Morfey1974/Industrial-Door-PLC-8-Doors/DcmakingCatalog/src/assets/hero-bg.jpg

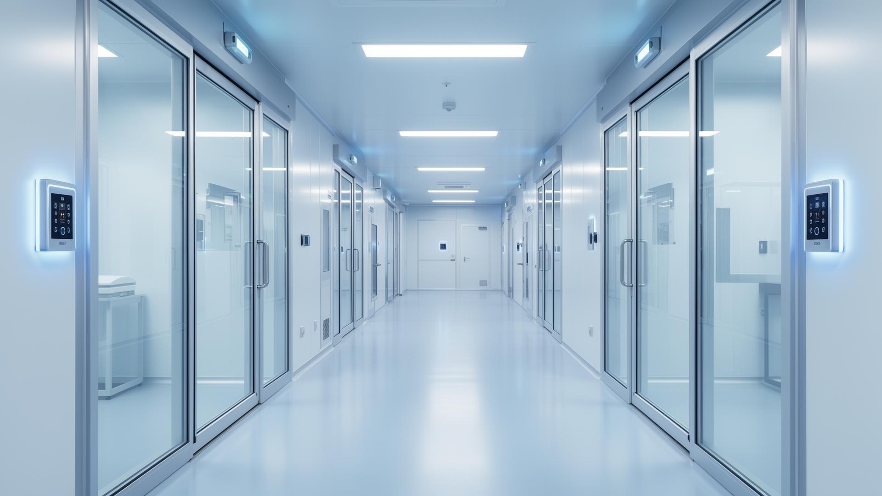
DcmakingCatalog/src/assets/hero-bg.jpg
