Morfey1974/Industrial-Door-PLC-8-Doors/README.md

# Industrial Door PLC

**Название проекта:** Industrial Door PLC — прошивка и Web‑интерфейс промышленного контроллера дверей.

**Цели проекта:** Управление электронными замками дверей в чистых помещениях (NO/NC-логика), зависимостями между дверями, конфигурирование и мониторинг через Web без программирования. Реализация по тезисному плану (этапы 0–14).

**Структура проекта:**
- **`Core/`** — STM32 HAL, FreeRTOS, bring-up (LwIP, CAN, RS-485, QSPI). Тик RTOS: **TIM6** → `xPortSysTickHandler` (см. `Core/Src/main.c`).
- **`BSP/`** — GPIO (двери, замки, LED, кнопки), до **8 дверей на одну плату** (`BSP_DOOR_MAX`).
- **`App/doors/`** — модель двери, DoorTask, DoorHAL; таймауты открытия/после закрытия, сигнализация, спецификация NC (окно разблокировки, задержка блокировки после закрытия).
- **`App/logic/`** — Logic Core, глобальные ID дверей 1…80, зависимости (edges), блокировки по зависимостям; снимок состояния удалённых дверей и **сигнализации с CAN** для API.
- **`App/system/`** — задачи RTOS (net, CAN, RS-485, HTTP, logger, watchdog, supervisor, comms, journal), EventBus, HTTP API/сервер, пользователи.
- **`App/config/`** — формат конфигурации, QSPI (конфиг слоты A/B, маппинг, пользователи), SHA-256, RNG.
- **`App/log/`** — журнал событий в QSPI.
- **`App/drivers/`** — внешняя RTC **DS3231** (I2C), сервис времени (`rtc_service`), опционально задача проверки (`rtc_test_task`).
- **`WebUI/`** — React (Vite): вход, роли, мониторинг дверей и журнала событий, конфигурация, редактор маппинга, настройки, справка.

Документация: **`Documentation/`** (план — `Последовательный тезисный план разработки ПО.pdf`).

---

## Подытож: что сделано по проекту (сводка)

Ниже — фактический функционал репозитория, а не только номера этапов.

### Прошивка (STM32H723)
- **Плата:** до **8 физических дверей** на узел; в системе до **10 узлов × 8 = 80 глобальных дверей** (`CFG_MAX_DOORS`, `APP_MAX_DOORS`).
- **CAN Master–Slave:** протокол STATUS / COMMAND / SERVICE; MASTER (Node **1**) собирает состояние со SLAVE, рассылает команды блокировки; передача **openTimeoutMs** на SLAVE через SERVICE; heartbeat/online.
- **Node ID:** задаётся при сборке макросом **`APP_NODE_ID`** (1 — MASTER, 2…10 — SLAVE). **У каждой SLAVE-платы свой уникальный номер**, иначе коллизии на шине и неверные ID в мониторинге. См. `App/system/system_node.c` и настройки препроцессора в CubeIDE.
- **Logic Core на MASTER:** зависимости между дверями, `lockRequired`, учёт удалённых дверей по CAN; для Web UI — поля **`alarming` / `alarmReasons`** и для удалённых дверей (восстановление из масок **alarmActive / signalingActive** в STATUS).
- **Конфигурация:** формат `config_format.h`, хранение и атомарная активация в **QSPI**; `PUT /api/config`, `PUT /api/config/full` (лимиты v1: до 32 дверей в одном JSON и т.д. — см. `CFG_FULL_MAX_*`).
- **Пользователи:** хранение в QSPI, хеш пароля **SHA-256**, сессионные токены, роли; ограничение попыток входа.
- **Журнал событий** в QSPI, API `stat` / `dump`: обычные записи **EVT0** (32 байта); расширенные **EVT1** (48 байт) для действий из Web с именем пользователя. Служебные дверные типы **`DOOR_OPEN_TIMEOUT`**, **`DOOR_POST_CLOSE_READY`**, **`DOOR_SIGNAL_ON`**, **`DOOR_SIGNAL_OFF`** в кольцевой журнал **не пишутся** (остаются на шине `AppEvents` для логики). В дампе JSON для записей с пользователем поле `username` только если непустое.
- **HTTP:** для **`PUT /api/config/full`** увеличен статический буфер тела запроса на стороне МК (см. `http_server.c`); верхний предел размера JSON на стороне WebUI — `WebUI/src/utils/constants.js` (`PUT_CONFIG_FULL_MAX_JSON_BYTES`).
- **HTTP только на MASTER:** REST API, CORS (в т.ч. **POST**, заголовок **X-Client-Time** для dev с `localhost`); увеличенный стек задачи HTTP при необходимости больших тел ответов.
- **Ethernet:** LwIP, NetTask; IP/порт из конфига (см. `lwip.c` / проектные настройки).
- **RS-485:** инициализация/задача есть; **Modbus RTU как полноценный слейв** — по плану этапа 8, не заявлен как завершённый в текущем цикле задач.
- **RTC DS3231:** драйвер I2C, сервис времени для API; отладочная/сервисная задача и заметки — **`Documentation/RTC_Summary_Handoff.md`**, **`Documentation/DS3231_RTC_Setup.md`**.

### WebUI (React + Vite)
- Авторизация, роли (**super_admin**, **admin**, **operator**), защита маршрутов; состояние сети в шапке.
- **Навигация после входа:** **Мониторинг** → «Двери», «События»; **Конфигурация** (двери, маппинг); **Настройки** (система, профиль, права, пользователи, о программе, справка). В текущей сборке **нет** отдельных страниц «Главная»/Dashboard, «Алармы» и «Статистика» (alarms отображаются в таблице дверей: колонки статуса / причин).
- **Мониторинг дверей:** таблица по узлам (в т.ч. удалённые), фильтры, краткий обзор по платам; кнопка **«Обновить»** с баннером успеха/ошибки (как у применения конфигурации); запрос **`GET /api/doors`** с таймаутом **30 с**; кнопка остаётся видимой при ошибке автообновления, если уже есть кэш данных.
- **Журнал событий:** таблица (№, время, тип, пользователь, ID двери, Drawing ID); фильтры по типу события и ID двери; колонка «Источник» убрана; только дата/время без «N мин назад»; сохранение в CSV, печать, очистка журнала (права super_admin); расшифровка колонок — в разделе **Справка** → «Мониторинг → События». Колонка **Drawing ID** подтягивается из полной конфигурации (`GET /api/config/full`); утилита отображения пользователя в журнале — `WebUI/src/utils/journalUserDisplay.js`.
- **Конфигурация:** общие параметры, двери, зависимости, загрузка полного конфига (`PUT /api/config/full` с лимитом размера).
- **Маппинг** помещений (редактор и режим просмотра с привязкой к состоянию дверей).
- **Очистка Flash по платам (MASTER + SLAVE):**
  - сканирование узлов с детализацией разделов (`Config`, `Mapping`, `Journal`, `Users`);
  - стандартная очистка удаляет только рабочие данные (`Config/Mapping/Journal`);
  - отдельный опасный режим **«Очистить служебные данные»** удаляет также `Users` (служебный раздел) на выбранных узлах.

### Недавние изменения (актуализация UI и журнала, 2026)
- Упрощён журнал в прошивке и в WebUI: меньше «шума» в Flash, понятнее таблица и экспорт.
- Общие строки для баннеров **«Данные успешно обновлены»** / ошибки обновления — `common.refreshDataSuccess` / `common.refreshDataFailed` (ru/en); хук **`useApi.refetch`** возвращает `true`/`false` по результату запроса.

### Эксплуатация и отладка
- Для разработки UI с отдельного origin нужны корректные CORS и достаточный стек `httpTask` (см. историю коммитов и `http_server.c` / `freertos.c`).
- Проверка памяти/журнала — отдельные документы в `Documentation/` (`АНАЛИЗ_*`, `JOURNAL_DIAGNOSTIC.md` и др.).

---

## Статус по этапам (тезисный план)

### Этап 0 — Подготовительный (база проекта)
- **0.1** Репозитории FW/Web — разделение прошивки и WebUI.
- **0.2** Окружение: STM32CubeIDE, Visual Studio (опционально для WebUI).
- **0.3** Фиксация версий библиотек (HAL, LwIP, FreeRTOS и т.п.).
- **0.4** Базовая сборка проекта без логики — плата запускается.

### Этап 1 — Аппаратный слой и низкоуровневые драйверы (FW)
- **1.1** Инициализация STM32H723.
- **1.2** Драйверы GPIO (двери, замки, LED, кнопки).
- **1.3** Драйверы таймеров.
- **1.4** Драйвер CAN.
- **1.5** Драйвер RS-485 (UART + направление).
- **1.6** Драйвер Ethernet (RMII + LwIP).
- **1.7** Драйвер QSPI Flash.

Результат: плата запускается, интерфейсы работают независимо.

### Этап 2 — Базовая RTOS-архитектура прошивки
- **2.1** Выбор и настройка FreeRTOS.
- **2.2** Задачи: Door, Logic Core, CAN, RS-485, Ethernet/HTTP, Logger, Watchdog/Supervisor.
- **2.3** Межзадачное взаимодействие (очереди, события, мьютексы).
- **2.4** Базовый watchdog и контроль зависаний.

Результат: прошивка работает как система задач.

### Этап 3 — Аппаратная модель двери (FW)
- **3.1** Объект «дверь».
- **3.2** Работа с датчиком двери.
- **3.3** Управление замком-соленоидом.
- **3.4** Инварианты: запрет блокировки при открытой двери, safe-state при ошибках.
- **3.5** Индикация и зуммер (базовая).
- **3.6** Кнопка Alarm (локальный приоритет).

Результат: одна дверь работает автономно и безопасно.

### Этап 4 — Логика двери и события (FW)
- **4.1** Состояния двери.
- **4.2** События: OPEN/CLOSE, ALARM, тайм-аут.
- **4.3** Тайм-аут открытой двери.
- **4.4** Тайм-аут после закрытия двери.
- **4.5** Сигнализация.

Результат: дверь корректно реагирует на все события. Подробнее: **`Documentation/Спецификация.md`** (NC: окно разблокировки, задержка после закрытия).

### Этап 5 — Logic Core: логика зависимостей дверей (FW)
- **5.1** Модель зависимостей: дверь → список блокируемых дверей.
- **5.2** Обработка события «дверь открылась».
- **5.3** Вычисление списка блокируемых дверей.
- **5.4** Передача команд на двери (локальные и удалённые).
- **5.5** Разрешение конфликтов логики.

Результат: полная логика в Standalone.

### Этап 6 — CAN: Master–Slave архитектура (FW)
- **6.1** Адресация плат (Node ID).
- **6.2** Роль Master/Slave.
- **6.3** Формат CAN-сообщений.
- **6.4** Синхронизация состояний дверей.
- **6.5** Передача логических команд.
- **6.6** Heartbeat и диагностика.
- **6.7** Режим Degraded при потере CAN.

Результат: многоплатная система работает корректно.

### Этап 7 — Хранение данных и журналирование (FW)
- **7.1** Формат конфигурации (`config_format.h`).
- **7.2** Хранение конфигурации в QSPI Flash.
- **7.3** Атомарная активация конфигурации (слоты A/B, commit последним).
- **7.4** Журнал событий: открытия/закрытия, ALARM, ошибки (`event_journal`, QSPI).
- **7.5** Управление износом памяти (кольцевой буфер, статистика).

Результат: система воспроизводима и диагностируема.

### Этап 8 — RS-485 / Modbus RTU (FW)
- **8.1** Modbus RTU Slave (при необходимости).
- **8.2–8.4** Read-only регистры, состояния дверей, ограничения безопасности — **в основном по плану; низкий уровень RS-485 поднят, полный Modbus — не отмечен как завершённый в коде задачи.**

### Этап 9 — Ethernet и HTTP-сервер (FW)
- **9.1** Запуск Ethernet (LwIP, NetTask).
- **9.2** HTTP-сервер на MASTER (`http_server.c`, `http_task.c`).
- **9.3** REST API: состояние, конфигурация (GET/PUT), журнал (stat, dump), маппинг, время/RTC; аутентификация по Bearer-токену, роли (super_admin, admin, operator), ограничение попыток входа, CORS (в т.ч. методы и заголовки для Web dev).
- **9.4** Web-сеанс: подключение/отключение, редирект после применения конфигурации.
- **9.5** Аутентификация пользователей: логин/пароль, SHA-256, сессионные токены (RNG), сброс пароля по токену.

Результат: контроллер готов к Web-конфигурированию. План безопасности: **`Documentation/SECURITY_REMEDIATION_PLAN.md`**.

### Этап 10 — Web-приложение: база
- **10.1** Архитектура: React, Vite.
- **10.2** Авторизация и роли (super_admin, admin, operator).
- **10.3** Подключение к контроллеру (API, токен в заголовке).
- **10.4** Отображение состояния системы (/api/state, /api/doors; стартовый экран — мониторинг дверей).

Результат: Web видит контроллер и его состояние.

### Этап 11 — Web-конфигуратор
- **11.1** Экран структуры проекта (маппинг).
- **11.2** Экран конфигурирования дверей (общие параметры, двери, зависимости, таймауты).
- **11.3** Экран логики зависимостей (edges в конфиге и UI).
- **11.4** Валидация конфигурации перед отправкой.
- **11.5** Загрузка конфигурации (PUT /api/config, /api/config/full), автосброс платы, редирект на вход.

Результат: полная настройка системы без программирования.

### Этап 12 — Web-мониторинг и журнал
- **12.1** Экран мониторинга дверей.
- **12.2** Карта помещений (режим просмотра маппинга).
- **12.3** Просмотр журнала событий (/api/journal/dump).
- **12.4** Фильтрация и поиск (пагинация, лимит записей).
- **12.x** Отображение **alarms** и причин в таблице мониторинга дверей (в т.ч. для дверей на SLAVE — данные с CAN на MASTER); отдельная страница «Алармы» в текущей ветке UI не используется.

Результат: удобная эксплуатация объекта.

### Этап 13 — Тестирование и валидация
- **13.1–13.5** Модульные тесты логики, интеграционные тесты, стендовые испытания, тесты отказов, нагрузочные тесты — по плану.

### Этап 14 — Производство и сопровождение
- **14.1–14.4** Серийная прошивка, сервисный режим, документация, релизный цикл — по плану.

---

## Документация

| Документ | Описание |
|---|---|
| **`Documentation/Последовательный тезисный план разработки ПО.pdf`** | План этапов 0–14. |
| **`Documentation/API_CONTRACT.md`** | Контракт REST API, безопасность (HTTPS, CORS). |
| **`Documentation/SECURITY_REMEDIATION_PLAN.md`** | План устранения уязвимостей (этапы 1–8). |
| **`Documentation/Спецификация.md`** | Спецификация NC-двери (окно разблокировки, задержка после закрытия). |
| **`Documentation/CONFIG_APPLY_FULL_PLAN.md`** | Полная загрузка конфигурации (вариант A). |
| **`Documentation/План_UI.md`** | План Web UI. |
| **`Documentation/RTC_Summary_Handoff.md`** | RTC / FreeRTOS / отладка (handoff). |
| **`Documentation/DS3231_RTC_Setup.md`** | Подключение и настройка DS3231 в CubeIDE. |
| Остальные `.md` в `Documentation/` | Анализ памяти, журнал, диагностика и др. |

**WebUI:** `WebUI/README.md`, `WebUI/INSTALL_VS.md` — запуск и интеграция в Visual Studio.

---

Разработал **Ключерев Эдуард**, компания **Doors Control Making (DCM)**.
