Morfey1974/Industrial-Door-PLC-8-Doors/WebUI/DESIGN_2025_CONCEPT.md

# Современный дизайн UI 2025 - DCM DOORS CONTROL MAKING

## Концепция дизайна

### Философия
**Профессиональный, надежный, современный** - дизайн отражает промышленную природу системы управления дверями, сочетая функциональность с элегантностью.

### Цветовая палитра (сохраняем существующую)

**Основные цвета:**
- `#3A6577` - Темно-бирюзовый (Primary) - профессионализм, надежность
- `#E6332A` - Красный акцент (Accent) - важность, контроль, предупреждения
- `#EDEDED` - Светло-серый (Secondary) - нейтральность, пространство

**Расширенная палитра:**
- Градиенты на основе основных цветов
- Полупрозрачные варианты для glassmorphism
- Темные варианты для контраста

## Современные тренды 2025

### 1. Glassmorphism (Стеклянный эффект)
- Полупрозрачные панели с размытием фона
- Легкие границы
- Многослойность

### 2. Мягкие тени и глубина
- Неоморфные элементы
- Многоуровневые тени
- 3D эффекты через градиенты

### 3. Плавные анимации
- Микро-интерактивность
- Плавные переходы состояний
- Анимация при наведении

### 4. Пространство и воздух
- Увеличенные отступы
- Больше whitespace
- Четкая иерархия

### 5. Современная типографика
- Улучшенная читаемость
- Правильные веса шрифтов
- Оптимальные размеры

### 6. Скругления и формы
- Мягкие скругления (12-16px)
- Органичные формы
- Плавные переходы

## Структурные изменения

### Header (Верхняя панель)
**Современный подход:**
- Полупрозрачный фон с blur эффектом (glassmorphism)
- Градиентный акцент на логотипе
- Плавающий эффект с мягкой тенью
- Увеличенная высота для лучшей читаемости
- Микро-анимации при наведении

**Визуальные элементы:**
- Логотип с легким свечением
- Плавные переходы при наведении
- Современная типографика для названия

### Sidebar (Боковая панель)
**Обновления:**
- Вертикальный градиент от primary к более темному оттенку
- Иконки для каждого пункта меню (опционально)
- Активный пункт с градиентным фоном
- Плавная анимация при переключении
- Hover эффекты с легким подъемом (lift effect)

### Content Area (Область контента)
**Улучшения:**
- Карточки с glassmorphism эффектом
- Мягкие тени для глубины
- Увеличенные отступы между элементами
- Скругленные углы (16px)
- Плавные переходы при взаимодействии

### Cards (Карточки)
**Современный стиль:**
- Полупрозрачный фон с blur
- Градиентные границы (опционально)
- Hover эффект с легким подъемом
- Плавная анимация появления
- Мягкие тени для глубины

### Buttons (Кнопки)
**Обновления:**
- Градиентные кнопки для primary действий
- Мягкие тени
- Плавные анимации при наведении
- Ripple эффект при клике (опционально)
- Улучшенные состояния (hover, active, disabled)

### Tabs (Вкладки)
**Современный вид:**
- Полупрозрачный фон
- Активная вкладка с градиентом
- Плавная анимация переключения
- Индикатор активной вкладки

### Forms (Формы)
**Улучшения:**
- Плавный фокус на полях ввода
- Градиентные границы при фокусе
- Улучшенная визуальная обратная связь
- Современные placeholder стили

## Специфичные элементы для системы дверей

### Door Status Indicators (Индикаторы состояния дверей)
**Визуализация:**
- Круглые индикаторы с градиентом
- Пульсирующая анимация для алармов
- Плавные переходы цветов
- Иконки дверей (открыта/закрыта)

### Dashboard Cards (Карточки дашборда)
**Стиль:**
- Glassmorphism эффект
- Градиентные акценты
- Иконки с легким свечением
- Анимация при загрузке данных

### Tables (Таблицы)
**Современный вид:**
- Чередующиеся строки с легкой прозрачностью
- Hover эффекты
- Плавные переходы
- Скругленные углы для первой/последней строки

## Анимации и переходы

### Микро-анимации
- Плавное появление элементов (fade in)
- Легкий подъем при hover (lift)
- Пульсация для важных элементов
- Плавные переходы цветов

### Переходы страниц
- Fade переходы
- Slide анимации (опционально)
- Плавная загрузка контента

## Адаптивность

### Responsive Design
- Мобильная версия с адаптивным меню
- Планшеты с оптимизированным layout
- Desktop с максимальным использованием пространства

## Темная тема (опционально, на будущее)
- Адаптация цветов для темной темы
- Сохранение контрастности
- Плавные переходы между темами

## Иконки и визуальные элементы

### Иконки дверей
- SVG иконки открытой/закрытой двери
- Анимированные переходы
- Соответствие цветовой схеме

### Графические элементы
- Декоративные градиенты
- Абстрактные формы (опционально)
- Визуальные разделители

## Типографика

### Шрифты
- Современный sans-serif
- Улучшенная читаемость
- Правильная иерархия размеров
- Оптимальные веса (400, 500, 600, 700)

### Заголовки
- Крупные, выразительные
- Градиентный текст для акцентов (опционально)
- Правильные отступы

## Производительность

### Оптимизация
- CSS анимации вместо JavaScript
- Использование transform и opacity для плавности
- Lazy loading для тяжелых элементов
- Оптимизация изображений

## Доступность

### A11y
- Достаточный контраст цветов
- Фокус-индикаторы
- Поддержка клавиатурной навигации
- Screen reader friendly

## Реализация

### Этапы внедрения
1. Обновление CSS переменных
2. Модернизация компонентов
3. Добавление анимаций
4. Тестирование и полировка
5. Оптимизация производительности

### Файлы для обновления
- `variables.css` - новые переменные
- `layout.css` - обновление layout компонентов
- `components.css` - модернизация компонентов
- Новые CSS файлы для анимаций

## Примеры визуальных эффектов

### Glassmorphism
```css
background: rgba(255, 255, 255, 0.1);
backdrop-filter: blur(10px);
border: 1px solid rgba(255, 255, 255, 0.2);
```

### Градиенты
```css
background: linear-gradient(135deg, #3A6577 0%, #2a4d5a 100%);
```

### Мягкие тени
```css
box-shadow: 0 8px 32px rgba(58, 101, 119, 0.15);
```

### Плавные переходы
```css
transition: all 0.3s cubic-bezier(0.4, 0, 0.2, 1);
```
