Morfey1974/Industrial-Door-PLC-8-Doors/WebUI/DESIGN_2025_IMPLEMENTATION.md

# Реализация современного дизайна UI 2025

## Обзор

Создан современный дизайн для UI системы управления дверями DCM, соответствующий трендам 2025 года. Дизайн сохраняет существующую цветовую схему (#3A6577, #E6332A, #EDEDED) и добавляет современные визуальные эффекты.

## Ключевые особенности нового дизайна

### 1. Glassmorphism (Стеклянный эффект)
- Полупрозрачные панели с размытием фона
- Эффект глубины и многослойности
- Современный, премиальный вид

### 2. Градиенты
- Градиентные кнопки и акценты
- Плавные переходы цветов
- Градиентный текст для логотипа

### 3. Мягкие тени и глубина
- Многоуровневые тени для создания глубины
- Hover эффекты с подъемом элементов
- 3D визуализация через тени

### 4. Плавные анимации
- Микро-интерактивность при наведении
- Плавные переходы состояний (300ms)
- Анимация ripple при клике на кнопки

### 5. Увеличенное пространство
- Больше whitespace между элементами
- Увеличенные отступы (padding)
- Четкая визуальная иерархия

### 6. Современные скругления
- Увеличенные радиусы скругления (16-24px)
- Мягкие, органичные формы
- Полностью скругленные элементы (badges)

## Файлы нового дизайна

### 1. `variables-2025.css`
Расширенные CSS переменные с:
- Градиентами
- Полупрозрачными цветами для glassmorphism
- Улучшенными тенями
- Современными анимациями
- Расширенной типографикой

### 2. `layout-2025.css`
Обновленные стили для:
- Header с glassmorphism эффектом
- Sidebar с градиентом
- Tabs с современным дизайном
- Layout с улучшенным spacing
- Login page с анимированным фоном

### 3. `components-2025.css`
Модернизированные компоненты:
- Кнопки с градиентами и ripple эффектом
- Поля ввода с улучшенным фокусом
- Таблицы с hover эффектами
- Карточки с glassmorphism
- Бейджи статусов с градиентами

## Применение нового дизайна

### Вариант 1: Постепенное внедрение (рекомендуется)

1. **Создать резервную копию текущих стилей:**
   ```bash
   cp variables.css variables-backup.css
   cp layout.css layout-backup.css
   cp components.css components-backup.css
   ```

2. **Заменить импорты в `main.css`:**
   ```css
   @import './variables-2025.css';
   @import './components-2025.css';
   @import './layout-2025.css';
   ```

3. **Тестирование и корректировка**

### Вариант 2: Создать новую тему (для A/B тестирования)

1. Создать переключатель тем
2. Применять стили условно
3. Сравнить результаты

## Визуальные улучшения по компонентам

### Header (Верхняя панель)
- ✅ Glassmorphism фон с blur
- ✅ Градиентный логотип (DCM)
- ✅ Плавающий эффект при hover
- ✅ Улучшенные тени
- ✅ Sticky позиционирование

### Sidebar (Боковая панель)
- ✅ Градиентный фон
- ✅ Glassmorphism для пунктов меню
- ✅ Анимация при hover (сдвиг вправо)
- ✅ Активный пункт с градиентом accent
- ✅ Индикатор активного пункта (полоска справа)

### Buttons (Кнопки)
- ✅ Градиентные primary кнопки
- ✅ Ripple эффект при клике
- ✅ Подъем при hover
- ✅ Улучшенные тени
- ✅ Плавные переходы

### Cards (Карточки)
- ✅ Glassmorphism эффект
- ✅ Подъем при hover
- ✅ Градиентные границы (опционально)
- ✅ Улучшенные тени

### Tables (Таблицы)
- ✅ Скругленные углы
- ✅ Hover эффекты для строк
- ✅ Градиентный header
- ✅ Плавные переходы

### Forms (Формы)
- ✅ Улучшенный фокус с glow эффектом
- ✅ Плавные переходы
- ✅ Современные placeholder стили

## Анимации

### Микро-анимации
- **Hover lift:** элементы поднимаются на 2-4px
- **Scale:** легкое увеличение при hover
- **Fade:** плавное появление элементов
- **Ripple:** волна при клике на кнопки

### Переходы
- **Базовый:** 300ms cubic-bezier(0.4, 0, 0.2, 1)
- **Быстрый:** 150ms
- **Медленный:** 500ms
- **Bounce:** 600ms с bounce эффектом

## Специфичные элементы для дверей

### Door Status Indicators
- Градиентные индикаторы
- Пульсирующая анимация для алармов
- Плавные переходы цветов
- Иконки с тенями

### Dashboard Cards
- Glassmorphism эффект
- Градиентные акценты
- Иконки с легким свечением
- Анимация при загрузке

## Производительность

### Оптимизации
- CSS анимации (transform, opacity) вместо JavaScript
- Hardware acceleration через transform
- Минимальное использование backdrop-filter (где необходимо)
- Оптимизированные градиенты

### Поддержка браузеров
- Современные браузеры (Chrome, Firefox, Safari, Edge)
- Fallback для старых браузеров (без glassmorphism)
- Graceful degradation

## Доступность

### A11y улучшения
- Достаточный контраст цветов (WCAG AA)
- Видимые фокус-индикаторы
- Поддержка клавиатурной навигации
- Screen reader friendly

## Тестирование

### Чек-лист перед применением
- [ ] Проверить все страницы
- [ ] Проверить все компоненты
- [ ] Проверить адаптивность
- [ ] Проверить производительность
- [ ] Проверить доступность
- [ ] Проверить в разных браузерах

## Обратная совместимость

### Сохранение функциональности
- Все существующие классы работают
- Добавлены новые классы для улучшений
- Можно применять постепенно

## Следующие шаги

1. **Применить новые стили** (заменить импорты)
2. **Тестирование** на всех страницах
3. **Корректировка** при необходимости
4. **Оптимизация** производительности
5. **Документирование** изменений

## Примеры использования

### Glassmorphism карточка
```css
.card {
  background: rgba(255, 255, 255, 0.8);
  backdrop-filter: blur(10px);
  border: 1px solid rgba(255, 255, 255, 0.5);
}
```

### Градиентная кнопка
```css
.btn-primary {
  background: linear-gradient(135deg, #E6332A 0%, #c42a22 100%);
}
```

### Hover эффект с подъемом
```css
.element:hover {
  transform: translateY(-4px);
  box-shadow: 0 12px 48px rgba(58, 101, 119, 0.18);
}
```

## Заключение

Новый дизайн 2025 года:
- ✅ Сохраняет цветовую схему
- ✅ Добавляет современные эффекты
- ✅ Улучшает UX
- ✅ Соответствует трендам 2025
- ✅ Отражает профессиональную природу системы

Готов к применению и тестированию!
