Morfey1974/Industrial-Door-PLC-8-Doors/WebUI/DESIGN_2025_QUICK_START.md

# Быстрый старт: Применение дизайна 2025

## Что создано

### Новые CSS файлы:
1. **`variables-2025.css`** - Расширенные CSS переменные
2. **`layout-2025.css`** - Современные стили layout
3. **`components-2025.css`** - Обновленные компоненты

### Документация:
1. **`DESIGN_2025_CONCEPT.md`** - Концепция дизайна
2. **`DESIGN_2025_IMPLEMENTATION.md`** - Инструкция по реализации
3. **`DESIGN_2025_VISUAL_GUIDE.md`** - Визуальное руководство

## Как применить новый дизайн

### Шаг 1: Резервное копирование (рекомендуется)
```bash
# Создать копии текущих файлов
cp WebUI/src/styles/variables.css WebUI/src/styles/variables-backup.css
cp WebUI/src/styles/layout.css WebUI/src/styles/layout-backup.css
cp WebUI/src/styles/components.css WebUI/src/styles/components-backup.css
```

### Шаг 2: Заменить файлы
```bash
# Скопировать новые файлы
cp WebUI/src/styles/variables-2025.css WebUI/src/styles/variables.css
cp WebUI/src/styles/layout-2025.css WebUI/src/styles/layout.css
cp WebUI/src/styles/components-2025.css WebUI/src/styles/components.css
```

### Или вручную:
1. Открыть `WebUI/src/styles/main.css`
2. Убедиться, что импорты правильные:
   ```css
   @import './variables.css';
   @import './components.css';
   @import './layout.css';
   ```
3. Заменить содержимое файлов на новые версии

### Шаг 3: Тестирование
1. Запустить приложение
2. Проверить все страницы:
   - Login
   - Dashboard
   - Мониторинг
   - Конфигурация
   - Настройки
3. Проверить все компоненты:
   - Кнопки
   - Формы
   - Таблицы
   - Карточки
   - Модальные окна

### Шаг 4: Корректировка (при необходимости)
- Если что-то выглядит неправильно, можно вернуться к backup файлам
- Или скорректировать конкретные стили

## Основные изменения

### Визуальные эффекты:
- ✅ Glassmorphism (полупрозрачные панели)
- ✅ Градиенты на кнопках и акцентах
- ✅ Улучшенные тени для глубины
- ✅ Плавные анимации при hover
- ✅ Ripple эффект на кнопках

### Компоненты:
- ✅ Header с blur эффектом
- ✅ Sidebar с градиентом
- ✅ Кнопки с градиентами
- ✅ Карточки с glassmorphism
- ✅ Таблицы с hover эффектами

### Spacing:
- ✅ Увеличенные отступы
- ✅ Больше whitespace
- ✅ Улучшенная иерархия

## Откат изменений (если нужно)

```bash
# Вернуть старые файлы
cp WebUI/src/styles/variables-backup.css WebUI/src/styles/variables.css
cp WebUI/src/styles/layout-backup.css WebUI/src/styles/layout.css
cp WebUI/src/styles/components-backup.css WebUI/src/styles/components.css
```

## Что проверить после применения

- [ ] Header выглядит современно с glassmorphism
- [ ] Sidebar имеет градиент и анимации
- [ ] Кнопки имеют градиенты и ripple эффект
- [ ] Карточки имеют glassmorphism
- [ ] Таблицы имеют hover эффекты
- [ ] Все анимации плавные
- [ ] Цветовая схема сохранена (#3A6577, #E6332A, #EDEDED)
- [ ] Нет визуальных багов
- [ ] Все работает корректно

## Поддержка

Если возникнут проблемы:
1. Проверить консоль браузера на ошибки
2. Убедиться, что все файлы загружены
3. Очистить кэш браузера
4. Проверить импорты в main.css

## Готово!

После применения нового дизайна UI будет выглядеть современно и профессионально, соответствуя трендам 2025 года, при этом сохраняя вашу цветовую схему и концепцию DCM DOORS CONTROL MAKING.
