Morfey1974/Industrial-Door-PLC-8-Doors/REMINDERS.md

# Напоминалка

Краткие заметки, чтобы не забыть. Отмечайте выполнение: замените `[ ]` на `[x]`.

---

1. - [ ] Нужно продумать возможность создания конфигурации для прописки доступа по картридеру.
2. - [ ] Нужно подумать о Мегадим
3. - [ ] Организовать выгрузку с сайта на мой домен.
4. - [ ] Продумать подключение модуля RTC к нашему контроллеру.

---

*Добавляйте новые строки в формате: `N. - [ ] Ваше сообщение` (N — следующий номер).*
