Morfey1974/Industrial-Door-PLC-8-Doors/Documentation/Спецификация.md

Финальная спецификация NC-двери
Поведение
ALARM — импульс
Каждое нажатие ALARM запускает или продлевает окно разблокировки.
Приоритет MASTER
Разблокировка возможна только если LogicCore не требует блокировку (locked из LogicCore = 0).
Проверка: LogicCore_IsLockRequired(gid) == 0.
Окно разблокировки
Глобальный параметр ncUnlockWindowMs (по умолчанию 5000 мс).
При разрешённом импульсе дверь разблокируется на ncUnlockWindowMs.
Повторный импульс в течение окна — таймер сбрасывается.
Если дверь не открылась до истечения окна — замок снова блокируется.
Блокировка после закрытия NC
Глобальный параметр ncLockDelayAfterCloseMs (по умолчанию 1000 мс).
После физического закрытия — ждать ncLockDelayAfterCloseMs и заблокировать.
Это не postCloseTimeoutMs — отдельная переменная для NC.
Зависимости
Открытие NC: зависимости активны.
Закрытие NC: сразу EVT_DOOR_POST_CLOSE_READY (как для NC без post-close).
Зависимые двери возвращаются в свои состояния по логике.
Без сигнализации
Нет LED-мигания и buzzer при нажатии ALARM.
Параметры конфигурации (вкладка «Общие параметры»)
Поле	Ключ в JSON	Единица	По умолчанию
Окно разблокировки NC (с)	ncUnlockWindowSec / ncUnlockWindowMs	с / мс	5
Задержка блокировки NC после закрытия (с)	ncLockDelayAfterCloseSec / ncLockDelayAfterCloseMs	с / мс	1
План изменений в коде
1. Прошивка
1.1 App/config/config_format.h
В project_config_t добавить:
  uint32_t ncUnlockWindowMs;        /* окно разблокировки NC, мс (по умолч. 5000) */  uint32_t ncLockDelayAfterCloseMs; /* задержка блокировки NC после закрытия, мс (по умолч. 1000) */
Расположить рядом с openTimeoutMs в секции таймаутов.
1.2 App/config/config_format.c
В Config_Default() задать:
cfg->ncUnlockWindowMs = 5000U;
cfg->ncLockDelayAfterCloseMs = 1000U;
В Config_Validate() проверять диапазоны (например, 100–60000 мс).
В Config_Finalize() — не менять (если валидации достаточно).
1.3 App/doors/doors_task.h
Добавить:
  uint8_t  DoorsCfg_SetNcUnlockWindowMs(uint32_t ms);  uint32_t DoorsCfg_GetNcUnlockWindowMs(void);  uint8_t  DoorsCfg_SetNcLockDelayAfterCloseMs(uint32_t ms);  uint32_t DoorsCfg_GetNcLockDelayAfterCloseMs(void);
В AppDoorState_t (или рядом) добавить состояние NC-окна:
ncUnlockWindowEndMs — момент окончания окна разблокировки (0 = окно не активно)
ncLockAfterCloseStartMs — начало отсчёта задержки после закрытия (0 = не ждём)
ncLockAfterClosePending — флаг ожидания блокировки после закрытия.
1.4 App/doors/doors_task.c
Добавить:
s_cfgNcUnlockWindowMs и s_cfgNcLockDelayAfterCloseMs с реализацией get/set.
Логику NC по импульсу:
На импульс ALARM: проверять door_is_nc_type().
Если NC: вызывать LogicCore_IsLockRequired(gid) (через новый API). Если 1 — не разблокировать.
Если 0: запустить окно — ncUnlockWindowEndMs = now + ncUnlockWindowMs, при уже активном окне — сбросить таймер.
Каждый цикл для NC:
Если now > ncUnlockWindowEndMs и дверь закрыта — блокировать и сбросить окно.
При переходе OPEN→CLOSE: запустить ncLockAfterClosePending, ncLockAfterCloseStartMs = now.
Когда now - ncLockAfterCloseStartMs >= ncLockDelayAfterCloseMs — заблокировать и сбросить состояние.
Удалить:
s_ncPassageActive, s_lockSavedBeforeNcPassage
Текущий toggle по ALARM для NC.
Окно NC учитывать при выборе выхода: если окно активно — разблокировка (как applyNcPassage).
1.5 App/logic/logic_core.h
Добавить:
  uint8_t LogicCore_IsLockRequired(uint8_t globalDoorId);
1.6 App/logic/logic_core.c
Реализовать LogicCore_IsLockRequired() — чтение lc->lockRequired для заданного globalDoorId.
Требуется доступ к глобальному/единственному экземпляру logic_core_t (например, через LogicTask).
1.7 App/system/config_service.c
В apply_cfg_runtime():
Вызывать DoorsCfg_SetNcUnlockWindowMs(cfg->ncUnlockWindowMs).
Вызывать DoorsCfg_SetNcLockDelayAfterCloseMs(cfg->ncLockDelayAfterCloseMs).
Убрать переопределение timeout = 0 для NC в секции postCloseTimeoutMs (NC использует ncLockDelayAfterCloseMs).
1.8 App/system/http_api.c
В put_config_full и get_config_full:
Парсить и отдавать ncUnlockWindowMs и ncLockDelayAfterCloseMs.
В put_config (merge) — добавить эти поля, если merge их поддерживает.
1.9 App/system/can_task.c (при необходимости)
Если NC-параметры должны передаваться на SLAVE — добавить их в CanTask_SendConfigParams и приём на SLAVE (аналогично openTimeoutMs).
2. WebUI
2.1 WebUI/src/pages/Configuration/DoorsConfigTabs/GeneralTab.jsx
Добавить два поля после «Таймаут для сигнализации»:
«Окно разблокировки NC (с)» — число, 1–60, по умолчанию 5.
«Задержка блокировки NC после закрытия (с)» — число, 0–30, по умолчанию 1.
Связать с config.ncUnlockWindowMs и config.ncLockDelayAfterCloseMs (через updateConfig).
2.2 WebUI/src/pages/Configuration/DoorsConfig.jsx
В начальное состояние и при загрузке с сервера добавить:
ncUnlockWindowMs: 5000
ncLockDelayAfterCloseMs: 1000
В handleApplyToController и loadConfigFromServer — читать/отправлять эти поля.
В handleSaveConfig и handleImport — сохранять/загружать из JSON.
2.3 WebUI/src/utils/configValidator.js
Добавить валидацию:
ncUnlockWindowMs (100–60000)
ncLockDelayAfterCloseMs (0–30000)
2.4 WebUI/src/pages/Settings/HelpContent.jsx
Добавить описание новых полей NC.
2.5 WebUI/src/pages/Configuration/DoorsConfigTabs/DoorEditModal.jsx
Обновить подсказку для NC: «Импульс ALARM — окно разблокировки. MASTER имеет приоритет.»
3. Структура состояния NC в doors_task
Состояние per-door для NC:- ncUnlockWindowEndMs     — 0 или время окончания окна- ncLockAfterCloseStartMs — 0 или время начала задержки- ncLockAfterClosePending — 0/1Импульс ALARM (NC):  if LogicCore_IsLockRequired(gid) return;  ncUnlockWindowEndMs = now + ncUnlockWindowMs;Каждый цикл (NC):  if ncUnlockWindowEndMs && now > ncUnlockWindowEndMs && physClosed:    lock door, ncUnlockWindowEndMs = 0  if physClosed && !ncLockAfterClosePending:    ncLockAfterCloseStartMs = now, ncLockAfterClosePending = 1  if ncLockAfterClosePending && (now - ncLockAfterCloseStartMs >= ncLockDelayAfterCloseMs):    lock door, ncLockAfterClosePending = 0, ncLockAfterCloseStartMs = 0
4. Важные моменты
Зависимости
Для NC при закрытии нужно продолжать публиковать EVT_DOOR_POST_CLOSE_READY сразу (без post-close), чтобы LogicCore обрабатывал зависимости.
Циклические зависимости
logic_core.h не должен включать doors_task.h.
doors_task.c включает logic_core.h и вызывает LogicCore_IsLockRequired().
Это допустимо, если logic_core.h объявляет только эту функцию.
Совместимость конфига
При отсутствии полей в JSON использовать значения по умолчанию (5000 мс и 1000 мс).
Версия формата
При добавлении полей в project_config_t стоит обновить CFG_FORMAT_VERSION и предусмотреть миграцию старых конфигов.
