Morfey1974/Industrial-Door-PLC-8-Doors/Documentation/План_UI.md

# План разработки Web-интерфейса для Industrial Door PLC

## Дата создания: 2026-01-23

---

## 1. ЦВЕТОВАЯ СХЕМА (принята из набросков)

### Основные цвета:
- **`#3A6577`** — Темно-бирюзовый (основной фон хедера, боковой панели)
- **`#EDEDED`** — Светло-серый (фон контента, неактивные элементы)
- **`#E6332A`** — Красный акцент (логотип, границы кнопок, активные элементы)

### Дополнительные цвета:
- **Белый** — фон кнопок, основной контент
- **Темно-серый/Черный** — текст на светлом фоне
- **Белый** — текст на темном фоне (#3A6577)

---

## 2. СТРУКТУРА ИНТЕРФЕЙСА

### 2.1 Общий Layout

```
┌─────────────────────────────────────────────────────────┐
│ [DCM Logo]                    [👤 Профиль пользователя] │ ← Хедер (#3A6577)
├──────────────┬──────────────────────────────────────────┤
│              │                                           │
│ Боковая      │  Основная область контента               │
│ панель       │  (белый фон)                             │
│ (#3A6577)    │                                           │
│              │                                           │
│ [Кнопки      │                                           │
│  навигации]  │                                           │
│              │                                           │
├──────────────┴──────────────────────────────────────────┤
│ [Мониторинг] [Конфигурация] [Настройки]                │ ← Вкладки (низ)
└─────────────────────────────────────────────────────────┘
```

### 2.2 Компоненты интерфейса

#### Верхний хедер:
- **Логотип DCM** (слева) — красный акцент
- **Профиль пользователя** (справа) — выпадающее меню:
  - Имя пользователя
  - Роль (Администратор/Клиент)
  - Настройки
  - Выход

#### Левая боковая панель:
- Динамическая навигация в зависимости от активной вкладки
- Кнопки с единым стилем:
  - Белый фон
  - Красная граница (#E6332A)
  - Скругленные углы
  - Темный текст

#### Основная область контента:
- Белый фон
- Адаптивная ширина
- Скругленные углы для карточек/панелей

#### Нижние вкладки:
- Горизонтальная панель
- Активная вкладка: белый фон
- Неактивная: светло-серый фон (#EDEDED)

---

## 3. СТРУКТУРА МЕНЮ И РАЗДЕЛОВ

### 3.1 Стартовая страница (Login)
**Статус:** UI готов, бэкенд (9.5) — позже

**Элементы:**
- Логотип DCM
- Форма входа:
  - Поле "Логин" (dropdown): Администратор / Клиент
  - Поле "Пароль" (password)
  - Кнопка "Вход"
- По умолчанию: `Admin` / `Admin`

**Цвета:**
- Фон формы: #3A6577
- Кнопки: белый фон, красная граница
- Логотип: красный акцент

---

### 3.2 Dashboard / Главная страница
**Статус:** Реализуем в первой версии

**Содержимое:**
- Общее состояние системы (из `/api/state`):
  - NodeID, Role
  - LinkUp, NetReady
  - IP адрес
  - Uptime
- Быстрый обзор всех дверей (краткая таблица/карточки)
- Статусные индикаторы

**API:** `GET /api/state`, `GET /api/doors`

---

### 3.3 Вкладка "Мониторинг"

#### 3.3.1 Подраздел "Двери"
**Статус:** Реализуем в первой версии

**Содержимое:**
- Таблица состояния всех дверей
- Колонки:
  - ID двери
  - Физическое состояние (закрыта/открыта)
  - Замок (заблокирована/разблокирована)
  - Alarm (да/нет)
  - Время открытия (секунды)
  - Оставшееся время до закрытия (секунды)
- Фильтры:
  - По статусу (все/открытые/закрытые/с Alarmми)
  - По ID двери

**API:** `GET /api/doors`

**Примечание:** "Просмотр карты" (визуализация плана этажа) — отложено на будущее

---

#### 3.3.2 Подраздел "События"
**Статус:** Реализуем в первой версии

**Содержимое:**
- Таблица журнала событий с пагинацией
- Колонки:
  - Последовательный номер (recSeq)
  - Время (timestamp)
  - Тип события (DOOR_OPEN, DOOR_CLOSE, и т.д.)
  - Источник (DOOR_LOCAL, HTTP, CAN, и т.д.)
  - ID двери
  - Дополнительные параметры
- Фильтры:
  - По типу события
  - По двери
  - По источнику
- Пагинация: offset, limit (по умолчанию 20 записей)

**API:** `GET /api/journal/dump?offset=0&limit=20`

---

#### 3.3.3 Подраздел "Алармы"
**Статус:** Реализуем в первой версии

**Содержимое:**
- Таблица дверей с активными Alarmми
- Фильтр по `alarming == 1` из `/api/doors`
- Отображение причин аварии (`alarmReasons`)

**API:** `GET /api/doors` (фильтрация на клиенте)

---

#### 3.3.4 Подраздел "Статистика"
**Статус:** Минимальная версия в первой итерации

**Содержимое (минимальное):**
- Время открытия/закрытия дверей (из журнала событий)
- Количество аварий
- Общая статистика по событиям

**Будущее расширение:**
- Привязка событий к пользователю (кто выполнил действие)
- Время записи конфигурации
- История изменений конфигурации с указанием пользователя

**API:** `GET /api/journal/dump`, `GET /api/journal/stat`

**Примечание:** Полная статистика с привязкой к пользователям будет реализована после этапа 9.5 (аутентификация)

---

### 3.4 Вкладка "Конфигурация"

#### 3.4.1 Подраздел "Настройка дверей"
**Статус:** Реализуем в первой версии (базовая версия)

**Содержимое:**
- Просмотр текущей конфигурации
- Редактирование параметров:
  - `projectName`
  - `openTimeoutMs`
  - `doorCount` (только просмотр)
- Кнопка "Сохранить"

**API:** `GET /api/config`, `PUT /api/config`

**Примечание:** Полная настройка дверей (создание карты, логика, доступ) — отложено на будущее

---

#### 3.4.2 Подраздел "Сетевые настройки"
**Статус:** Реализуем в первой версии

**Содержимое:**
- DHCP включен/выключен
- Web порт
- IP адрес (только просмотр, если DHCP выключен)

**API:** `GET /api/config`, `PUT /api/config` (через объект `net`)

---

#### 3.4.3 Подраздел "Параметры системы"
**Статус:** Реализуем в первой версии

**Содержимое:**
- Версия формата конфигурации
- Последовательный номер конфигурации (seq)
- Статистика журнала (из `/api/journal/stat`)

**API:** `GET /api/config`, `GET /api/journal/stat`

**Примечание:** 
- "Создание карты" — отложено
- "Логика" — отложено
- "Доступ" (управление пользователями) — будет в этапе 9.5

---

### 3.5 Вкладка "Отчеты"
**Статус:** Отложено на будущее

**Содержимое:**
- Экспорт журнала событий
- Генерация отчетов
- История изменений

---

### 3.6 Вкладка "Настройки"
**Статус:** Базовая версия в первой итерации

**Содержимое:**
- Профиль пользователя (имя, роль)
- Управление пользователями (только для администратора) — будет после этапа 9.5
- Настройки интерфейса (если понадобится)

---

## 4. СТИЛИСТИКА КОМПОНЕНТОВ

### 4.1 Кнопки (единый стиль)
- **Фон:** Белый
- **Граница:** 2px solid #E6332A
- **Текст:** Темно-серый/черный
- **Скругление:** 6-8px
- **Тень:** Легкая тень для эффекта "поднятости"
- **Hover:** Легкое затемнение фона или изменение цвета границы
- **Active:** Более выраженное нажатие
- **Disabled:** Полупрозрачность (opacity: 0.5)

### 4.2 Таблицы
- **Фон:** Белый
- **Границы:** Светло-серые (#EDEDED)
- **Заголовки:** Темно-бирюзовый фон (#3A6577), белый текст
- **Чередование строк:** Легкий серый фон для четных строк
- **Hover на строке:** Легкое выделение

### 4.3 Поля ввода
- **Фон:** Белый
- **Граница:** Светло-серая (#EDEDED)
- **Фокус:** Красная граница (#E6332A)
- **Скругление:** 4px

### 4.4 Карточки/Панели
- **Фон:** Белый
- **Граница:** Светло-серая (#EDEDED)
- **Скругление:** 8px
- **Тень:** Легкая тень

---

## 5. ТЕХНИЧЕСКАЯ АРХИТЕКТУРА

### 5.1 Выбранный стек: React

**Решение:** Использовать React, так как:
- Проект будет сложным (логика дверей, взаимосвязи, карта)
- Нужны мощные инструменты для разработки
- Web-интерфейс НЕ встраивается в прошивку (отдельное приложение)
- В прошивку пойдет только конфигурация (данные), а не сам интерфейс

**Преимущества React для этого проекта:**
1. **Компонентный подход** — легко создавать переиспользуемые компоненты (кнопки, таблицы, карточки дверей)
2. **Реактивность** — автоматическое обновление UI при изменении данных из API
3. **Управление состоянием** — Context API и хуки для глобального состояния (аутентификация, настройки)
4. **Роутинг** — React Router для навигации между страницами (SPA)
5. **Хуки** — кастомные хуки для API запросов, автообновления, аутентификации
6. **Экосистема** — множество библиотек для форм, графиков, таблиц
7. **Инструменты разработки** — React DevTools, горячая перезагрузка (HMR)
8. **Масштабируемость** — легко добавлять новые функции (карта, логика дверей, взаимосвязи)
9. **Производительность** — виртуальный DOM, оптимизация рендеринга
10. **Поддержка** — большое сообщество, много ресурсов и примеров

### 5.2 Структура проекта React

```
WebUI/
├── public/
│   ├── index.html
│   └── favicon.ico
├── src/
│   ├── index.jsx              (точка входа)
│   ├── App.jsx                (главный компонент, роутинг)
│   ├── assets/
│   │   └── logo/              (логотип DCM)
│   ├── components/
│   │   ├── layout/
│   │   │   ├── Header.jsx     (верхний хедер)
│   │   │   ├── Sidebar.jsx    (боковая панель)
│   │   │   ├── Tabs.jsx       (нижние вкладки)
│   │   │   └── Layout.jsx     (общий layout)
│   │   ├── common/
│   │   │   ├── Button.jsx     (кнопка с единым стилем)
│   │   │   ├── Table.jsx      (таблица)
│   │   │   ├── Card.jsx       (карточка)
│   │   │   ├── Input.jsx      (поле ввода)
│   │   │   └── Dropdown.jsx   (выпадающий список)
│   │   └── ui/
│   │       ├── DoorCard.jsx   (карточка двери)
│   │       ├── EventRow.jsx   (строка события)
│   │       └── StatusBadge.jsx (индикатор статуса)
│   ├── pages/
│   │   ├── Login.jsx          (страница входа)
│   │   ├── Dashboard.jsx     (главная страница)
│   │   ├── Monitoring/
│   │   │   ├── Doors.jsx      (мониторинг дверей)
│   │   │   ├── Events.jsx    (журнал событий)
│   │   │   ├── Alarms.jsx    (аварии)
│   │   │   └── Statistics.jsx (статистика)
│   │   ├── Configuration/
│   │   │   ├── DoorsConfig.jsx (настройка дверей)
│   │   │   ├── NetworkConfig.jsx (сетевые настройки)
│   │   │   └── SystemParams.jsx (параметры системы)
│   │   └── Settings/
│   │       └── Profile.jsx    (профиль пользователя)
│   ├── services/
│   │   ├── api.js             (обертка над HTTP API контроллера)
│   │   ├── auth.js            (аутентификация, будет после 9.5)
│   │   └── config.js          (управление конфигурацией)
│   ├── hooks/
│   │   ├── useApi.js          (хук для API запросов)
│   │   ├── useAutoRefresh.js  (автообновление данных)
│   │   └── useAuth.js         (хук для аутентификации)
│   ├── utils/
│   │   ├── formatters.js      (форматирование данных)
│   │   ├── validators.js      (валидация форм)
│   │   └── constants.js       (константы, цвета)
│   ├── styles/
│   │   ├── main.css           (глобальные стили)
│   │   ├── variables.css      (CSS переменные для цветов)
│   │   ├── components.css     (стили компонентов)
│   │   └── layout.css         (стили layout)
│   └── context/
│       ├── AuthContext.jsx    (контекст аутентификации)
│       └── AppContext.jsx     (глобальный контекст приложения)
├── package.json
├── vite.config.js             (или webpack.config.js)
├── .gitignore
└── README.md
```

### 5.3 Технологии

**Основной стек:**
- **React 18+** — UI библиотека
- **React Router** — маршрутизация (SPA)
- **Vite** — сборщик и dev-сервер (быстрый, современный)
- **CSS Modules** или **Styled Components** (опционально) — стилизация

**Дополнительные библиотеки (по необходимости):**
- **Axios** или **Fetch API** — HTTP запросы
- **React Query** или **SWR** — управление состоянием сервера, кэширование
- **React Hook Form** — управление формами
- **Date-fns** — работа с датами/временем
- **Recharts** или **Chart.js** — графики для статистики (если понадобится)

**Инструменты разработки:**
- **ESLint** — линтинг кода
- **Prettier** — форматирование кода
- **TypeScript** (опционально) — типизация (можно добавить позже)

### 5.4 Размещение в проекте

- **Папка:** `WebUI/` в корне workspace STM32CubeIDE
- **Разработка:** 
  - Visual Studio Code (рекомендуется для React)
  - Или Visual Studio (с поддержкой Node.js проектов)
- **Запуск:** Отдельное приложение, работает независимо от прошивки
- **Деплой:** 
  - Статический хостинг (nginx, Apache)
  - Или отдельный веб-сервер
  - Или встроенный веб-сервер на контроллере (если понадобится позже)

### 5.5 Взаимодействие с контроллером

- **API Endpoint:** `http://<IP_контроллера>:<port>/api/*`
- **CORS:** Контроллер уже поддерживает CORS (`Access-Control-Allow-Origin: *`)
- **Протокол:** HTTP/1.1, JSON
- **Аутентификация:** Будет добавлена в этапе 9.5 (сессии, токены)

### 5.6 Конфигурация дверей

**Важно:** В прошивку пойдет только **конфигурация** (данные):
- Логика работы дверей
- Взаимосвязи между дверьми
- Параметры (таймауты, правила)
- НЕ сам Web-интерфейс

**Формат передачи:**
- Web UI → `PUT /api/config` → Контроллер → Сохранение в QSPI Flash

---

## 6. ПЛАН РЕАЛИЗАЦИИ (поэтапно)

### Этап 1: Настройка проекта React и базовая структура
**Цель:** Создать React проект с правильной структурой и дизайн-системой

**Задачи:**
1. Инициализировать React проект (Vite или Create React App)
2. Настроить структуру папок согласно плану
3. Установить зависимости: React Router, Axios (или использовать Fetch)
4. Создать CSS переменные для цветовой схемы (#3A6577, #EDEDED, #E6332A)
5. Создать базовые компоненты layout:
   - `Header.jsx` — верхний хедер
   - `Sidebar.jsx` — боковая панель
   - `Tabs.jsx` — нижние вкладки
   - `Layout.jsx` — общий layout
6. Создать базовый компонент `Button.jsx` с единым стилем
7. Настроить React Router для навигации
8. Создать базовую структуру страниц (пустые компоненты)

**Результат:** Рабочий React проект с правильной структурой и визуальным каркасом

---

### Этап 2: Страница входа (Login) и аутентификация
**Цель:** UI для аутентификации (бэкенд будет позже в 9.5)

**Задачи:**
1. Создать компонент `Login.jsx` с формой входа
2. Добавить логотип DCM
3. Реализовать компонент `Dropdown.jsx` для выбора роли (Администратор/Клиент)
4. Поле пароля (тип password)
5. Кнопка "Вход" с использованием компонента `Button.jsx`
6. Валидация формы (React Hook Form или нативный state)
7. Создать `AuthContext.jsx` для управления состоянием аутентификации
8. Переход на главную страницу после "входа" (пока без реальной аутентификации)
9. Защита маршрутов (PrivateRoute компонент)

**Результат:** Рабочая страница входа с контекстом аутентификации (UI готов, бэкенд — позже)

---

### Этап 3: API интеграция и хуки
**Цель:** Подключение к существующим API endpoints через React

**Задачи:**
1. Создать `services/api.js` с функциями для всех endpoints:
   - `getState()` → `GET /api/state`
   - `getDoors()` → `GET /api/doors`
   - `getConfig()` → `GET /api/config`
   - `putConfig(data)` → `PUT /api/config`
   - `getJournalStat()` → `GET /api/journal/stat`
   - `getJournalDump(offset, limit)` → `GET /api/journal/dump`
2. Создать кастомный хук `useApi.js` для работы с API:
   - Состояние загрузки (loading)
   - Обработка ошибок
   - Кэширование (опционально)
3. Создать хук `useAutoRefresh.js` для автообновления данных
4. Настроить базовый URL контроллера (конфигурация)
5. Обработка ошибок сети и таймауты

**Результат:** Готовый модуль API и хуки для работы с контроллером

---

### Этап 4: Dashboard / Главная страница
**Цель:** Отображение общего состояния системы

**Задачи:**
1. Создать компонент `Dashboard.jsx`
2. Использовать хук `useApi` для получения данных из `/api/state`
3. Создать компонент `StatusCard.jsx` для отображения метрик:
   - NodeID, Role, LinkUp, NetReady, IP, Uptime
4. Создать компонент `DoorsOverview.jsx` — краткая таблица дверей (первые 4-8)
5. Использовать хук `useAutoRefresh` для автообновления каждые 5-10 секунд
6. Обработка состояний загрузки и ошибок

**Результат:** Рабочая главная страница с данными из контроллера

---

### Этап 5: Мониторинг → Двери
**Цель:** Полная таблица состояния всех дверей

**Задачи:**
1. Создать компонент `Monitoring/Doors.jsx`
2. Создать компонент `DoorTable.jsx` для таблицы дверей
3. Использовать хук `useApi` для получения данных из `/api/doors`
4. Отобразить все колонки из API:
   - ID, physClosed, locked, alarming, alarmReasons, openSeconds, closeDelayRemainingSeconds
5. Создать компонент `FilterBar.jsx` с фильтрами:
   - По статусу (все/открытые/закрытые/с Alarmми)
   - По ID двери
6. Создать компонент `StatusBadge.jsx` для цветового кодирования:
   - Зеленый — норма (закрыта, без аварий)
   - Оранжевый — открыта
   - Красный — Alarm
7. Использовать хук `useAutoRefresh` для автообновления каждые 3-5 секунд
8. Обработка состояний загрузки и ошибок

**Результат:** Полнофункциональная таблица мониторинга дверей

---

### Этап 6: Мониторинг → События
**Цель:** Журнал событий с пагинацией

**Задачи:**
1. Создать компонент `Monitoring/Events.jsx`
2. Создать компонент `EventsTable.jsx` для таблицы событий
3. Использовать хук `useApi` для получения данных из `/api/journal/dump`
4. Реализовать пагинацию (useState для offset, limit)
5. Создать компонент `Pagination.jsx` с кнопками "Предыдущая", "Следующая"
6. Создать компонент `FilterBar.jsx` с фильтрами:
   - По типу события (dropdown)
   - По двери (input или dropdown)
   - По источнику (dropdown)
7. Создать утилиту `formatters.js` для форматирования времени (timestamp → читаемая дата/время)
8. Обработка состояний загрузки и ошибок

**Результат:** Рабочий журнал событий с пагинацией и фильтрами

---

### Этап 7: Мониторинг → Алармы
**Цель:** Список активных аварий

**Задачи:**
1. Создать компонент таблицы аварий
2. Фильтрация по `alarming == 1` из `/api/doors`
3. Отображение причин аварии (`alarmReasons`)
4. Цветовое выделение (красный)
5. Автообновление каждые 2-3 секунды

**Результат:** Таблица активных аварий

---

### Этап 8: Мониторинг → Статистика (минимальная)
**Цель:** Базовая статистика для тестирования

**Задачи:**
1. Создать компонент статистики
2. Отобразить:
   - Время открытия/закрытия (из журнала)
   - Количество аварий (из `/api/doors`)
   - Общая статистика журнала (из `/api/journal/stat`)
3. Простые графики или числовые показатели

**Результат:** Минимальная статистика (полная версия с привязкой к пользователям — после 9.5)

---

### Этап 9: Конфигурация → Настройка дверей
**Цель:** Редактирование базовых параметров

**Задачи:**
1. Создать компонент `Configuration/DoorsConfig.jsx`
2. Использовать React Hook Form для управления формой
3. Поля:
   - `projectName` (компонент `Input.jsx`)
   - `openTimeoutMs` (компонент `Input.jsx` типа number)
   - `doorCount` (только просмотр, disabled)
4. Использовать хук `useApi` для получения текущей конфигурации (`GET /api/config`)
5. Кнопка "Сохранить" → `PUT /api/config` через `api.putConfig()`
6. Валидация на клиенте (утилита `validators.js`)
7. Отображение результата (успех/ошибка) через toast или alert
8. Обработка состояний загрузки

**Результат:** Рабочая форма редактирования конфигурации

---

### Этап 10: Конфигурация → Сетевые настройки
**Цель:** Редактирование сетевых параметров

**Задачи:**
1. Создать форму сетевых настроек
2. Поля:
   - DHCP (чекбокс)
   - Web порт (числовое поле)
   - IP адрес (только просмотр, если DHCP включен)
3. Кнопка "Сохранить" → `PUT /api/config`
4. Валидация порта (1-65535)

**Результат:** Рабочая форма сетевых настроек

---

### Этап 11: Конфигурация → Параметры системы
**Цель:** Просмотр системной информации

**Задачи:**
1. Создать компонент отображения системных параметров
2. Отобразить:
   - Версия формата конфигурации
   - Последовательный номер (seq)
   - Статистика журнала (из `/api/journal/stat`)

**Результат:** Информационная панель системных параметров

---

### Этап 12: Настройки → Профиль пользователя
**Цель:** Базовая информация о пользователе

**Задачи:**
1. Создать компонент профиля
2. Отобразить:
   - Имя пользователя (пока статическое)
   - Роль (Администратор/Клиент)
3. Кнопка "Выход" (пока просто переход на страницу входа)

**Результат:** Базовая страница профиля (полная версия с управлением пользователями — после 9.5)

---

### Этап 13: Интеграция и тестирование
**Цель:** Финальная проверка и оптимизация

**Задачи:**
1. Тестирование всех разделов
2. Проверка работы с реальным контроллером
3. Обработка ошибок сети
4. Оптимизация производительности
5. Подготовка к встраиванию в прошивку (если нужно)

**Результат:** Готовый к использованию Web-интерфейс

---

## 7. ОТЛОЖЕННЫЕ ФУНКЦИИ (на будущее)

### 7.1 После этапа 9.5 (Аутентификация):
- Реальная аутентификация пользователей
- Управление пользователями (добавление, редактирование, удаление)
- Привязка событий к пользователям (кто выполнил действие)
- История изменений конфигурации с указанием пользователя
- Роли и права доступа

### 7.2 Дополнительные функции:
- "Просмотр карты" — визуализация плана этажа со схемой дверей
- "Создание карты" — редактор карты
- "Логика" — настройка логики работы дверей
- "Доступ" — управление доступом
- "Отчеты" — экспорт журнала, генерация отчетов
- Адаптивность для мобильных устройств
- Глобальный поиск в хедере

---

## 8. ПРИМЕЧАНИЯ

### 8.1 Текущий статус API
- ✅ Все read-only endpoints работают
- ✅ PUT /api/config работает
- ❌ Аутентификация (9.4, 9.5) — не реализована
- ❌ Управление пользователями — не реализовано

### 8.2 Подход к разработке
- **React-based:** Использование React для сложной логики и компонентного подхода
- **Минималистичный:** Только необходимый функционал для тестирования
- **Расширяемый:** Компонентная архитектура позволяет легко добавлять новые функции
- **Отдельное приложение:** Web-интерфейс не встраивается в прошивку
- **Итеративный:** Сначала базовая версия, потом расширение
- **Современный стек:** Vite, React Router, современные хуки

### 8.3 Тестирование
- Тестирование на реальном контроллере (MASTER, NodeID=1)
- Проверка работы всех API endpoints
- Проверка обработки ошибок (сеть недоступна, таймауты)
- Проверка автообновления данных

---

## 9. СЛЕДУЮЩИЕ ШАГИ

1. **Инициализировать React проект** в папке `WebUI/`
   - Использовать Vite: `npm create vite@latest WebUI -- --template react`
   - Или Create React App: `npx create-react-app WebUI`
2. **Настроить структуру проекта** согласно плану (папки, компоненты)
3. **Начать с Этапа 1:** Настройка проекта и базовая структура
4. **Постепенно реализовывать** этапы 2-13
5. **После завершения базовой версии** — перейти к этапу 9.4 и 9.5 (сессии и аутентификация)
6. **Интегрировать аутентификацию** в Web-интерфейс (обновить AuthContext, добавить реальные API вызовы)
7. **Расширить функционал** (карта, полная статистика, логика дверей, взаимосвязи)

### 9.1 Команды для начала работы

```bash
# Перейти в workspace
cd "c:\Users\morfe\STM32CubeIDE\workspace_1.17.0\Industrial Door PLC"

# Создать React проект с Vite
npm create vite@latest WebUI -- --template react

# Перейти в папку проекта
cd WebUI

# Установить зависимости
npm install

# Установить дополнительные библиотеки
npm install react-router-dom axios
# Опционально:
npm install react-hook-form date-fns

# Запустить dev-сервер
npm run dev
```

---

**Документ создан:** 2026-01-23  
**Версия:** 1.0  
**Статус:** План утвержден, готов к реализации
