Morfey1974/Industrial-Door-PLC-8-Doors/WebUI/MAPPING_EDITOR_PLAN.md

# Графический редактор карт помещений и дверей

## Обзор проекта

Создание страницы "Маппинг" в UI для визуального отображения и редактирования схем помещений с дверями. Редактор должен поддерживать два режима: редактирование карты и просмотр/мониторинг состояния дверей в реальном времени.

## Техническое решение: SVG + React

### Обоснование выбора SVG над Canvas

**Рекомендация: SVG (React)**

#### Преимущества SVG для данного проекта:

1. **Интерактивность и события**
   - Нативные DOM-события на каждом элементе (onClick, onMouseOver, onDrag)
   - Легко выделять, перемещать, редактировать отдельные объекты
   - Простая реализация drag-and-drop

2. **Масштабирование и производительность**
   - Векторная графика - масштабирование без потери качества
   - React управляет DOM, обновляются только измененные элементы
   - Эффективное обновление при изменении состояния дверей

3. **Интеграция с React**
   - Нативная поддержка JSX
   - Компонентный подход
   - Легкая связь с данными дверей через props/state

4. **Обновление состояния в реальном времени**
   - Обновление через React state/props
   - Меняется цвет индикатора двери - обновляется только этот элемент
   - Эффективно для режима мониторинга

5. **Сериализация и сохранение**
   - Структурированный DOM
   - Легко сохранять как XML/JSON
   - Простая валидация структуры

6. **Производительность**
   - Для 10-50 дверей и 20-100 стен производительность достаточна
   - React оптимизирует обновления через Virtual DOM

#### Когда Canvas был бы предпочтительнее:
- Тысячи объектов на экране
- Сложная анимация/градиенты
- Обработка изображений/пикселей
- Игры/тяжелая графика

**Вывод:** Для проекта с 10-50 дверьми SVG + React - оптимальное решение.

## Структура страницы "Маппинг"

### Верхняя панель
- **Название проекта** (из конфигурации)
- **Переключатель режимов:**
  - "Редактирование" - полный доступ к инструментам
  - "Просмотр" - только мониторинг состояния
- **Кнопки управления:**
  - Сохранить карту
  - Загрузить карту
  - Очистить карту
  - Экспорт (опционально)

### Центральная область рисования
- **SVG canvas** с белым фоном
- **Масштабирование:**
  - Колесико мыши (zoom in/out)
  - Ограничение зума (min: 0.1x, max: 5x)
  - Сохранение позиции при зуме
- **Панорамирование:**
  - Drag для перемещения карты
  - Стрелки клавиатуры (опционально)
- **Сетка** (обязательно, toggle on/off)
  - Размер ячейки: настраиваемый (по умолчанию 20px)
  - Визуальное выравнивание объектов
  - Привязка к сетке при включенной привязке
- **Координаты курсора** (опционально, для точного позиционирования)
- **Привязка (snap):**
  - Привязка по концам линий (для стен) - обязательно
  - Привязка к сетке (если включена) - обязательно
  - Привязка к центрам объектов (двери, метки) - обязательно
  - Привязка к пересечениям линий - обязательно
  - Радиус привязки: настраиваемый (по умолчанию 10-15px)
  - Визуальная индикация точки привязки

### Правая панель инструментов

#### Инструменты рисования:
1. **Выбор/Перемещение** (курсор)
   - Выделение объектов
   - Перетаскивание объектов
   - Изменение размера (handles)

2. **Рисование стены** (линия)
   - Клик для начала стены
   - Клик для конца стены
   - Толщина стены (настраиваемая)
   - **Привязка по концам линий (snap to endpoints):**
     - Автоматическая привязка к ближайшей конечной точке существующих линий/стен
     - Радиус привязки: 10-15 пикселей (настраиваемый)
     - Визуальная индикация привязки (подсветка точки привязки)
     - Привязка работает как при начале, так и при завершении рисования стены

3. **Вставка двери** (прямоугольник/иконка)
   - Выбор из списка доступных дверей системы
   - Привязка к `globalDoorId`
   - Стандартный размер двери

4. **Индикатор состояния двери** (светофор)
   - Автоматически привязан к двери
   - Зеленый: открыта/разблокирована
   - Красный: заблокирована/аларм
   - Обновление в реальном времени

5. **Вставка номера** (текст)
   - Номер двери/помещения
   - Настраиваемый размер шрифта

6. **Вставка комментария** (текст/метка)
   - Текстовая метка
   - Многострочный текст
   - Настраиваемый размер

7. **Удаление объектов**
   - Выделить объект → Delete
   - Или кнопка "Удалить" в панели инструментов

## Функциональность

### Режим редактирования

**Возможности:**
- Рисование всех типов объектов (стены, двери, метки)
- **Привязка объектов (snap):**
  - Привязка по концам линий при рисовании стен
  - Привязка к сетке (если включена)
  - Привязка к центрам объектов (двери, метки)
  - Привязка к пересечениям линий
  - Визуальная индикация активной привязки
- Редактирование объектов:
  - Перемещение (drag)
  - Изменение размера (resize handles)
  - Поворот (опционально)
- Удаление объектов
- Привязка дверей к реальным дверям из системы:
  - Выбор из dropdown списка
  - Отображение `globalDoorId`
  - Валидация привязки
- Сохранение карты в конфигурацию
- **Undo/Redo** (обязательно, для удобства редактирования)
  - История изменений (стек операций)
  - Горячие клавиши: Ctrl+Z / Ctrl+Shift+Z
  - Кнопки в панели инструментов

**Ограничения:**
- Только для ролей: Super Admin, Admin
- Валидация структуры перед сохранением

### Режим просмотра/мониторинга

**Возможности:**
- Только просмотр карты (без редактирования)
- Обновление состояния дверей в реальном времени:
  - Подписка на WebSocket или polling
  - Автоматическое обновление цветов индикаторов
- Интерактивность:
  - Клик по двери → информация о состоянии
  - Tooltip с деталями двери
- Масштабирование и панорамирование
- Доступно для всех ролей (Operator, Admin, Super Admin)

**Отображение состояния:**
- 🟢 Зеленый: дверь открыта/разблокирована
- 🔴 Красный: дверь заблокирована/аларм
- 🟡 Желтый: дверь открыта слишком долго (опционально)
- ⚪ Серый: дверь отключена/нет данных

**Анимация состояния дверей:**
- Плавная анимация при изменении состояния (открыта ↔ закрыта)
- Визуальная индикация открытия/закрытия двери на карте
- Переход цвета индикатора с анимацией (fade transition)
- Длительность анимации: 300-500ms

## Backend реализация

### Структура данных

**Расширение `project_config_t`:**
```c
typedef struct {
    // ... существующие поля ...
    
    // Карта помещений (JSON строка)
    char mappingData[MAPPING_DATA_MAX_SIZE]; // ~4096 байт
    uint32_t mappingDataSize;
} project_config_t;
```

**Формат JSON карты:**
```json
{
  "version": 1,
  "projectName": "Название проекта",
  "viewport": {
    "x": 0,
    "y": 0,
    "zoom": 1.0
  },
  "objects": [
    {
      "id": "wall_1",
      "type": "wall",
      "x1": 100,
      "y1": 100,
      "x2": 500,
      "y2": 100,
      "thickness": 5,
      "color": "#333333"
    },
    {
      "id": "door_1",
      "type": "door",
      "x": 200,
      "y": 95,
      "width": 50,
      "height": 10,
      "globalDoorId": 5,
      "rotation": 0
    },
    {
      "id": "indicator_1",
      "type": "indicator",
      "doorId": "door_1",
      "x": 225,
      "y": 85,
      "radius": 8
    },
    {
      "id": "label_1",
      "type": "label",
      "x": 210,
      "y": 110,
      "text": "Дверь 5",
      "fontSize": 12
    },
    {
      "id": "comment_1",
      "type": "comment",
      "x": 300,
      "y": 150,
      "text": "Главный вход",
      "fontSize": 14
    }
  ]
}
```

### API Endpoints

**GET /api/config/mapping**
- Загрузка карты из конфигурации
- Возвращает JSON карты
- Если карты нет - возвращает пустую структуру

**PUT /api/config/mapping**
- Сохранение карты в конфигурацию
- Валидация JSON структуры
- Проверка привязок дверей (существуют ли `globalDoorId`)
- Сохранение в QSPI через ConfigService
- Только для Super Admin и Admin

**Валидация:**
- Проверка формата JSON
- Проверка типов объектов
- Проверка координат (в разумных пределах)
- Проверка привязок дверей к существующим дверям

## Связь с реальными дверями

### При создании/редактировании двери на карте:

1. **Выбор двери:**
   - Dropdown список всех доступных дверей
   - Отображение: "Дверь {localDoor} (Плата {nodeId})"
   - Фильтрация по платам (опционально)

2. **Привязка:**
   - Сохранение `globalDoorId` в объекте двери
   - Валидация: дверь должна существовать в конфигурации
   - Отображение статуса привязки

3. **Визуализация:**
   - Иконка двери (стандартный вид)
   - Индикатор состояния (круг рядом с дверью)
   - Номер двери (текст)

### В режиме мониторинга:

1. **Подписка на обновления:**
   - Использовать существующий API `/api/doors`
   - Polling каждые 2-5 секунд
   - Или WebSocket (если будет реализован)

2. **Обновление индикаторов:**
   - Маппинг `globalDoorId` → объект индикатора на карте
   - Обновление цвета на основе состояния:
     - `locked === true` → красный
     - `locked === false && !alarming` → зеленый
     - `alarming === true` → красный (мигание опционально)

3. **Интерактивность:**
   - Клик по двери → модальное окно с деталями:
     - Номер двери
     - Плата
     - Состояние (заблокирована/разблокирована)
     - Время открытия
     - Алармы

## Технические детали реализации

### Frontend компоненты

**Основные компоненты:**
- `Mapping.jsx` - главный компонент страницы
- `MappingCanvas.jsx` - SVG область рисования
- `MappingToolbar.jsx` - панель инструментов справа
- `MappingHeader.jsx` - верхняя панель с управлением
- `DoorSelector.jsx` - выбор двери для привязки
- `ObjectProperties.jsx` - панель свойств объекта (опционально)

**Состояние (React State):**
```javascript
{
  mode: 'edit' | 'view',
  selectedTool: 'select' | 'wall' | 'door' | 'label' | 'comment',
  objects: [...], // массив объектов карты
  selectedObject: null,
  viewport: { x, y, zoom },
  doors: [...], // данные о реальных дверях
  isDirty: false, // были ли изменения
  snapEnabled: true, // включена ли привязка
  snapRadius: 15, // радиус привязки в пикселях
  snapPoint: null, // текущая точка привязки {x, y}
  gridEnabled: true, // включена ли сетка
  gridSize: 20, // размер ячейки сетки в пикселях
  history: [...], // стек операций для Undo/Redo
  historyIndex: -1 // текущая позиция в истории
}
```

**Библиотеки (опционально):**
- `react-svg-pan-zoom` - для панорамирования и зума
- `react-draggable` - для перетаскивания объектов
- Или собственная реализация на нативном SVG + React

### Производительность

**Оптимизации:**
- Виртуализация: рендеринг только видимых объектов
- Мемоизация компонентов объектов
- Debounce для обновлений состояния дверей
- Lazy loading для больших карт

**Ограничения:**
- Максимум дверей: 80 (реально ожидается 10-30 дверей)
- Максимум комнат: ~10 комнат
- Максимум объектов: ~200-300 (стены + двери + метки)
- Максимальный размер JSON: 4096 байт
- Оптимизация координат (округление до целых)

### Обработка ошибок

- Валидация JSON при загрузке
- Проверка целостности привязок дверей
- Обработка отсутствующих дверей (показ placeholder)
- Сообщения об ошибках сохранения

## Этапы реализации

### Этап 1: Базовая структура
- [ ] Создать страницу Mapping
- [ ] Добавить маршрут в App.jsx
- [ ] Базовая SVG область
- [ ] Панель инструментов (UI только)

### Этап 2: Инструменты рисования
- [ ] Реализовать рисование стен
- [ ] Реализовать привязку по концам линий (snap to endpoints)
  - Алгоритм поиска ближайшей конечной точки
  - Визуальная индикация точки привязки
  - Настройка радиуса привязки
- [ ] Реализовать вставку дверей
- [ ] Реализовать вставку текста/меток
- [ ] Реализовать выбор и перемещение объектов
- [ ] Реализовать удаление объектов

### Этап 3: Масштабирование и панорамирование
- [ ] Zoom колесиком мыши
- [ ] Pan (перетаскивание карты)
- [ ] Ограничения зума
- [ ] Сохранение позиции viewport

### Этап 4: Backend интеграция
- [ ] Расширить структуру конфигурации
- [ ] API endpoints (GET/PUT /api/config/mapping)
- [ ] Валидация данных
- [ ] Сохранение/загрузка карты

### Этап 5: Связь с дверями
- [ ] Выбор двери при создании объекта
- [ ] Привязка к globalDoorId
- [ ] Загрузка данных о дверях
- [ ] Валидация привязок

### Этап 6: Режим мониторинга
- [ ] Переключатель режимов
- [ ] Подписка на обновления дверей
- [ ] Обновление индикаторов состояния
- [ ] Интерактивность (клик по двери)

### Этап 7: Полировка
- [ ] Undo/Redo (обязательно)
  - Реализация стека операций
  - Горячие клавиши Ctrl+Z / Ctrl+Shift+Z
  - Кнопки в панели инструментов
- [ ] Сетка (обязательно)
  - Визуальная сетка на canvas
  - Настройка размера ячейки
  - Toggle включения/выключения
- [ ] Привязка к центрам объектов (обязательно)
- [ ] Привязка к пересечениям линий (обязательно)
- [ ] Настройки привязки (радиус, включение/выключение)
- [ ] Анимация состояния дверей (открыта/закрыта)
- [ ] Улучшение UX

## Права доступа

- **Super Admin, Admin:** Полный доступ (редактирование + просмотр)
- **Operator:** Только просмотр (мониторинг)

## Технические детали привязки (Snap)

### Алгоритм привязки по концам линий

**При рисовании стены:**
1. При движении мыши вычислять расстояние до всех конечных точек существующих линий/стен
2. Если расстояние меньше `snapRadius` - активировать привязку
3. Визуально отображать точку привязки (маленький круг или крестик)
4. При клике - использовать координаты точки привязки вместо координат курсора

**Оптимизация:**
- Поиск только среди видимых объектов (viewport culling)
- Квадродерево или пространственная индексация для быстрого поиска
- Кэширование конечных точек при изменении объектов

**Визуальная индикация:**
- Подсветка точки привязки (круг или крестик)
- Линия от курсора до точки привязки (опционально)
- Изменение курсора при активной привязке

**Настройки:**
- Включение/выключение привязки (toggle)
- Радиус привязки: 5-30 пикселей (по умолчанию 15px)
- Типы привязки (все обязательны):
  - К концам линий (обязательно)
  - К сетке (если включена) (обязательно)
  - К центрам объектов (двери, метки) (обязательно)
  - К пересечениям линий (обязательно)

**Алгоритм привязки к центрам объектов:**
- При движении мыши вычислять расстояние до центров всех объектов (двери, метки, комментарии)
- Если расстояние меньше `snapRadius` - активировать привязку к центру
- Приоритет: пересечения > концы линий > центры объектов > сетка

**Алгоритм привязки к пересечениям линий:**
- Вычислять все точки пересечения существующих линий/стен
- При движении мыши проверять расстояние до ближайшего пересечения
- Если расстояние меньше `snapRadius` - активировать привязку
- Визуальная индикация точки пересечения

## Уточнения и решения

### Ответы на вопросы:

1. ✅ **Сетка для выравнивания объектов:** Да, обязательно
   - Визуальная сетка на canvas
   - Настраиваемый размер ячейки (по умолчанию 20px)
   - Toggle включения/выключения
   - Привязка к сетке при включенной привязке

2. ✅ **Undo/Redo:** Да, обязательно
   - История изменений (стек операций)
   - Горячие клавиши: Ctrl+Z / Ctrl+Shift+Z
   - Кнопки в панели инструментов

3. ❌ **Экспорт карты (PNG/SVG):** Пока нет
   - Функция отложена на будущее

4. ❌ **Поддержка многоэтажных зданий (слои):** Нет
   - Только плоская карта (один этаж)
   - Слои не требуются

5. ✅ **Анимация при изменении состояния дверей:** Да
   - Анимация открытия/закрытия двери
   - Плавный переход цвета индикатора
   - Длительность: 300-500ms

6. 📏 **Максимальный размер карты:**
   - Максимум дверей: 80 (реально ожидается 10-30 дверей)
   - Максимум комнат: ~10 комнат
   - Максимум объектов: ~200-300 (стены + двери + метки)

7. ✅ **Привязка к центрам объектов:** Да, обязательно
   - Привязка к центрам дверей, меток, комментариев
   - Радиус привязки: настраиваемый

8. ✅ **Привязка к пересечениям линий:** Да, обязательно
   - Вычисление точек пересечения существующих линий/стен
   - Привязка к ближайшему пересечению
   - Визуальная индикация точки пересечения

## Заключение

Графический редактор карт помещений и дверей - реализуемая задача среднего уровня сложности. Использование SVG + React обеспечит:
- Простую интеграцию с существующим кодом
- Эффективное обновление состояния
- Хорошую производительность для типичных сценариев использования
- Легкую поддержку и расширение функциональности

Рекомендуется начать с базовой реализации (стены, двери, текст) и постепенно добавлять функциональность.
