Morfey1974/Industrial-Door-PLC-8-Doors/WebUI/CHECK_CONSOLE.md

# Проверка консоли браузера

## Важно: Проверьте вкладку Console!

В DevTools переключитесь на вкладку **"Консоль" (Console)**, а не "Сеть" (Network).

Там должны быть ошибки JavaScript, которые объясняют, почему страница пустая.

## Что искать:

1. **Красные ошибки** - это критично
2. **Предупреждения (желтые)** - могут указывать на проблемы
3. **Ошибки импорта** - например, "Cannot find module"
4. **Ошибки рендеринга** - например, "Cannot read property"

## Типичные ошибки:

### "Cannot find module './assets/logo/Logo.png'"
**Решение:** Проблема с импортом изображения. Используйте другой способ.

### "useNavigate must be used within a Router"
**Решение:** Компонент не обернут в Router.

### "Cannot read property 'nodeId' of null"
**Решение:** Данные еще не загружены, но уже используются.

## Что делать:

1. Откройте вкладку **Console** в DevTools (F12)
2. Скопируйте все красные ошибки
3. Отправьте их мне для исправления

Без ошибок из консоли сложно понять, в чем проблема!
