Morfey1974/Industrial-Door-PLC-8-Doors/DcmakingCatalog/img/door-controller.jpg

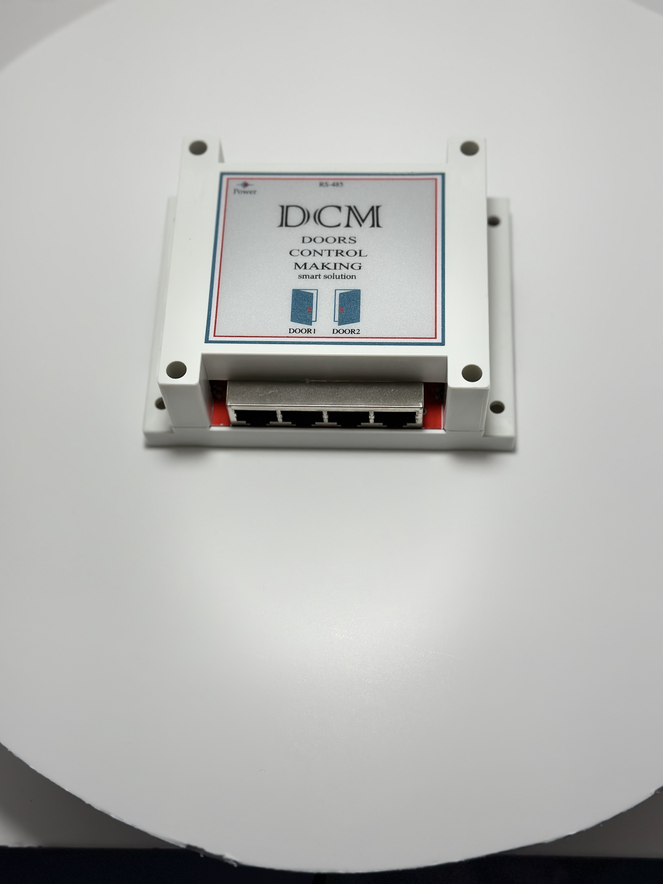
DcmakingCatalog/img/door-controller.jpg
