Morfey1974/Industrial-Door-PLC-8-Doors/DcmakingCatalog/img/electric-bolt.jpg

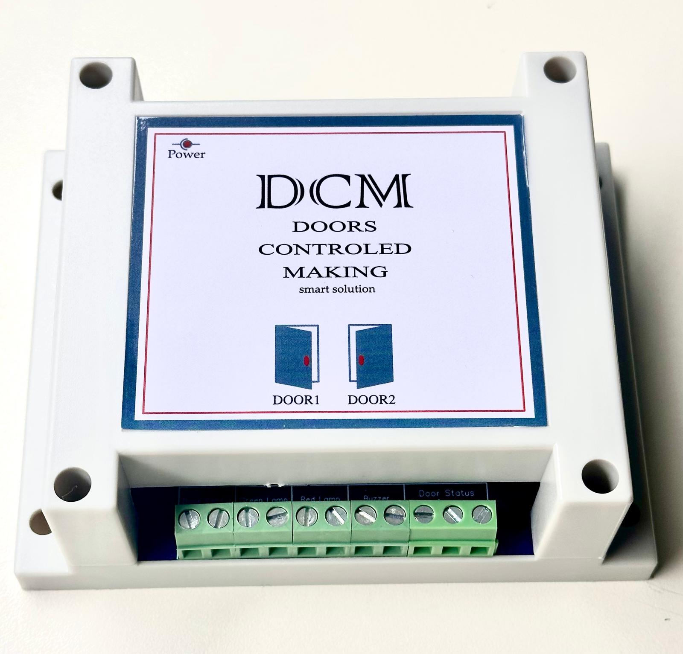
DcmakingCatalog/img/electric-bolt.jpg
