Morfey1974/Industrial-Door-PLC-8-Doors/DcmakingCatalog/img/expansion-board-for-electromagnet.jpg

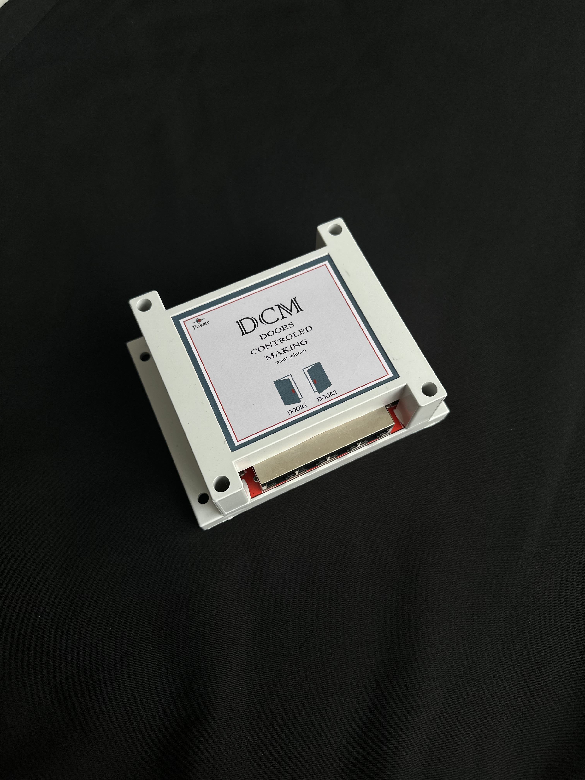
DcmakingCatalog/img/expansion-board-for-electromagnet.jpg
