Morfey1974/Industrial-Door-PLC-8-Doors/DcmakingCatalog/img/expansion-board-for-sliding-doors.jpg

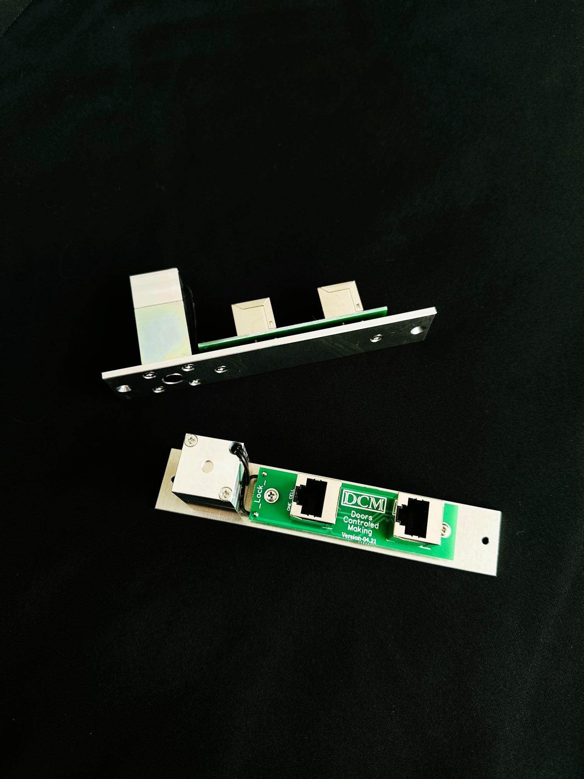
DcmakingCatalog/img/expansion-board-for-sliding-doors.jpg
