Morfey1974/Industrial-Door-PLC-8-Doors/DcmakingCatalog/img/the-membrane-traffic-light-narrow.jpg

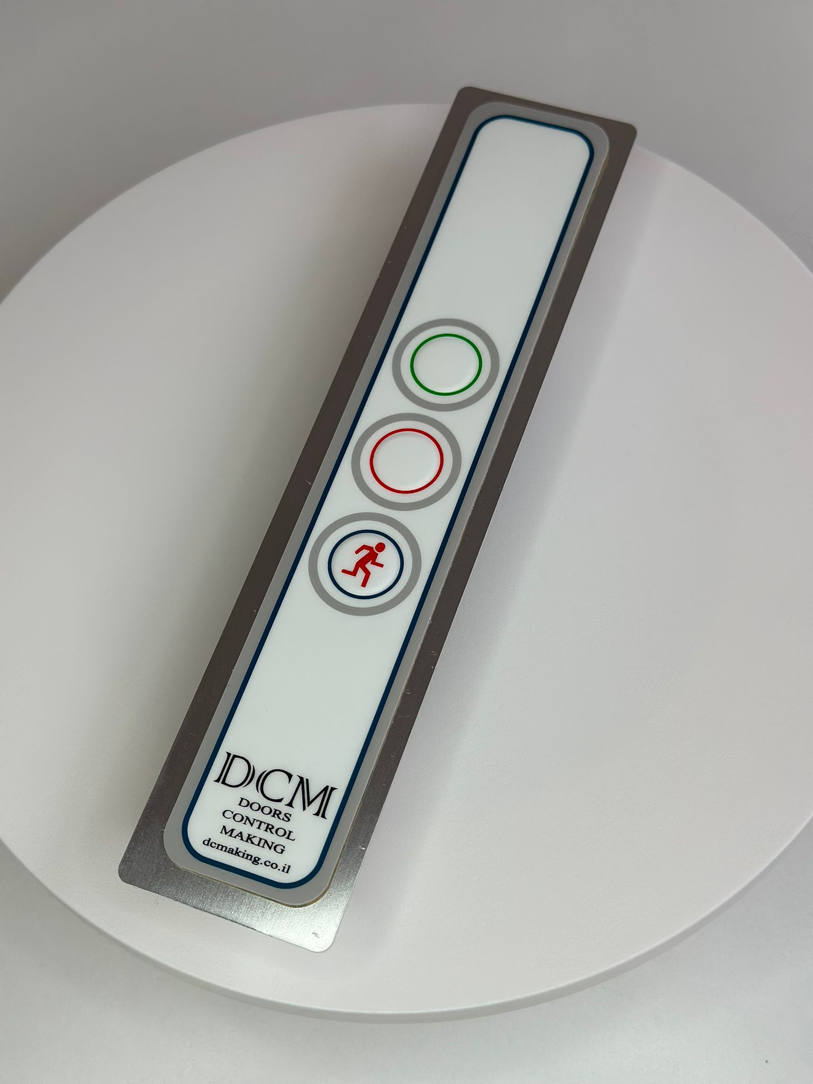
DcmakingCatalog/img/the-membrane-traffic-light-narrow.jpg
