Morfey1974/Industrial-Door-PLC-8-Doors/DcmakingCatalog/img/the-traffic-light-membrane-wide.jpg

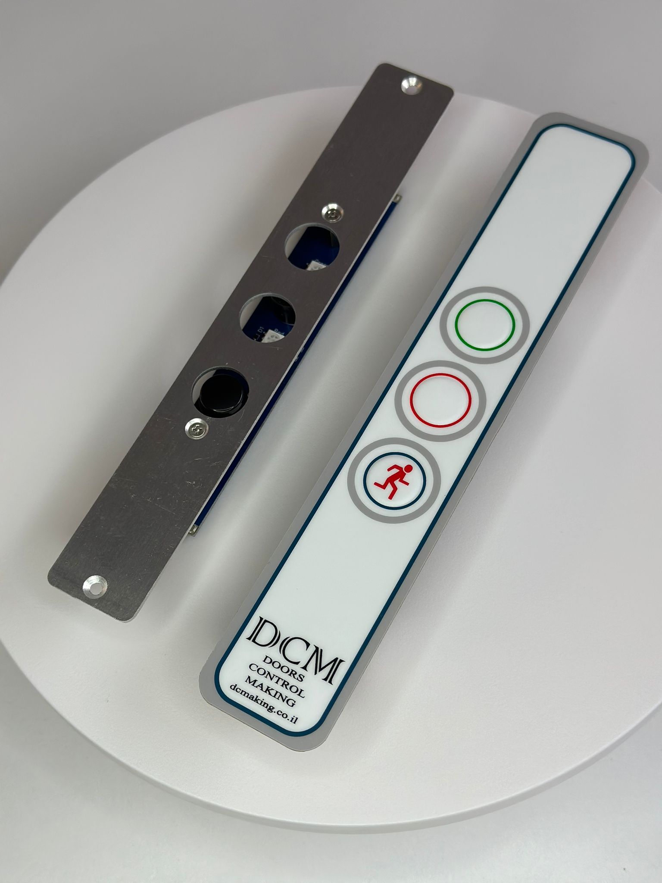
DcmakingCatalog/img/the-traffic-light-membrane-wide.jpg
