Morfey1974/Industrial-Door-PLC-8-Doors/DcmakingCatalog/img/the-traffic-light-narrow.jpg

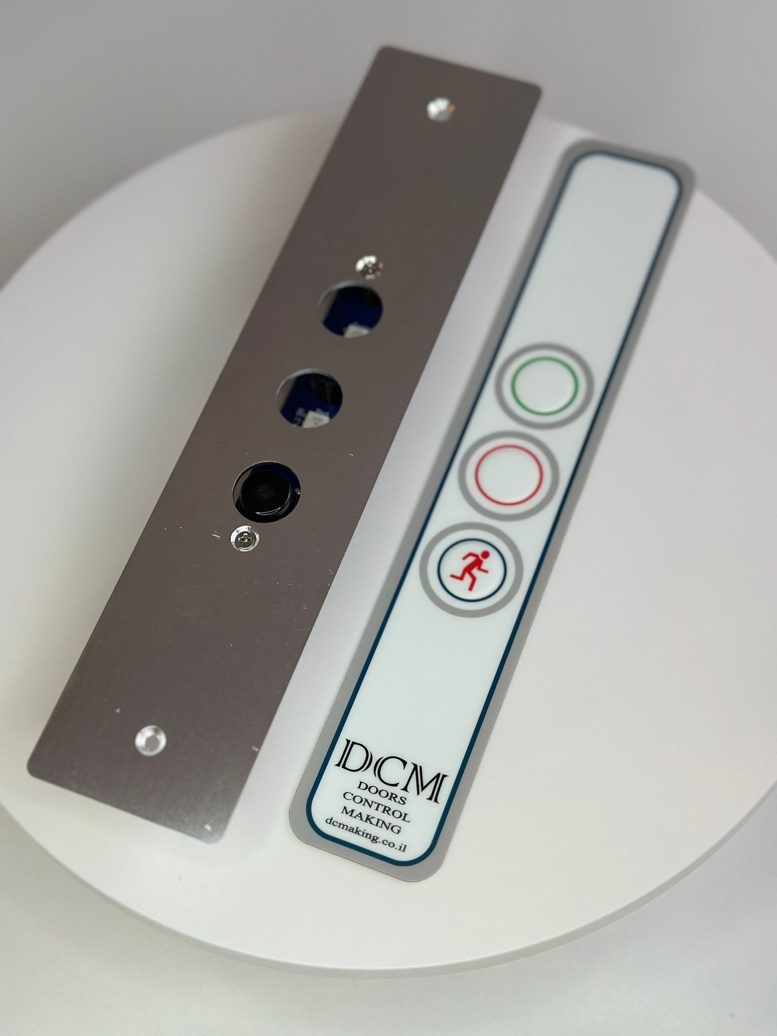
DcmakingCatalog/img/the-traffic-light-narrow.jpg
