Morfey1974/Industrial-Door-PLC-8-Doors/DcmakingCatalog/src/assets/product-bolt.jpg

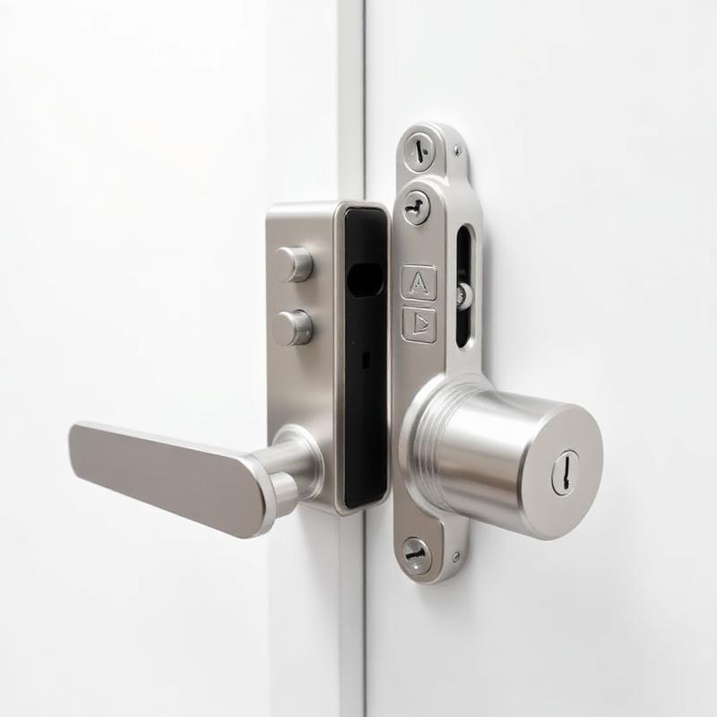
DcmakingCatalog/src/assets/product-bolt.jpg
