Morfey1974/Industrial-Door-PLC-8-Doors/DcmakingCatalog/src/assets/product-controller.jpg

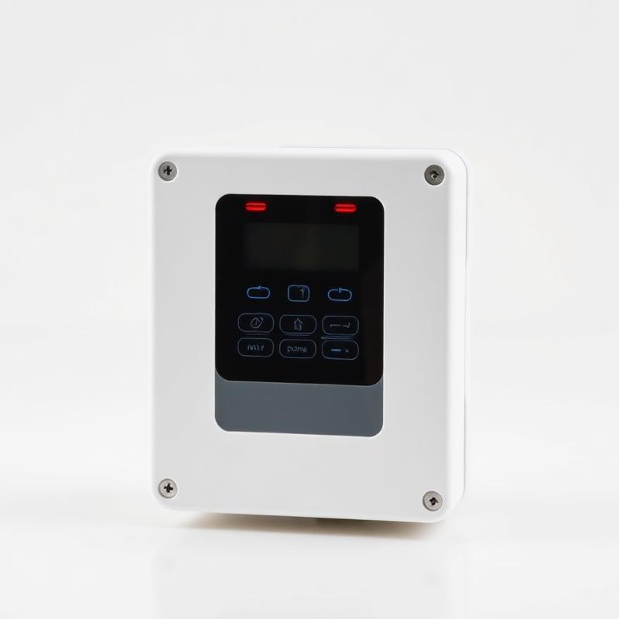
DcmakingCatalog/src/assets/product-controller.jpg
