Morfey1974/Industrial-Door-PLC-8-Doors/DcmakingCatalog/src/assets/products/door-controller.jpg

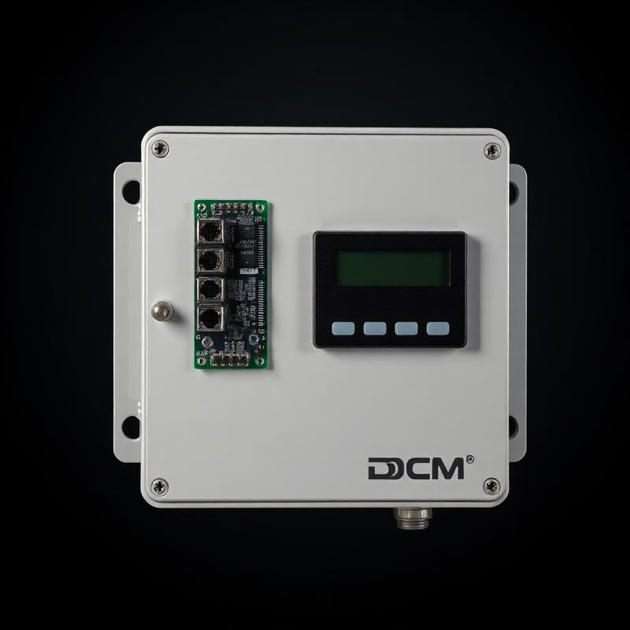
DcmakingCatalog/src/assets/products/door-controller.jpg
