Morfey1974/Industrial-Door-PLC-8-Doors/DcmakingCatalog/src/assets/products/electric-bolt.jpg

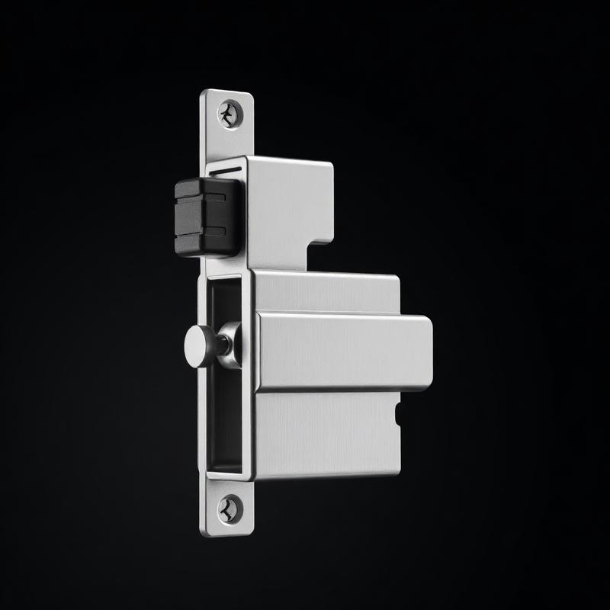
DcmakingCatalog/src/assets/products/electric-bolt.jpg
