Morfey1974/Industrial-Door-PLC-8-Doors/DcmakingCatalog/src/assets/products/expansion-board-electromagnet.jpg

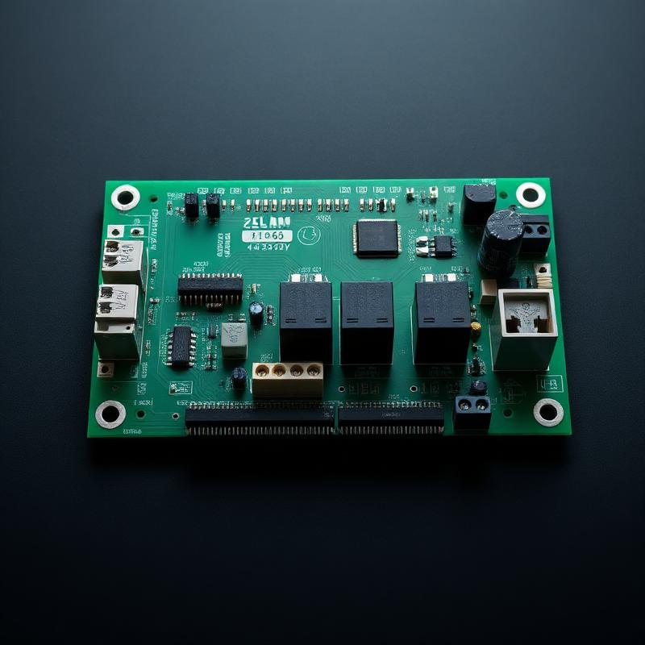
DcmakingCatalog/src/assets/products/expansion-board-electromagnet.jpg
