Morfey1974/Industrial-Door-PLC-8-Doors/DcmakingCatalog/src/assets/products/traffic-light-membrane-wide.jpg

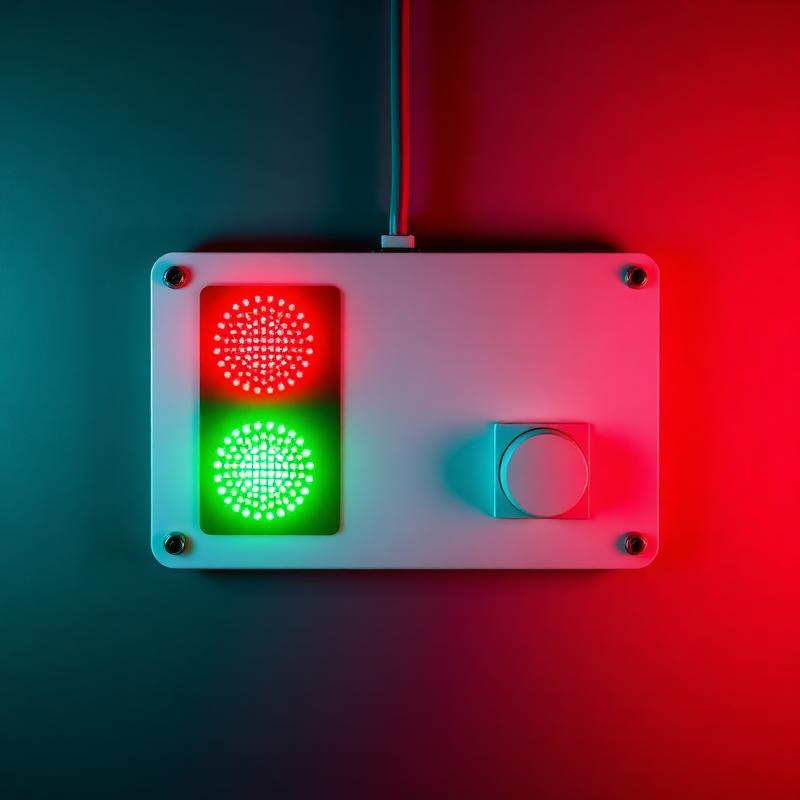
DcmakingCatalog/src/assets/products/traffic-light-membrane-wide.jpg
