Morfey1974/Industrial-Door-PLC-8-Doors/DcmakingCatalog/src/assets/products/traffic-light-narrow.jpg

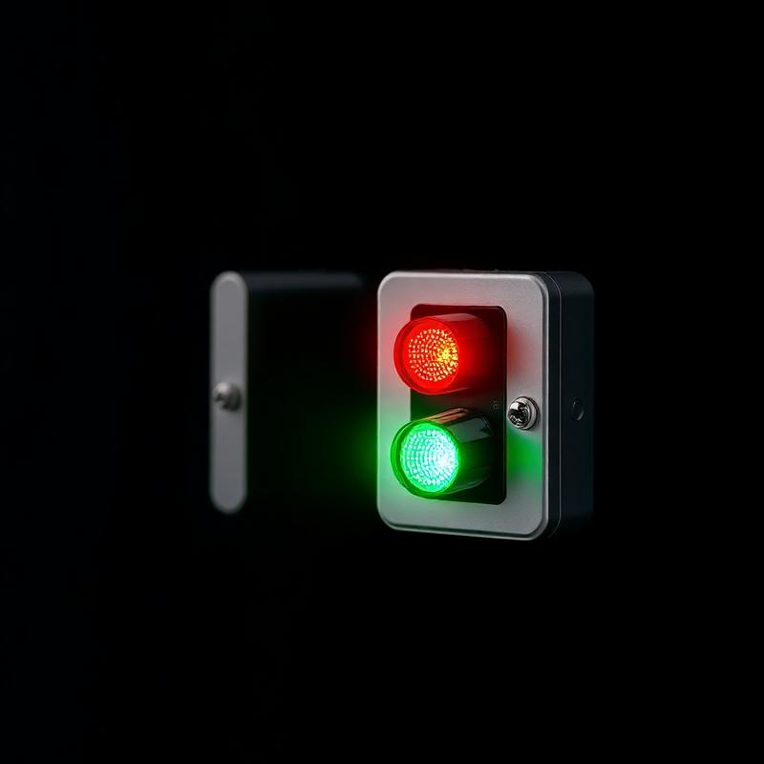
DcmakingCatalog/src/assets/products/traffic-light-narrow.jpg
