Morfey1974/Industrial-Door-PLC-8-Doors/WebUI/INSTALL_VS.md

# Инструкция по интеграции React проекта в Visual Studio

## Содержание
1. [Предварительные требования](#предварительные-требования)
2. [Установка Node.js и npm](#установка-nodejs-и-npm)
3. [Установка зависимостей проекта](#установка-зависимостей-проекта)
4. [Настройка Visual Studio](#настройка-visual-studio)
5. [Открытие проекта в Visual Studio](#открытие-проекта-в-visual-studio)
6. [Запуск проекта](#запуск-проекта)
7. [Настройка для разработки](#настройка-для-разработки)
8. [Решение проблем](#решение-проблем)

---

## Предварительные требования

### Что нужно установить:

1. **Node.js** (версия 18 или выше)
   - Скачать: https://nodejs.org/
   - Выбрать LTS версию (Long Term Support)
   - При установке убедиться, что опция "Add to PATH" включена

2. **Visual Studio 2022** (или Visual Studio Code)
   - Visual Studio 2022 Community (бесплатная): https://visualstudio.microsoft.com/
   - Или Visual Studio Code: https://code.visualstudio.com/

3. **Git** (опционально, если используете Git)
   - Обычно уже установлен, если используете Git

---

## Установка Node.js и npm

### Шаг 1: Проверка установки Node.js

1. Откройте **PowerShell** или **Command Prompt** (Win+R → `cmd`)
2. Выполните команду:
   ```bash
   node --version
   ```
3. Должна отобразиться версия, например: `v18.17.0` или выше
4. Проверьте npm:
   ```bash
   npm --version
   ```
5. Должна отобразиться версия, например: `9.6.7` или выше

### Шаг 2: Если Node.js не установлен

1. Перейдите на https://nodejs.org/
2. Скачайте **LTS версию** (рекомендуется)
3. Запустите установщик
4. Следуйте инструкциям установщика
5. **Важно:** Убедитесь, что опция "Add to PATH" включена
6. После установки перезапустите терминал
7. Проверьте установку снова (команды из Шага 1)

---

## Установка зависимостей проекта

### Шаг 1: Открыть терминал в папке проекта

**Вариант A: Через проводник Windows**
1. Откройте проводник Windows
2. Перейдите в папку проекта:
   ```
   c:\Users\morfe\STM32CubeIDE\workspace_1.17.0\Industrial Door PLC\WebUI
   ```
3. В адресной строке проводника введите `powershell` и нажмите Enter
   - Или нажмите Shift + ПКМ (правая кнопка мыши) в пустом месте папки
   - Выберите "Открыть окно PowerShell здесь"

**Вариант B: Через командную строку**
1. Откройте Command Prompt или PowerShell
2. Выполните команду:
   ```bash
   cd "c:\Users\morfe\STM32CubeIDE\workspace_1.17.0\Industrial Door PLC\WebUI"
   ```

### Шаг 2: Установить зависимости

В открытом терминале выполните:

```bash
npm install
```

**Что происходит:**
- npm читает файл `package.json`
- Скачивает все необходимые пакеты (React, Vite, и т.д.)
- Устанавливает их в папку `node_modules/`
- Это может занять 2-5 минут в зависимости от скорости интернета

**Ожидаемый результат:**
```
added 234 packages, and audited 235 packages in 45s
```

### Шаг 3: Проверка установки

Выполните команду для проверки:

```bash
npm list --depth=0
```

Должны отобразиться установленные пакеты:
- react
- react-dom
- react-router-dom
- axios
- vite
- и другие

---

## Настройка Visual Studio

### Вариант 1: Visual Studio 2022 (полная версия)

#### Шаг 1: Установка необходимых компонентов

1. Откройте **Visual Studio Installer**
2. Нажмите **Изменить** на установленной версии Visual Studio
3. Убедитесь, что установлены следующие рабочие нагрузки:
   - **Разработка веб-приложений и ASP.NET**
   - **Разработка классических приложений .NET**
4. В разделе **Отдельные компоненты** убедитесь, что установлены:
   - **Node.js** (если не установлен отдельно)
   - **Git для Windows**
5. Нажмите **Изменить** и дождитесь установки

#### Шаг 2: Установка расширений (опционально)

1. В Visual Studio откройте **Расширения → Управление расширениями**
2. Найдите и установите:
   - **NPM Task Runner** (для запуска npm скриптов)
   - **Web Essentials** (опционально)

### Вариант 2: Visual Studio Code (рекомендуется для React)

#### Шаг 1: Установка расширений

1. Откройте Visual Studio Code
2. Нажмите на иконку расширений (или Ctrl+Shift+X)
3. Установите следующие расширения:
   - **ES7+ React/Redux/React-Native snippets**
   - **Prettier - Code formatter**
   - **ESLint**
   - **JavaScript (ES6) code snippets**
   - **Auto Rename Tag**
   - **Bracket Pair Colorizer 2** (или встроенный в VS Code)

---

## Открытие проекта в Visual Studio

### Вариант 1: Visual Studio 2022

#### Способ A: Через меню "Открыть папку"

1. Запустите **Visual Studio 2022**
2. Выберите **Файл → Открыть → Папка** (или `Ctrl+K, Ctrl+O`)
3. Перейдите в папку:
   ```
   c:\Users\morfe\STM32CubeIDE\workspace_1.17.0\Industrial Door PLC\WebUI
   ```
4. Нажмите **Выбор папки**

#### Способ B: Через проводник Windows

1. Откройте проводник Windows
2. Перейдите в папку `WebUI`
3. Правой кнопкой мыши на папке → **Открыть с помощью → Visual Studio 2022**

#### Способ C: Добавить в решение STM32CubeIDE

1. Откройте решение STM32CubeIDE в Visual Studio
2. В **Обозревателе решений** правой кнопкой на решении
3. Выберите **Добавить → Существующий проект**
4. НО: React проект не является .NET проектом, поэтому лучше использовать **"Открыть папку"**

**Рекомендация:** Используйте **"Открыть папку"** для React проекта, так как это не .NET проект.

### Вариант 2: Visual Studio Code

#### Способ A: Через меню

1. Запустите **Visual Studio Code**
2. Выберите **Файл → Открыть папку** (или `Ctrl+K, Ctrl+O`)
3. Перейдите в папку:
   ```
   c:\Users\morfe\STM32CubeIDE\workspace_1.17.0\Industrial Door PLC\WebUI
   ```
4. Нажмите **Выбор папки**

#### Способ B: Через проводник Windows

1. Откройте проводник Windows
2. Перейдите в папку `WebUI`
3. Правой кнопкой мыши на папке → **Открыть с помощью Code**

#### Способ C: Через командную строку

1. Откройте терминал в папке `WebUI`
2. Выполните:
   ```bash
   code .
   ```

---

## Запуск проекта

### Шаг 1: Открыть терминал в Visual Studio

**В Visual Studio 2022:**
1. **Вид → Терминал** (или `Ctrl+` ` - обратная кавычка)
2. Или **Инструменты → Командная строка → Разработчик**

**В Visual Studio Code:**
1. **Вид → Терминал** (или `` Ctrl+` ``)
2. Или используйте встроенный терминал внизу

### Шаг 2: Убедиться, что вы в правильной папке

В терминале выполните:

```bash
cd "c:\Users\morfe\STM32CubeIDE\workspace_1.17.0\Industrial Door PLC\WebUI"
```

Или если терминал уже открыт в папке проекта, проверьте:

```bash
pwd
```

Должен отобразиться путь к папке `WebUI`.

### Шаг 3: Запустить dev-сервер

Выполните команду:

```bash
npm run dev
```

**Что происходит:**
- Vite запускает dev-сервер
- Компилирует React приложение
- Открывает браузер автоматически (если настроено)
- Приложение доступно на `http://localhost:3000`

**Ожидаемый результат:**
```
  VITE v5.0.8  ready in 500 ms

  ➜  Local:   http://localhost:3000/
  ➜  Network: use --host to expose
  ➜  press h + enter to show help
```

### Шаг 4: Открыть в браузере

1. Если браузер не открылся автоматически, откройте вручную:
   ```
   http://localhost:3000
   ```
2. Вы должны увидеть страницу с текстом "Industrial Door PLC - Web Interface"

### Шаг 5: Остановить сервер

В терминале нажмите `Ctrl+C` для остановки dev-сервера.

---

## Настройка для разработки

### Настройка Task Runner в Visual Studio 2022

**Важно:** Visual Studio 2022 **требует расширение NPM Task Runner** для автоматического распознавания npm задач из `package.json`. Без этого расширения задачи не будут отображаться.

#### Решение 1: Установка расширения NPM Task Runner (ОБЯЗАТЕЛЬНО)

**Это единственный надёжный способ** увидеть npm задачи в Task Runner Explorer.

1. **Расширения → Управление расширениями** (или `Ctrl+Q`, введите "extensions")
2. Перейдите на вкладку **"Online"** (Онлайн)
3. В поиске введите: **"NPM Task Runner"**
4. Найдите расширение **"NPM Task Runner"** (автор: **Mads Kristensen**)
   - Обычно это первое в списке
   - Иконка: зелёный значок npm
5. Нажмите **"Скачать"** (Download)
6. После скачивания нажмите **"Изменить"** (Modify) для установки
7. **Закройте и перезапустите Visual Studio** (это обязательно!)
8. После перезапуска **ВАЖНО** - откройте Task Runner Explorer правильным способом:
   
   **Способ 1 (рекомендуется):**
   - В **Обозревателе решений** найдите файл `package.json`
   - **Правой кнопкой мыши** на файле `package.json`
   - Выберите **"Task Runner Explorer"** из контекстного меню
   
   **Способ 2 (альтернатива):**
   - Откройте **Вид → Другие окна → Диспетчер задач** (или `Ctrl+Alt+T`)
   - В выпадающем списке вверху выберите `package.json` (если он там есть)
   
9. В диспетчере задач должны появиться задачи из `package.json`:
   - `dev` - запуск dev-сервера
   - `build` - сборка для продакшена
   - `preview` - предпросмотр собранной версии
   - `lint` - проверка кода
10. Двойной клик на задаче `dev` для запуска

**Если задачи всё ещё не появились:**

1. **Проверьте, что зависимости установлены:**
   - Откройте терминал в Visual Studio: **Вид → Терминал**
   - Убедитесь, что вы в папке `WebUI`
   - Выполните: `npm install`
   - Должна появиться папка `node_modules` (может быть скрыта в Обозревателе решений)
   - Если были ошибки "Cannot find module npm-prefix.js" или "npm-cli.js" - это значит зависимости не установлены

2. **Проверьте, какая папка открыта:**
   - Убедитесь, что вы открыли папку `WebUI` в Visual Studio (не всю папку проекта)
   - Проверьте путь в заголовке окна Visual Studio - должно быть: `...\WebUI`
   - Если открыта не та папка: **Файл → Открыть → Папка** → выберите папку `WebUI`

3. **Проверьте расположение package.json:**
   - В **Обозревателе решений** должен быть виден файл `package.json` в корне
   - Если его нет - значит открыта не та папка

4. **Обновите проект в Visual Studio:**
   - Закройте Task Runner Explorer (если открыт)
   - В **Обозревателе решений** нажмите правой кнопкой на корне проекта → **Обновить** (Refresh)
   - Или закройте и снова откройте папку `WebUI`

5. **Попробуйте перезапустить Visual Studio:**
   - Закройте Visual Studio полностью
   - Откройте снова
   - Откройте папку `WebUI`
   - Правой кнопкой на `package.json` → Task Runner Explorer

6. **Проверьте, что расширение активно:**
   - **Расширения → Управление расширениями**
   - Вкладка **"Установленные"**
   - Убедитесь, что "NPM Task Runner" не отключено (если есть кнопка "Включить" - нажмите её)

#### Решение 2: Использование терминала (всегда работает, рекомендуется)

**Это самый простой и надёжный способ** запускать npm команды, даже если Task Runner не работает:

1. **Вид → Терминал** (или `Ctrl+` ` - обратная кавычка)
2. Убедитесь, что вы в папке `WebUI` (проверьте путь в терминале)
3. Выполните команды напрямую:
   ```bash
   npm run dev      # Запуск dev-сервера
   npm run build    # Сборка для продакшена
   npm run preview  # Предпросмотр собранной версии
   npm run lint     # Проверка кода
   ```

**Преимущества терминала:**
- Работает всегда, без расширений
- Видно полный вывод команд
- Можно легко остановить процесс (`Ctrl+C`)
- Можно запускать несколько команд одновременно

**Рекомендация:** Используйте терминал для разработки - это быстрее и надёжнее, чем Task Runner.

### Настройка запуска в Visual Studio Code

#### Способ 1: Через терминал (рекомендуется)

Просто используйте встроенный терминал и команды `npm run dev`, `npm run build` и т.д.

#### Способ 2: Через задачи (Tasks)

1. Создайте файл `.vscode/tasks.json`:
   ```json
   {
     "version": "2.0.0",
     "tasks": [
       {
         "label": "dev",
         "type": "npm",
         "script": "dev",
         "problemMatcher": [],
         "isBackground": true,
         "presentation": {
           "reveal": "always",
           "panel": "new"
         }
       },
       {
         "label": "build",
         "type": "npm",
         "script": "build",
         "problemMatcher": []
       }
     ]
   }
   ```

2. Запуск: `Ctrl+Shift+P` → "Tasks: Run Task" → выберите задачу

### Настройка отладки (опционально)

#### Для Visual Studio Code:

1. Создайте файл `.vscode/launch.json`:
   ```json
   {
     "version": "0.2.0",
     "configurations": [
       {
         "name": "Launch Chrome",
         "type": "chrome",
         "request": "launch",
         "url": "http://localhost:3000",
         "webRoot": "${workspaceFolder}/src"
       }
     ]
   }
   ```

2. Установите расширение **Debugger for Chrome** (если нужно)

---

## Решение проблем

### Проблема 1: "npm не является внутренней или внешней командой"

**Решение:**
1. Node.js не установлен или не добавлен в PATH
2. Переустановите Node.js с опцией "Add to PATH"
3. Перезапустите терминал и Visual Studio

### Проблема 2: "npm ERR! code EACCES" или ошибки прав доступа

**Решение:**
1. Запустите терминал от имени администратора
2. Или используйте `npm install --global` с правами администратора

### Проблема 3: "Cannot find module 'vite'"

**Решение:**
1. Убедитесь, что вы в папке `WebUI`
2. Выполните `npm install` снова
3. Проверьте, что папка `node_modules` существует

### Проблема 4: Порт 3000 уже занят

**Решение:**
1. Измените порт в `vite.config.js`:
   ```javascript
   server: {
     port: 3001,  // или другой свободный порт
   }
   ```
2. Или остановите процесс, использующий порт 3000

### Проблема 5: Visual Studio не видит файлы .jsx

**Решение:**
1. Установите расширения для JavaScript/React
2. В Visual Studio Code установите расширение **ES7+ React/Redux/React-Native snippets**

### Проблема 6: Медленная работа npm install

**Решение:**
1. Используйте другой реестр npm:
   ```bash
   npm config set registry https://registry.npmjs.org/
   ```
2. Или используйте yarn:
   ```bash
   npm install -g yarn
   yarn install
   ```

### Проблема 7: Ошибки при сборке

**Решение:**
1. Удалите папку `node_modules` и файл `package-lock.json`
2. Выполните `npm install` заново
3. Проверьте версию Node.js (должна быть 18+)

---

## Проверка успешной установки

После выполнения всех шагов проверьте:

1. ✅ Node.js установлен: `node --version`
2. ✅ npm установлен: `npm --version`
3. ✅ Зависимости установлены: папка `node_modules` существует
4. ✅ Проект запускается: `npm run dev` открывает браузер
5. ✅ Visual Studio открывает проект без ошибок

---

## Следующие шаги

После успешной установки:

1. Изучите структуру проекта в `src/`
2. Начните разработку согласно плану в `План_UI.md`
3. Используйте `npm run dev` для запуска dev-сервера
4. Используйте `npm run build` для сборки продакшен версии

---

## Полезные команды

```bash
# Установка зависимостей
npm install

# Запуск dev-сервера
npm run dev

# Сборка для продакшена
npm run build

# Предпросмотр собранной версии
npm run preview

# Проверка кода (линтинг)
npm run lint

# Очистка кэша npm
npm cache clean --force

# Обновление зависимостей
npm update
```

---

**Готово!** Теперь вы можете разрабатывать Web-интерфейс в Visual Studio.
