Morfey1974/Industrial-Door-PLC-8-Doors/WebUI/NEXT_STEP.md

# Следующий шаг разработки

## Текущий статус

✅ **Этап 1: Настройка проекта React и базовая структура** - **ЗАВЕРШЕН**

Создано:
- ✅ Структура проекта согласно плану
- ✅ Все компоненты layout (Header, Sidebar, Tabs, Layout)
- ✅ Все общие компоненты (Button, Table, Card, Input, Dropdown)
- ✅ Все UI компоненты (DoorCard, EventRow, StatusBadge)
- ✅ Все страницы (Login, Dashboard, Monitoring, Configuration, Settings)
- ✅ Все хуки (useApi, useAutoRefresh, useAuth)
- ✅ Все контексты (AuthContext, AppContext)
- ✅ Все сервисы (api.js, auth.js, config.js)
- ✅ Все утилиты (formatters.js, validators.js, constants.js)
- ✅ Все стили (main.css, variables.css, components.css, layout.css)
- ✅ React Router настроен в App.jsx

---

## Следующий шаг: Этап 2 - Страница входа (Login) и аутентификация

### Задачи для реализации:

1. **Доработать компонент Login.jsx:**
   - Добавить обработку формы (onSubmit)
   - Интегрировать с AuthContext
   - Добавить валидацию полей
   - Обработка ошибок входа

2. **Доработать AuthContext:**
   - Реализовать логику входа (пока заглушка, без реального API)
   - Сохранение состояния пользователя в localStorage
   - Проверка аутентификации при загрузке приложения

3. **Добавить защиту маршрутов:**
   - Создать компонент PrivateRoute
   - Перенаправление на Login при отсутствии аутентификации

4. **Интегрировать Header с AuthContext:**
   - Отображение имени пользователя
   - Выпадающее меню профиля
   - Кнопка выхода

5. **Стилизация Login страницы:**
   - Применить цветовую схему (#3A6577, #EDEDED, #E6332A)
   - Добавить логотип DCM
   - Сделать форму красивой и функциональной

---

## Инструкция по выполнению

### 1. Установить зависимости (если еще не установлены)

```bash
cd "c:\Users\morfe\STM32CubeIDE\workspace_1.17.0\Industrial Door PLC\WebUI"
npm install
```

### 2. Запустить dev-сервер

```bash
npm run dev
```

### 3. Начать разработку

Откройте файлы в Visual Studio:
- `src/pages/Login.jsx` - для доработки страницы входа
- `src/context/AuthContext.jsx` - для реализации логики аутентификации
- `src/App.jsx` - для добавления PrivateRoute

### 4. Проверить результат

После реализации:
- Откройте `http://localhost:3000`
- Должна отображаться страница входа
- После "входа" должен происходить переход на Dashboard

---

## Полезные ссылки

- **План разработки:** `../План_UI.md`
- **Инструкция по установке:** `INSTALL_VS.md`
- **Быстрый старт:** `QUICKSTART.md`

---

## После завершения Этапа 2

Следующий этап: **Этап 3 - API интеграция и хуки**
