Morfey1974/Industrial-Door-PLC-8-Doors/WebUI/NEXT_STEP_DASHBOARD.md

# Следующий шаг: Этап 4 - Dashboard реализован ✅

## Что сделано:

1. ✅ Создан компонент `StatusCard.jsx` для отображения метрик
2. ✅ Создан компонент `DoorsOverview.jsx` для краткого обзора дверей
3. ✅ Реализован `Dashboard.jsx` с:
   - Получением данных из `/api/state` и `/api/doors`
   - Использованием хука `useApi` для загрузки данных
   - Использованием хука `useAutoRefresh` для автообновления каждые 10 секунд
   - Отображением состояния системы (NodeID, Role, LinkUp, NetReady, IP, Uptime)
   - Кратким обзором дверей (первые 8)
   - Обработкой состояний загрузки и ошибок
4. ✅ Добавлены стили для Dashboard и StatusCard
5. ✅ Исправлен хук `useApi` для правильной работы `refetch`
6. ✅ Исправлен URL API (порт 80 не добавляется в URL)

## Как проверить:

1. **Обновите страницу в браузере** (F5)
2. **Откройте Dashboard** - перейдите на главную страницу или кликните на вкладку "Мониторинг" → "Двери" (Dashboard откроется по умолчанию)
3. **Проверьте подключение к контроллеру:**
   - Если контроллер доступен по `http://192.168.1.50`, данные должны загрузиться
   - Если контроллер недоступен, вы увидите ошибку подключения

## Настройка IP контроллера:

Если IP контроллера отличается от `192.168.1.50`, измените в файле `src/utils/constants.js`:

```javascript
export const API_BASE_URL = process.env.VITE_API_BASE_URL || 'http://ВАШ_IP';
```

Или создайте файл `.env` в корне проекта `WebUI/`:

```
VITE_API_BASE_URL=http://192.168.1.100
VITE_API_PORT=8080
```

## Что вы увидите:

- **Карточки состояния системы:**
  - Node ID
  - Роль (MASTER/SLAVE)
  - Статус сети (Готова/Не готова)
  - Link (UP/DOWN)
  - IP адрес
  - Время работы (формат: "2д 3ч 15м")

- **Таблица дверей:**
  - ID двери
  - Статус (с цветовым кодированием)
  - Замок (Заблокирована/Разблокирована)
  - Время открытия (если открыта)

- **Автообновление:** Данные обновляются каждые 10 секунд автоматически

## Следующий шаг:

После проверки Dashboard можно переходить к:

**Этап 5: Мониторинг → Двери** - полная таблица всех дверей с фильтрами

Или

**Этап 6: Мониторинг → События** - журнал событий с пагинацией

---

**Примечание:** Если контроллер недоступен, Dashboard все равно откроется, но будет показывать ошибку подключения. Это нормально для разработки.
