Morfey1974/Industrial-Door-PLC-8-Doors/Documentation/Schematic_Industrial-door-controller-Master_2025-06-02.pdf

# CONNECTORS

# POWER 24VDC

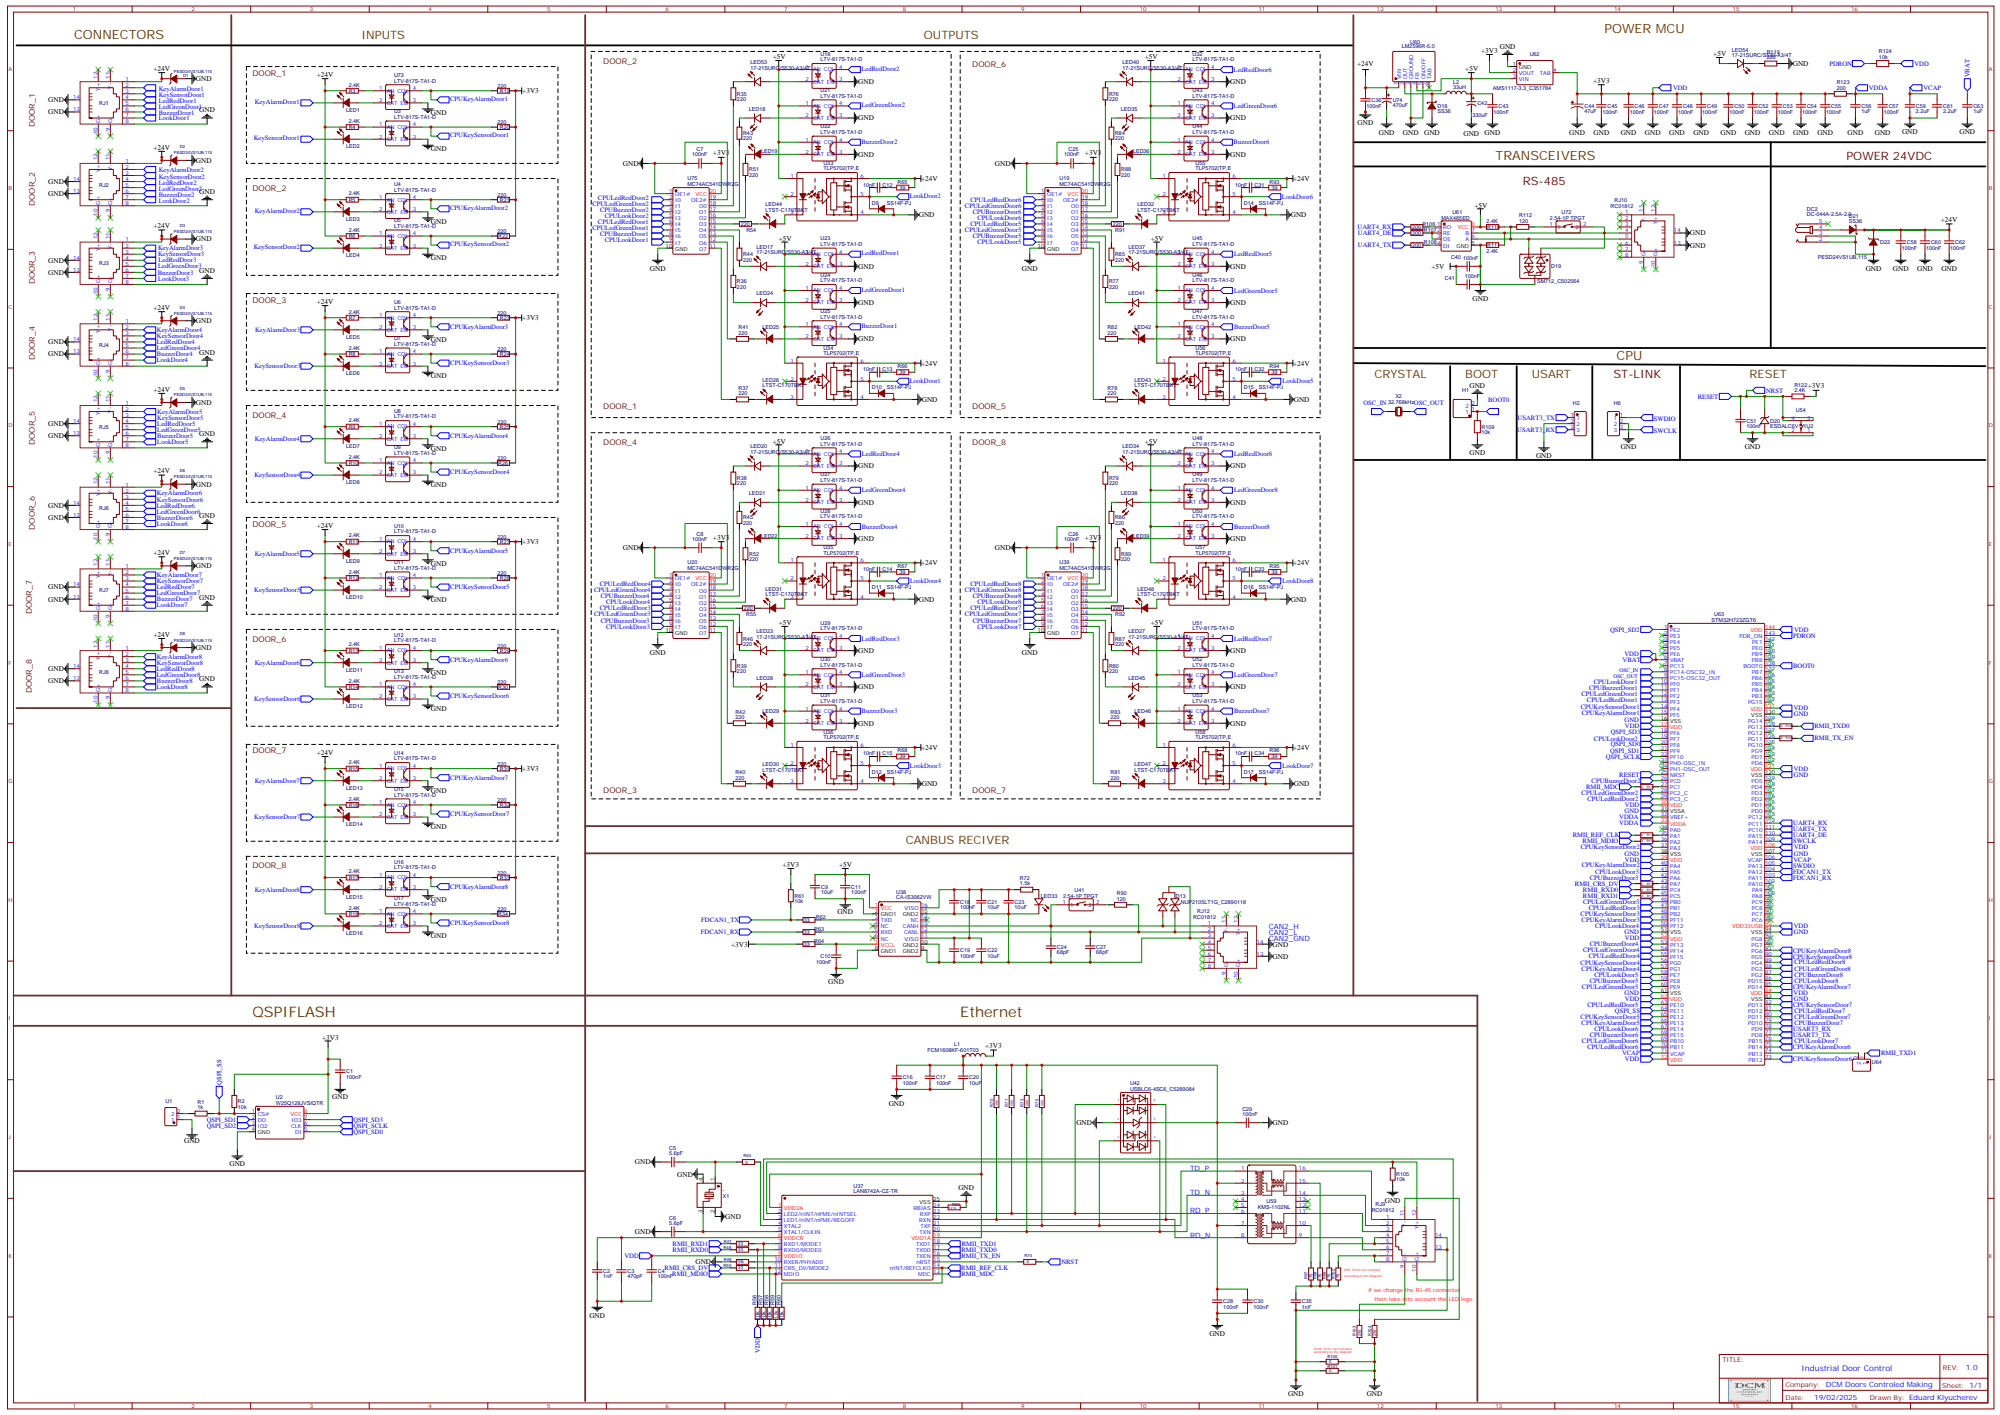
[picture p19: page 1]

R99, R102 not installed
according to the diagram

if we change the RJ-45 connector
then take into account the LED legs.

Company: DCM Doors Controled Making

Drawn By: Eduard Klyucherev

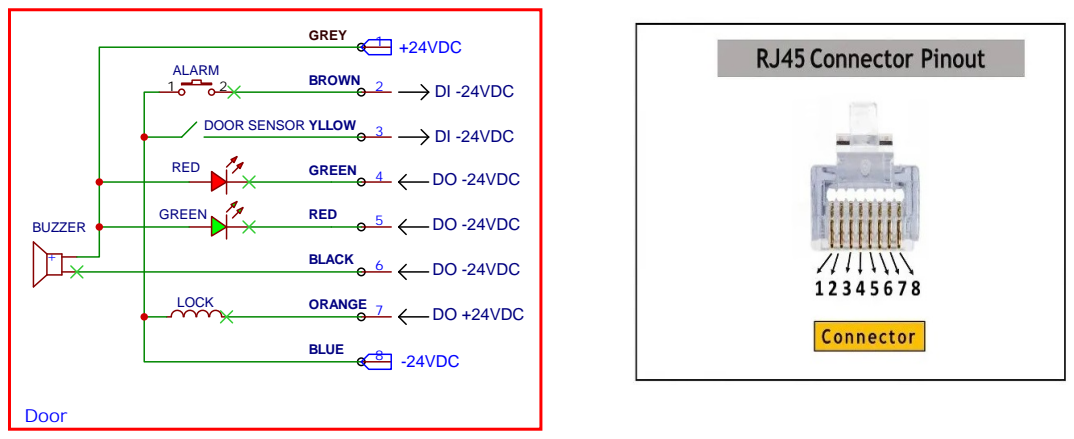
[picture p20: page 2]

Company: Doors Control Making

Drawn By: info@dcmaking.co.il

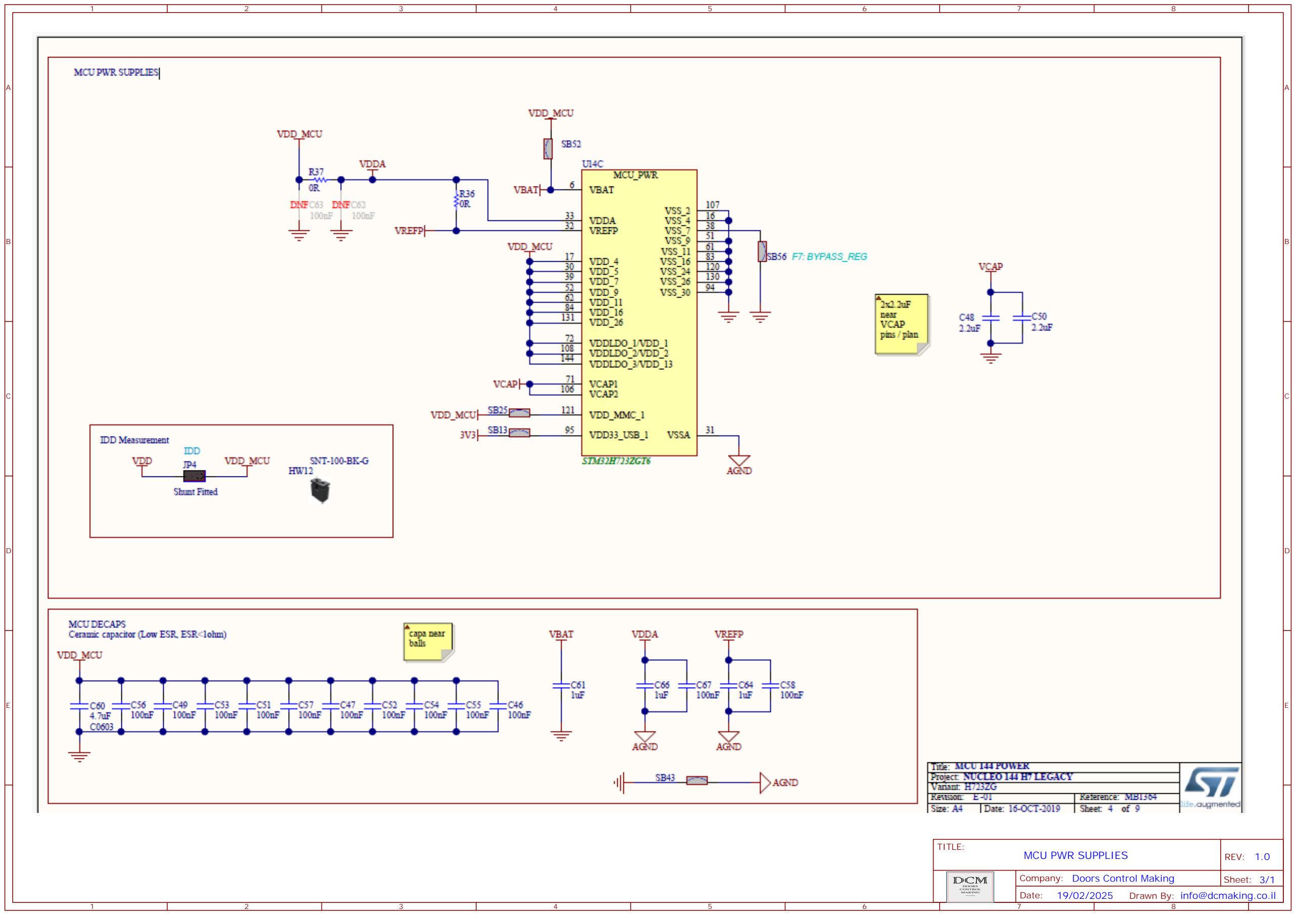
[picture p21: page 3]

A | A
B | B
C | C
D | D
E | E
MCU PWR SUPPLIES | REV: 1.0

### Drawn By: info@dcmaking.co.il

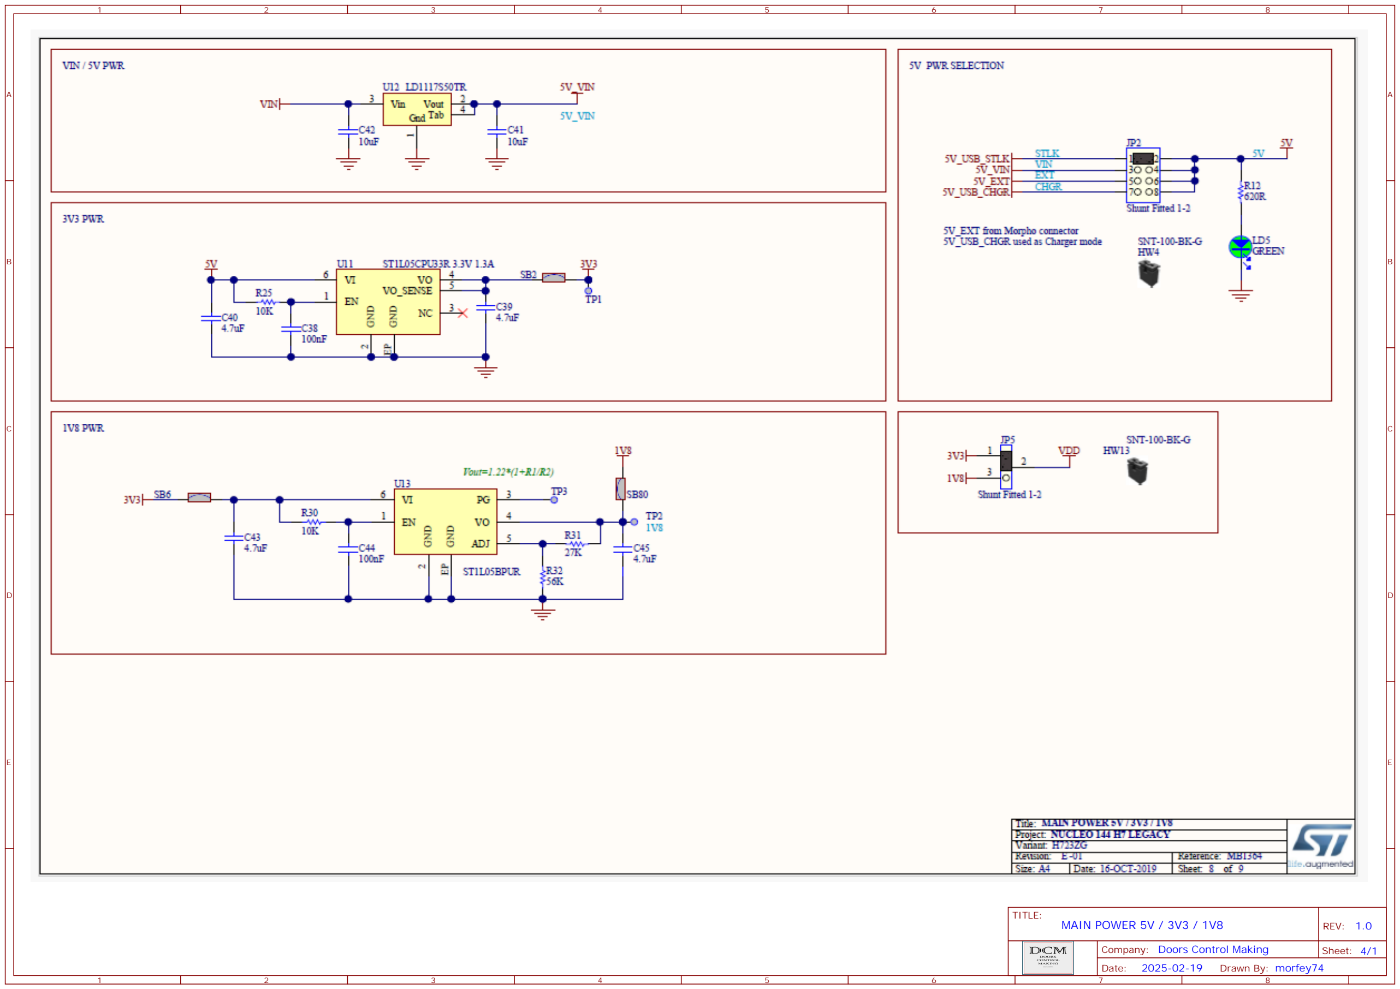
[picture p22: page 4]

A | A
B | B
C | C
D | D
E | E
MAIN POWER 5V / 3V3 / 1V8 | REV: 1.0
Date: | 2025-02-19

Drawn By: morfey74

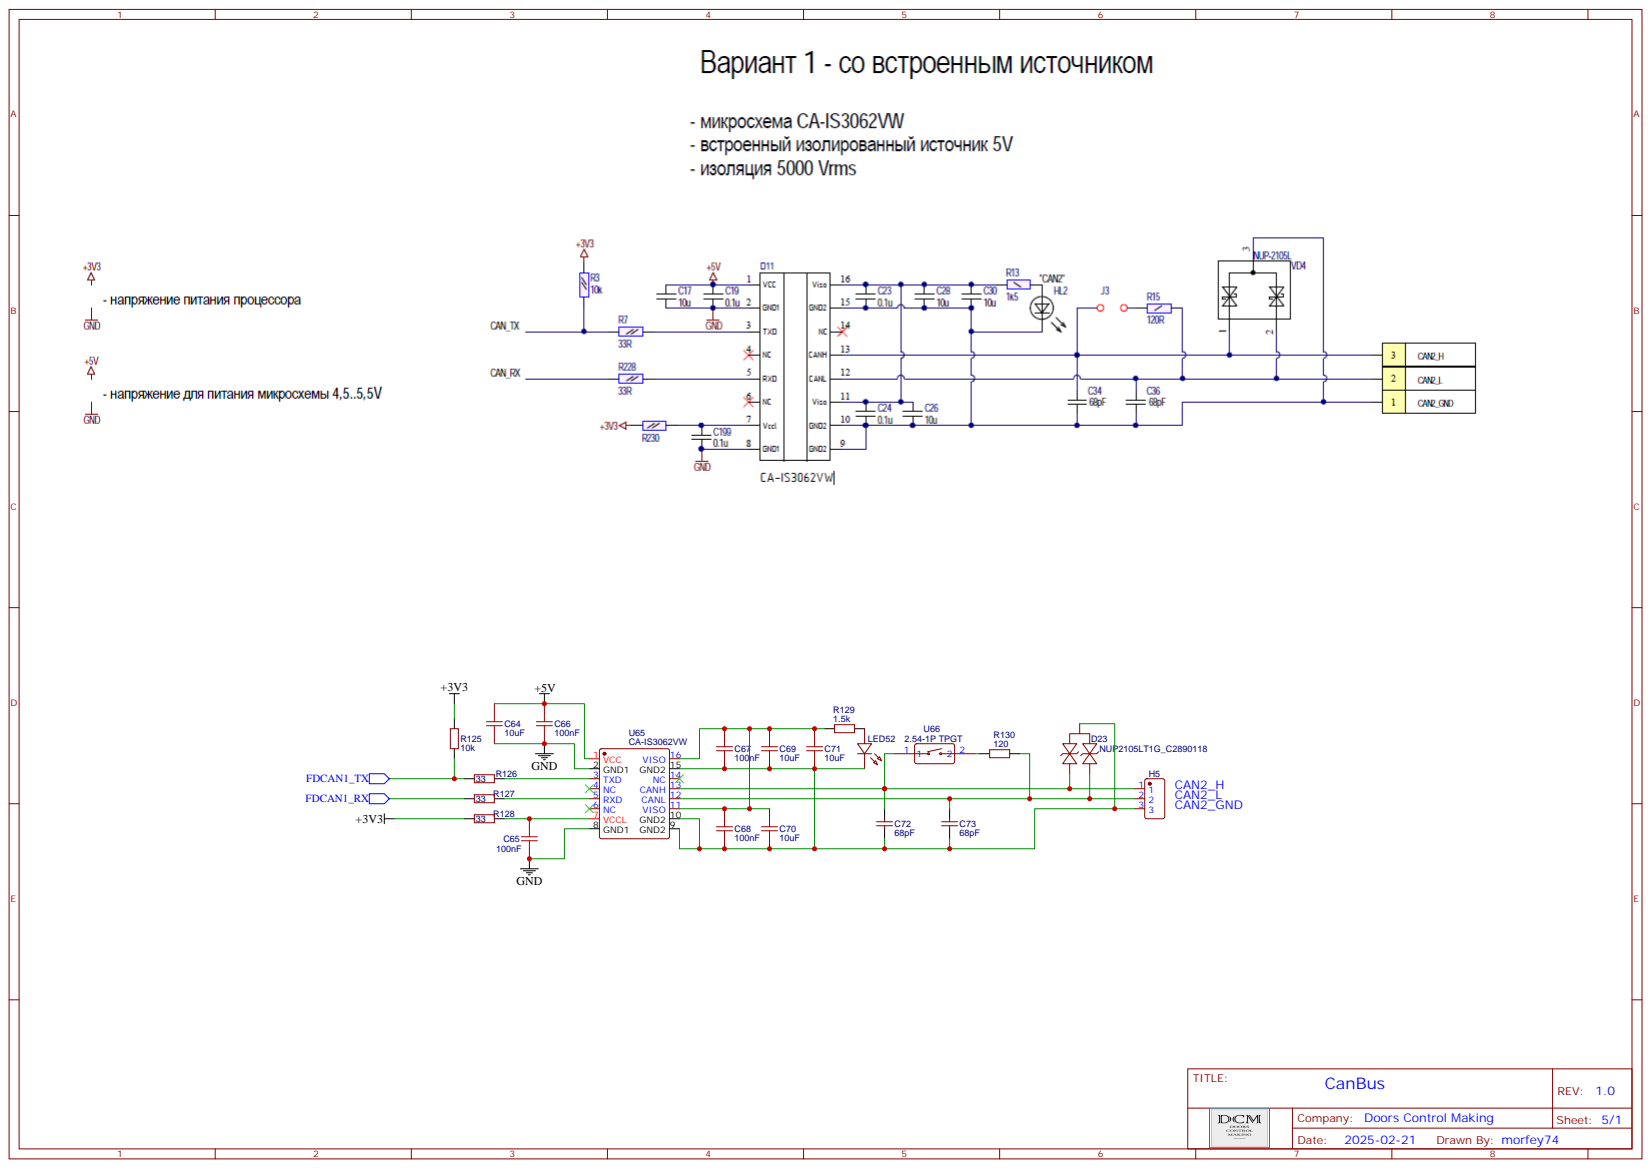
[picture p23: page 5]

GND2 10 VISO 11 CANL 12 CANH 13 NC 14 GND2 15 VISO 16

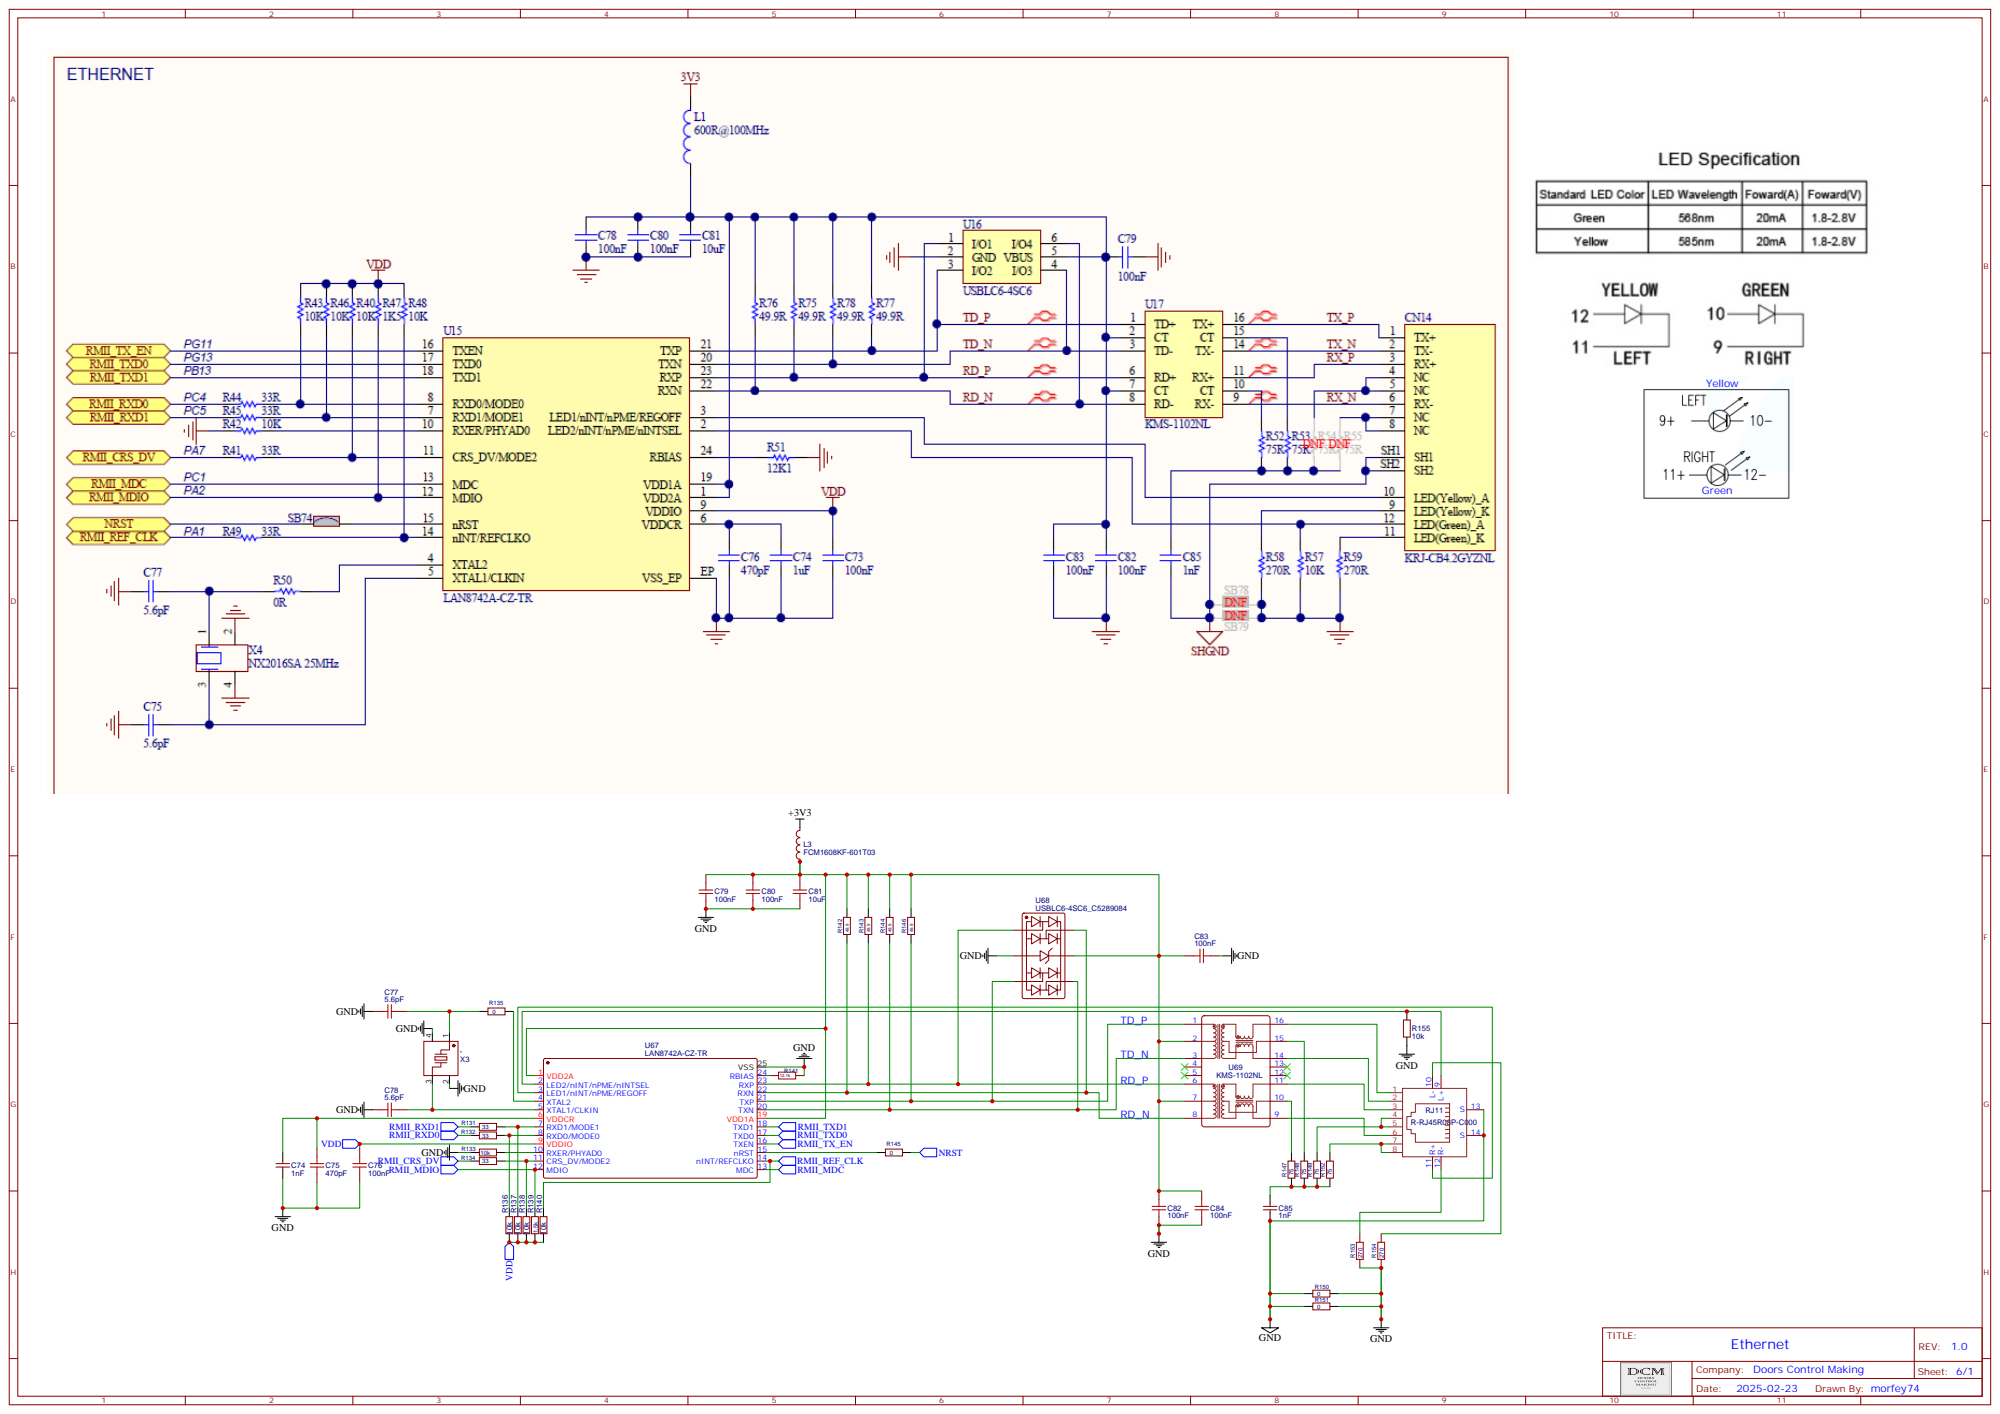
[picture p24: page 6]

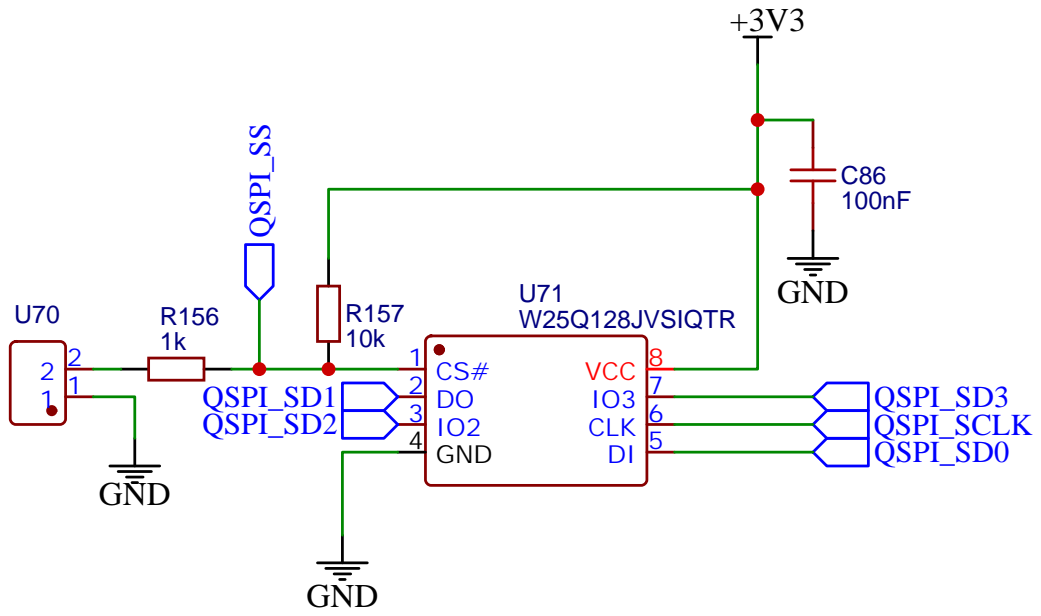
[picture p25: page 7]
