Morfey1974/Industrial-Door-PLC-8-Doors/Core/Src/main.c

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
/* Includes ------------------------------------------------------------------*/
#include "main.h"
#include "cmsis_os.h"
#include "fdcan.h"
#include "i2c.h"
#include "lwip.h"
#include "octospi.h"
#include "usart.h"
#include "gpio.h"

/* USER CODE BEGIN Includes */
#include <string.h>

#include <stdio.h>

#include "system/config_service.h"
#include "system/users_service.h"

/* Для временного теста сохранения конфигурации (Этап 7.3). */
#include "FreeRTOS.h"
#include "task.h"

/* USER CODE END Includes */


void SystemClock_Config(void);
static void MPU_Config(void);
void MX_FREERTOS_Init(void);
/* USER CODE BEGIN 0 */

/* --------------------------------------------------------------------------
 * Этап 7.3 (тест атомарного сохранения): временный автосейв через CFG_TEST_SAVE
 *
 * Что делает:
 *  - Если в препроцессоре задано CFG_TEST_SAVE=1, то после старта RTOS
 *    создаётся одноразовая задача, которая через 5 секунд вызывает
 *    ConfigService_Persist() для текущей активной конфигурации в RAM.
 *
 *    Как включить тест (точно по шагам)
 * 1) Включи define
 * STM32CubeIDE → Project Properties →
 * C/C++ Build → Settings → MCU GCC Compiler → Preprocessor → Defined symbols
 * Добавь:
 * CFG_TEST_SAVE=1
 *
 * Зачем:
 *  - На текущем этапе ещё нет CLI/WEB-триггера сохранения.
 *  - Нам нужен детерминированный способ начать цикл persist, чтобы
 *    выполнить power-cut тест (выключить питание во время записи).
 *
 * ВАЖНО:
 *  - В config_storage_qspi.c под CFG_TEST_SAVE добавлены «окна» (HAL_Delay)
 *    между payload и commit-header, чтобы человек успел рубануть питание.
 *  - В релизной сборке просто убери CFG_TEST_SAVE из defines.
 * -------------------------------------------------------------------------- */

#ifdef CFG_TEST_SAVE
extern project_config_t g_project_cfg; /* defined in App/system/config_service.c */

static void cfg_test_uart3_print(const char *s)
{
  if (!s) return;
  (void)HAL_UART_Transmit(&huart3, (uint8_t *)s, (uint16_t)strlen(s), 100);
}

/*
 * Реализация слабого хука из config_storage_qspi.c.
 * Держим здесь (USER CODE), чтобы при регенерации CubeMX не потерялось.
 */
void CfgTestHook_Print(const char *s)
{
  cfg_test_uart3_print(s);
}

static void CfgTestSaveTask(void *argument)
{
  (void)argument;

  cfg_test_uart3_print("CFG_TEST: persist in 5s...\r\n");
  vTaskDelay(pdMS_TO_TICKS(5000));

  cfg_test_uart3_print("CFG_TEST: persist start\r\n");
  const cfg_storage_status_t st = ConfigService_Persist(&g_project_cfg, NULL, 0U);

  char buf[80];
  (void)snprintf(buf, sizeof(buf), "CFG_TEST: persist done st=%u\r\n", (unsigned)st);
  cfg_test_uart3_print(buf);

  vTaskDelete(NULL);
}
#endif

/* USER CODE END 0 */

/**
  * @brief  The application entry point.
  * @retval int
  */
int main(void)
{

  /* MPU Configuration--------------------------------------------------------*/
  MPU_Config();

  /* Enable the CPU Cache */

  /* Enable I-Cache---------------------------------------------------------*/
  SCB_EnableICache();

  /* Enable D-Cache---------------------------------------------------------*/
  SCB_EnableDCache();

  /* MCU Configuration--------------------------------------------------------*/

  /* Reset of all peripherals, Initializes the Flash interface and the Systick. */
  HAL_Init();

  /* Configure the system clock */
  SystemClock_Config();

  /* Initialize all configured peripherals */
  MX_GPIO_Init();
  MX_UART4_Init();
  MX_USART3_UART_Init();
  MX_FDCAN1_Init();
  MX_OCTOSPI1_Init();
  MX_I2C1_Init();
  /* USER CODE BEGIN 2 */

  /* Загрузка конфигурации (MASTER: из QSPI или по умолчанию; SLAVE: по умолчанию) */
  ConfigService_InitOnBoot(0);

  /* Инициализация базы пользователей (MASTER only) */
  UsersService_Init();

#ifdef CFG_TEST_SAVE
  /*
   * Создаём одноразовую задачу автосейва.
   * xTaskCreate допустимо вызывать до старта планировщика.
   */
  (void)xTaskCreate(CfgTestSaveTask, "CfgTestSave", 256, NULL, tskIDLE_PRIORITY + 1U, NULL);
#endif


  /* USER CODE END 2 */

  /* Init scheduler */
  osKernelInitialize();  /* Call init function for freertos objects (in cmsis_os2.c) */
  MX_FREERTOS_Init();

  /* Start scheduler */
  osKernelStart();

  /* We should never get here as control is now taken by the scheduler */

  /* Infinite loop */
  /* USER CODE BEGIN WHILE */
  while (1)
  {
    /* USER CODE END WHILE */

    /* USER CODE BEGIN 3 */
  }
  /* USER CODE END 3 */
}

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
 /* MPU Configuration */

void MPU_Config(void)
{
  MPU_Region_InitTypeDef MPU_InitStruct = {0};

  /* Disables the MPU */
  HAL_MPU_Disable();

  /** Initializes and configures the Region and the memory to be protected
  */
  MPU_InitStruct.Enable = MPU_REGION_ENABLE;
  MPU_InitStruct.Number = MPU_REGION_NUMBER0;
  MPU_InitStruct.BaseAddress = 0x0;
  MPU_InitStruct.Size = MPU_REGION_SIZE_4GB;
  MPU_InitStruct.SubRegionDisable = 0x87;
  MPU_InitStruct.TypeExtField = MPU_TEX_LEVEL0;
  MPU_InitStruct.AccessPermission = MPU_REGION_NO_ACCESS;
  MPU_InitStruct.DisableExec = MPU_INSTRUCTION_ACCESS_DISABLE;
  MPU_InitStruct.IsShareable = MPU_ACCESS_SHAREABLE;
  MPU_InitStruct.IsCacheable = MPU_ACCESS_NOT_CACHEABLE;
  MPU_InitStruct.IsBufferable = MPU_ACCESS_NOT_BUFFERABLE;

  HAL_MPU_ConfigRegion(&MPU_InitStruct);

  /** Initializes and configures the Region and the memory to be protected
  */
  MPU_InitStruct.Number = MPU_REGION_NUMBER1;
  MPU_InitStruct.BaseAddress = 0x08000000;
  MPU_InitStruct.Size = MPU_REGION_SIZE_1MB;
  MPU_InitStruct.SubRegionDisable = 0x0;
  MPU_InitStruct.TypeExtField = MPU_TEX_LEVEL1;
  MPU_InitStruct.AccessPermission = MPU_REGION_PRIV_RO;
  MPU_InitStruct.DisableExec = MPU_INSTRUCTION_ACCESS_ENABLE;
  MPU_InitStruct.IsShareable = MPU_ACCESS_NOT_SHAREABLE;
  MPU_InitStruct.IsCacheable = MPU_ACCESS_CACHEABLE;

  HAL_MPU_ConfigRegion(&MPU_InitStruct);

  /** Initializes and configures the Region and the memory to be protected
  */
  MPU_InitStruct.Number = MPU_REGION_NUMBER2;
  MPU_InitStruct.BaseAddress = 0x24000000;
  MPU_InitStruct.Size = MPU_REGION_SIZE_512KB;
  MPU_InitStruct.SubRegionDisable = 0xC0;
  MPU_InitStruct.AccessPermission = MPU_REGION_FULL_ACCESS;
  MPU_InitStruct.DisableExec = MPU_INSTRUCTION_ACCESS_DISABLE;
  MPU_InitStruct.IsShareable = MPU_ACCESS_SHAREABLE;
  MPU_InitStruct.IsBufferable = MPU_ACCESS_BUFFERABLE;

  HAL_MPU_ConfigRegion(&MPU_InitStruct);

  /** Initializes and configures the Region and the memory to be protected
  */
  MPU_InitStruct.Number = MPU_REGION_NUMBER3;
  MPU_InitStruct.BaseAddress = 0x30000000;
  MPU_InitStruct.Size = MPU_REGION_SIZE_32KB;
  MPU_InitStruct.SubRegionDisable = 0x0;
  MPU_InitStruct.DisableExec = MPU_INSTRUCTION_ACCESS_ENABLE;
  MPU_InitStruct.IsShareable = MPU_ACCESS_NOT_SHAREABLE;
  MPU_InitStruct.IsCacheable = MPU_ACCESS_NOT_CACHEABLE;
  MPU_InitStruct.IsBufferable = MPU_ACCESS_NOT_BUFFERABLE;

  HAL_MPU_ConfigRegion(&MPU_InitStruct);
  /* Enables the MPU */
  HAL_MPU_Enable(MPU_PRIVILEGED_DEFAULT);

}

/**
  * @brief  Period elapsed callback in non blocking mode
  * @note   This function is called  when TIM6 interrupt took place, inside
  * HAL_TIM_IRQHandler(). It makes a direct call to HAL_IncTick() to increment
  * a global variable "uwTick" used as application time base.
  * @param  htim : TIM handle
  * @retval None
  */
extern void xPortSysTickHandler(void);
#include "portmacro.h"  /* portYIELD_FROM_ISR — явный запрос переключения после тика из TIM6 */

void HAL_TIM_PeriodElapsedCallback(TIM_HandleTypeDef *htim)
{
  if (htim->Instance == TIM6)
  {
    HAL_IncTick();
    /* Тик FreeRTOS из TIM6 (SysTick не срабатывает в этой конфигурации) */
    if (xTaskGetSchedulerState() != taskSCHEDULER_NOT_STARTED)
    {
      static uint8_t s_t6_logged;
      if (!s_t6_logged)
      {
        s_t6_logged = 1;
        extern UART_HandleTypeDef huart3;
        static const char t6[] = "RTC: T6\r\n";
        (void)HAL_UART_Transmit(&huart3, (const uint8_t *)t6, (uint16_t)(sizeof(t6)-1), 2);
      }
      xPortSysTickHandler();
      /* Явный запрос переключения: после тика из TIM6 PendSV может не срабатывать. */
      portYIELD_FROM_ISR(pdTRUE);
    }
  }
}

/**
  * @brief  This function is executed in case of error occurrence.
  * @retval None
  */
void Error_Handler(void)
{
  /* USER CODE BEGIN Error_Handler_Debug */
  /* User can add his own implementation to report the HAL error return state */
  __disable_irq();
  while (1)
  {
  }
  /* USER CODE END Error_Handler_Debug */
}
#ifdef USE_FULL_ASSERT
/**
  * @brief  Reports the name of the source file and the source line number
  *         where the assert_param error has occurred.
  * @param  file: pointer to the source file name
  * @param  line: assert_param error line source number
  * @retval None
  */
void assert_failed(uint8_t *file, uint32_t line)
{
  /* USER CODE BEGIN 6 */
  /* User can add his own implementation to report the file name and line number,
     ex: printf("Wrong parameters value: file %s on line %d\r\n", file, line) */
  /* USER CODE END 6 */
}
#endif /* USE_FULL_ASSERT */
