Morfey1974/Industrial-Door-PLC-8-Doors/App/logic/logic_core.h

#pragma once

#include <stdint.h>
#include "system/app_events.h"
#include "logic/logic_deps.h"

/* ============================================================
 * LogicCore (ЭТАП 5.2–5.4, Master-only, nodeId=1)
 *
 * Назначение:
 *  - хранит снимок состояния дверей (глобально 1..80)
 *  - применяет модель зависимостей (deps)
 *  - формирует целевое состояние блокировки
 *  - выдаёт команды дверям:
 *      * локально (nodeId=1): Doors_RequestLock()
 *      * удалённо (nodeId!=1): пока заглушка (этап 6)
 *
 * ВАЖНО:
 *  - LogicCore НЕ управляет аппаратурой напрямую.
 *  - Он работает только через “модель двери” (Doors_RequestLock)
 *  - Вход = события EventBus + snapshot из Doors_GetState (для локальных дверей)
 * ============================================================ */

typedef struct logic_core_t
{
    logic_deps_t deps;

    /* --- snapshot: физическое состояние дверей (глобально) --- */
    uint8_t physOpen[APP_MAX_DOORS]; /* 1 если дверь физически OPEN */

    /* --- Сигнализация на удалённых узлах (из CAN STATUS), индекс globalDoorId-1 ---
     * На SLAVE в кадре: alarmActive ≈ кнопка Alarm, signalingActive ≈ флаг alarming (любая причина).
     * Полная маска alarmReasons на шине не передаётся; восстанавливаем минимально достаточное подмножество
     * для WebUI (мониторинг / страница «Алармы»), см. LogicCore_OnCanStatus.
     */
    uint32_t remoteAlarmReasons[APP_MAX_DOORS];

    /* --- 2.4.6: “post-close delay” для эффекта двери в зависимостях ---
     *
     * Интерпретация по ТЗ:
     *  - если дверь открыта -> её зависимости активны немедленно
     *  - если дверь закрылась -> эффект зависимостей НЕ снимается сразу,
     *    а снимается только когда придёт EVT_DOOR_POST_CLOSE_READY для этой двери.
     *
     * Это даёт детерминированность и устраняет “дребезг” логики при быстром открытии/закрытии.
     */
    uint8_t depActive[APP_MAX_DOORS];      /* 1 если зависимости этой двери учитываются */
    uint8_t closePending[APP_MAX_DOORS];   /* 1 если ждём POST_CLOSE_READY после CLOSE (для источника, устарело) */

    /* --- Post-close delay для целевых дверей ---
     * Когда источник закрывается, целевые двери остаются заблокированными
     * на время их собственного post-close таймаута
     */
    uint8_t targetUnlockPending[APP_MAX_DOORS];  /* 1 если целевая дверь ждет разблокировки */
    uint32_t targetUnlockStartMs[APP_MAX_DOORS]; /* когда начался отсчет для целевой двери */

    /* --- вычисленный результат --- */
    door_bitset_t lockRequired; /* глобальная маска дверей, которые ТРЕБУЕТСЯ блокировать */
} logic_core_t;

/* Init + (опционально) заполнить тестовую таблицу зависимостей */
void LogicCore_Init(logic_core_t *lc);

/* Подать событие из EventBus в LogicCore */
void LogicCore_OnEvent(logic_core_t *lc, const app_event_t *evt);

/* ============================================================
 * ЭТАП 6.4: обновление snapshot от SLAVE (STATUS кадры)
 *
 * Master принимает состояние 8 дверей SLAVE в виде битовых масок.
 * LogicCore обновляет глобальный снимок:
 *   - physOpen[...] и depActive[...] для соответствующих globalDoorId;
 *   - remoteAlarmReasons[...] по маскам alarmActive/signalingActive (для /api/doors на MASTER).
 * ============================================================ */
void LogicCore_OnCanStatus(logic_core_t *lc, uint8_t nodeId,
                           uint8_t presentMask,
                           uint8_t physClosedMask,
                           uint8_t alarmActiveMask,
                           uint8_t signalingActiveMask,
                           uint8_t lockOutputActiveMask);

/* Принудительно пересчитать и применить (можно дергать после конфиг-активации) */
void LogicCore_RecomputeAndApply(logic_core_t *lc);

/**
 * Проверить, требуется ли блокировка для двери с заданным globalDoorId (1..80).
 * Используется NC-логикой: разблокировка по импульсу возможна только если возврат 0.
 * lc — экземпляр LogicCore (например, CommsTask_GetLogicCore()).
 * Возвращает 1 если блокировка требуется, 0 если нет.
 */
uint8_t LogicCore_IsLockRequired(logic_core_t *lc, uint8_t globalDoorId);

/* ============================================================
 * Ручная команда LOCK/UNLOCK (ЭТАП 5.5: разрешение конфликтов)
 *
 * Команды от внешних интерфейсов (HTTP/RS-485/CAN/LOCAL) должны
 * проходить через LogicCore, чтобы:
 *  - оставаться в рамках инвариантов DoorTask (безопасность)
 *  - иметь единый вход для будущих правил приоритетов
 *
 * Сейчас (Standalone) команда применяется только к локальным дверям MASTER
 * (door_id 1..8). Удалённые двери будут обрабатываться через CAN (ЭТАП 6).
 *
 * return: 1 если команда принята и передана в DoorTask, иначе 0.
 * ============================================================ */
uint8_t LogicCore_SubmitManualLockCmd(logic_core_t *lc,
                                     uint8_t localDoorId,
                                     uint8_t lock_on,
                                     uint32_t source,
                                     uint32_t ttl_ms);
