Morfey1974/Industrial-Door-PLC-8-Doors/App/system/http_server.h

#pragma once

#include <stdint.h>

/* =========================================================
 * Флаги отладки HTTP сервера
 * ========================================================= */
/* =========================================================
 * Флаги отладки HTTP сервера (отключены по умолчанию)
 * Для включения отладки установите HTTP_DEBUG_ENABLED=1
 * ========================================================= */
#ifndef HTTP_DEBUG_ENABLED
#define HTTP_DEBUG_ENABLED 0  /* 1 = включить отладку, 0 = выключить */
#endif

/* Детализация отладки (можно включать/выключать отдельно) */
#ifndef HTTP_DEBUG_REQUESTS
#define HTTP_DEBUG_REQUESTS 1  /* Логировать входящие запросы */
#endif

#ifndef HTTP_DEBUG_RESPONSES
#define HTTP_DEBUG_RESPONSES 1  /* Логировать формирование ответов */
#endif

#ifndef HTTP_DEBUG_SEND
#define HTTP_DEBUG_SEND 1  /* Логировать отправку данных */
#endif

#ifndef HTTP_DEBUG_ERRORS
#define HTTP_DEBUG_ERRORS 1  /* Логировать ошибки */
#endif

#ifdef __cplusplus
extern "C" {
#endif

/* =========================================================
 * ЭТАП 9.2 — Простой HTTP сервер поверх lwIP sockets
 *
 * Почему "свой" сервер, а не lwip httpd:
 *  - нам нужен REST/JSON, проще сделать минимальный парсер;
 *  - контроль по времени (не мешаем управлению дверьми);
 *  - минимум зависимостей.
 *
 * Ограничения этой версии:
 *  - поддерживаем только HTTP/1.0/1.1, только один запрос на соединение;
 *  - только GET (на этом шаге);
 *  - короткие ответы (state/doors/config/stat).
 *
 * Дальше (9.3+) можно добавить PUT/POST, chunking, keep-alive и т.д.
 * ========================================================= */

void HttpServer_Init(uint16_t port);
/* Полностью остановить HTTP сервер и закрыть listen-сокет.
 * Нужен для корректной обработки link down/up без перезагрузки МК:
 * - на link down закрываем сокет и освобождаем ресурсы;
 * - на link up поднимаем сервер заново через HttpServer_Init().
 */
void HttpServer_Deinit(void);

/* Быстрая проверка, поднят ли listen-сокет.
 * Возвращает:
 *  - 1U: сервер инициализирован и готов принимать подключения;
 *  - 0U: сервер не поднят (нужно вызвать Init или повторить позже).
 */
uint8_t HttpServer_IsReady(void);

/* Обслужить максимум один входящий клиент.
 * timeout_ms:
 *  - сколько ждать accept (0 = не ждать).
 *
 * Важно:
 *  - функция должна вызываться из низкоприоритетной задачи;
 *  - при отсутствии клиентов быстро возвращает управление.
 */
void HttpServer_PollOnce(uint32_t timeout_ms);

#ifdef __cplusplus
}
#endif
