Morfey1974/Industrial-Door-PLC-8-Doors/App/system/config_service.h

#pragma once

#include <stdint.h>

#include "config/config_format.h"          /* project_config_t */
#include "config/config_storage_qspi.h"   /* cfg_storage_status_t, cfg_storage_info_t */

#ifdef __cplusplus
extern "C" {
#endif

/* Optional logging hook (printf-like messages already formatted).
 * If left NULL - no logging.
 */
extern void (*ConfigService_LogWrite)(const char *msg);

/* Boot: read-only load. Если слоты невалидны — дефолт в RAM. */
cfg_storage_status_t ConfigService_BootLoad(project_config_t *out_cfg, cfg_storage_info_t *out_info);

/* Совместимость с тем, что уже вставлено в main.c */
void ConfigService_InitOnBoot(project_config_t *out_cfg);

/* Persist: атомарная запись Slot A/B. Вызывать после старта RTOS.
 * username, client_unix_sec: при сохранении из UI — имя пользователя и время с ПК (Unix сек);
 * при NULL/0 журнал пишется с RTC (как раньше).
 */
cfg_storage_status_t ConfigService_Persist(const project_config_t *cfg,
                                           const char *username,
                                           uint32_t client_unix_sec);

/* Apply runtime: применяет конфигурацию к runtime модулям (doors, etc.)
 * Вызывается автоматически при загрузке конфигурации при старте.
 * Также нужно вызывать после ConfigService_Persist, если конфигурация применяется без перезагрузки.
 */
void ConfigService_ApplyRuntime(const project_config_t *cfg);

#ifdef __cplusplus
}
#endif
