Morfey1974/Industrial-Door-PLC-8-Doors/(commit log)

2025-03-15 Проба перегрузки файлов
2025-03-16 Попытался симитировать две двери. Подключил релейный блок.
2026-01-03 Сохранение от 03.01.2026
2026-01-03 Удален PCB файл
2026-01-03 Fix project structure: move CubeIDE project to repo root
    [Industrial Door PLC.ioc, main.c, main.h]
2026-01-03 Для эксперимента
2026-01-03 Update master schematic PDF
2026-01-03 Восстановлен
2026-01-10 Протоколы работают
2026-01-10 Подробная фиксация итогов “что сделано до этого момента”
2026-01-10 Bring-up интерфейсов ЗАВЕРШЁН
2026-01-10 Добавлены слои
2026-01-11 Дальнейшие действия
2026-01-16 Выполнен Этап 7
2026-01-16 Обновил Readmy
2026-01-17 Выполнено до 7.3 включительно
2026-01-17 Закончен Этап 7
2026-01-22 Решена проблема /api/doors
2026-01-22 Add all project files: source code, drivers, middleware, documentation
2026-01-22 Исправлено api/doors
2026-01-22 Решениие конфликта git
2026-01-23 Добавлен Web-интерфейс на React (Этап 9-10)
    - Создан React проект в папке WebUI/
    - Реализована базовая структура проекта согласно плану
    - Созданы компоненты layout (Header, Sidebar, Tabs, Layout)
    - Созданы общие компоненты (Button, Table, Card, Input, Dropdown)
    - Созданы UI компоненты (DoorCard, EventRow, StatusBadge)
    - Реализован Dashboard с отображением состояния системы
    - Настроена интеграция с API контроллера
    - Добавлен план разработки UI (План_UI.md)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
2026-01-23 Этап 5: Реализация страницы Мониторинг → Двери
    - Создан компонент DoorTable.jsx для полной таблицы дверей со всеми колонками из API
    - Создан компонент FilterBar.jsx с фильтрами по статусу и ID двери
    - Реализована страница Monitoring/Doors.jsx с использованием useApi и useAutoRefresh
    - Добавлена обработка состояний загрузки и ошибок
    - Улучшены стили для filter-bar, monitoring-doors, состояний загрузки/ошибок
    - Добавлен стиль для к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
2026-01-24 Fix HTTP body sending and improve event journal diagnostics
    - Optimize HTTP response body sending: reduce chunk size to 128 bytes, increase delays between chunks, improve error handling
    - Translate event journal diagnostic messages to English for better UART terminal compatibility
    - Add JOURNAL_DIAGNOSTIC.md documentation for debugging event storage
    - Improve UI stability: prevent concurrent requests, add silent refresh mode, better error handling
    - Add logo link to homepage in Header component
    - Add EventsTable, EventsFilterBar, and Pagination components for events monitoring
    [app_log_uart3.c, event_journal.c, event_journal.h, http_api.c, http_server.c]
2026-01-24 Реализован Web UI: Dashboard, Мониторинг дверей и событий с фильтрацией и пагинацией
    - Добавлен полнофункциональный Web-интерфейс на React 18+ с Vite
    - Реализованы страницы: Главная (Dashboard), Мониторинг дверей, Мониторинг событий
    - Добавлена фильтрация событий по типу, ID двери, источнику
    - Реализована пагинация с поддержкой 10, 20, 50 записей на странице
    - Добавлено автообновление данных каждые 10 секун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
2026-01-24 Улучшения UI: логика черновика, обработка ошибок, React Router flags
    - Исправлена логика автосохранения черновика: не сохраняется при загрузке с сервера
    - Добавлен флаг hasUnsavedChanges для отслеживания реальных изменений
    - Улучшена обработка сетевых ошибок API (ERR_CONNECTION_RESET, ERR_NETWORK и др.)
    - Добавлены future flags для React Router v7 (v7_startTransition, v7_relativeSplatPath)
    - Добавлена документация: CONFIG_DOORS_IMPLEMENTATION.md и CONFIG_DOORS_TESTING.md
    -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
    [http_api.c]
2026-01-25 Apply config to controller: fix timeouts, deadlock, logging
    - Remove JournalTask suspend during persist (deadlock with QSPI lock)
    - Short CFG phase logs (CFG:1..6), printf around persist for UART
    - Reduce SaveNew log volume; add sec0 start/ok timing
    - HTTP body send: log errno, 400 attempts, 50ms delay after headers
    - Increase httpTask stack to 16KB
    - Drop unused qspi_erase_region_4k
    Result: PUT /api/config works end-to-end; only projectName/openTimeoutMs
    applied. Doors/deps/timeouts need firmware extension.
    [config_service.c, config_storage_qspi.c, http_api.c, http_server.c]
2026-01-25 Вариант A: полная загрузка конфигурации (PUT /api/config/full)
    - json_simple: Json_FindArraySpan, Json_ArrayNextObject (quote/brace-aware)
    - Лимиты v1: 8 дверей, 16 edges, 8 postCloseTimeouts (config_format.h)
    - put_config_full: разбор doors/edges/postCloseTimeouts, валидация, persist
    - Логирование в UART на этапах парсинга, валидации и записи
    - UI: «Применить» -> putConfigFull, проверка лимитов, полный конфиг
    - План CONFIG_APPLY_FULL_PLAN.md
2026-01-25 README, UI, firmware: итоги и доработки
    README:
    - Убраны описание проблем, известные наблюдения, как тестировать, примечания по логам
    - Сокращён список ключевых файлов, актуальный статус по этапам и плану
    - Добавлено: автосброс после применения конфига, PUT /api/config/full
    Firmware:
    - Автосброс после успешной записи конфигурации (PUT /api/config, /api/config/full)
    - Удалены PUT /api/config/test и тестовая запись 1 байта во Flash
    WebUI:
    - Э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
2026-01-25 HANDOFF_NEW_CHAT.md: контекст для перехода в новый чат
2026-01-26 Реализована функция 'Загрузить с контроллера'
    - Улучшена функция loadConfigFromServer: нормализация postCloseTimeouts (фильтрация дефолтных 500ms), улучшенная обработка ошибок
    - Добавлено подтверждение при наличии несохраненных изменений в handleLoadFromController
    - Добавлена валидация загруженных данных (мягкая - пустое projectName не считается ошибкой при загрузке)
    - Улучшены сообщения об ошибках с более понятным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
2026-01-27 Реализована страница профиля с изменением пароля
    - Добавлена страница Profile с формой изменения пароля
    - Реализован endpoint POST /api/auth/change-password на backend
    - Добавлена валидация пароля (минимум 8 символов)
    - Пароль хранится в памяти (для отладки)
    - Обновлен AuthContext для поддержки changePassword
    - Добавлены стили для страницы профиля
2026-01-27 Добавлена страница 'Права доступа' в меню настроек для Admin и Super Admin
2026-01-27 Восстановление пароля: токены, API, модалки, страница сброса; чёрный текст в формах пользователей; SplashScreen и публичный маршрут /reset-password
    [http_api.c, users_service.c, users_service.h]
2026-01-29 Редактор карты: двери, метки, панорамирование, fit-to-view, inline-редактирование комментариев
    - Вкладка Карта: MappingCanvas, MappingHeader, MappingToolbar
    - Типы дверей: одинарная, двойная, раздвижная, электрическая; отображение ID и номера
    - Панорамирование только средней кнопкой мыши; кнопка «Показать карту полностью»
    - Редактирование комментариев прямо на холсте
    - Стили: скроллбар для контента и таблиц мон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
2026-01-29 Карта: маркеры стены без заливки, маркеры скрываются в режиме Просмотр
    - Маркеры концов стены: fill=none, видно соединение линий
    - Маркеры редактирования (дверь/стена) только в режиме Редактирование
    - WALL_HANDLE_R=10, комментарии в коде
2026-01-29 Комментарии: многострочность, выравнивание, Esc, сброс свойств при смене инструмента
    - Комментарий: до 500 символов, textarea, Shift+Enter — новая строка, Enter/Esc — выход
    - Esc закрывает редактор и снимает выбор (панель Свойства закрывается)
    - Выравнивание комментария в панели: Влево, По центру, Вправо
    - При смене инструмента сбрасывается выбор — показываются настройки выбранного инструмента
2026-01-29 Маппинг: исправление вставки двери, подписи раздвижной двери, история Undo
    - MappingCanvas: объявлена numVertical (исправлен падение при вставке двери)
    - MappingCanvas: защита pt/objects/doors при вставке двери
    - MappingCanvas: раздвижная 90° — ID повёрнут на 180°; раздвижная 270° — Номер повёрнут на 180°
    - MappingToolbar: doorList и select «Дверь» — защита от undefined, value для globalDoorId
    - Mapping: addToHistory без setState внутри setState, try/catch при сериализации
2026-01-29 Маппинг: сохранение/загрузка в файл и QSPI, интеграция с конфигурацией
    - Карта маппинга: Сохранить/Загрузить в файл (ИМЯ_map.json), Выгрузить/Загрузить из контроллера (QSPI)
    - Маппинг открывается из Конфигурации (кнопка Маппинг рядом с Загрузить/Экспорт/Импорт), убран из сайдбара
    - Конфигурация и карта: единое имя (ИМЯ_conf.json / ИМЯ_map.json)
    - Модальные подтверждения вместо alert: выгрузка/загрузка в к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
2026-01-30 Маппинг: быстрый Просмотр, опрос дверей 1 с, курсор/привязка, контроллер без блокировки
    Контроллер:
    - build_doors: копирование состояния под мьютексом и сразу отпуск — логика дверей не блокируется при /api/doors
    - httpTask: временное повышение приоритета на время persist (config/mapping)
    - doorsTask: приоритет Low -> Normal
    WebUI Маппинг:
    - Просмотр: первый кадр без doors (viewDoorsDeferred), затем idle — переключение мгновенное
    - Опро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
2026-01-30 Mapping: Backspace/Delete в поле текста комментария, автофокус редактора, отступы в textarea, цвет стены при перетаскивании правой кнопкой
    - Mapping.jsx: не удалять объект при фокусе в любом INPUT/TEXTAREA (панель свойств)
    - MappingToolbar.jsx: stopPropagation на Backspace/Delete в поле Текст комментария; padding 4px 5px в textarea
    - MappingCanvas.jsx: автофокус и курсор в конец при открытии редактора комментария (requestAnimationFrame); стена без синего цвета при п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
2026-01-30 WebUI: статус сети в шапке, подтверждение ухода из маппинга, стили
    - StateDataContext: глобальное состояние (сеть, Link, IP) в шапке на всех страницах
    - useApi: опция consecutiveFailuresForError (3) — ошибка только после 3 подряд сбоев
    - Убрано время работы из блока статуса в шапке
    - Стили блока статуса: высота/форма как у блока пользователя, hover-анимация
    - LeaveConfirmContext: предупреждение при уходе с маппинга с несохранённы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
2026-01-30 WebUI: права доступа, О нас, Помощь, кнопки Обновить, компактные фильтры, пагинация
    - Настройки: матрица прав с выпадающими списками, PermissionsContext, ProtectedRoute по path
    - Страницы О нас и расширенная Помощь с разделами
    - Мониторинг дверей: миниатюрная кнопка Обновить слева от «Всего дверей»
    - Журнал событий: компактная строка фильтров, кнопка Обновить справа от Источник, явное обновление событий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
2026-01-30 Конфигурация: кнопка Удалить открывает модалку сразу в режиме списка
    - Модальное окно удаления добавлено в ветку режима списка (раньше рендерилось только в режиме редактирования)
    - Упрощён обработчик кнопки Удалить, обновление списка после удаления через setTimeout(0)
2026-01-30 Маппинг: стена отрезок/прямоугольник, ровные углы; конфиг и API — лимит названия, блокировка удалённых дверей
    - Инструмент Стена: выбор формы (отрезок/прямоугольник), свойства длина/ширина, ресайз по маркерам
    - Прямоугольная стена рисуется одним path для корректного слияния линий в углах
    - Привязка к углам прямоугольных стен при рисовании
    - Увеличен лимит короткого заголовка проекта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
2026-01-30 Маппинг: стена-отрезок длина, подсветка; мониторинг по платам; блокировка в маппинге при ID-2-1
    - Стена-отрезок: параметры по умолчанию и свойство Длина (мм), синяя подсветка выбранной формы
    - Стена-прямоугольник: подсветка выбранного объекта (path.selected), клик только по контуру
    - Дверь на карте: зона выбора по ширине створки и до верха синей линии
    - Мониторинг дверей: группировка по пла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
2026-01-31 WebUI: маппинг — множественное выделение рамкой, группа, длина двери, исправления
    - Выделение нескольких объектов пунктирной рамкой (ЛКМ), перемещение и удаление группы
    - Поле «Длина двери» при вставке и в свойствах двери
    - Поворот двери на месте после перетаскивания (мерж с объектом из массива)
    - Область перетаскивания комментария ПКМ на весь текст
    - Свойства комментария при выборе и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
    [http_api.c]
2026-01-31 WebUI: маппинг — подсветка стен синим при массовом выделении
    - Стены подсвечиваются синим при выделении рамкой (sel.some вместо selectedObject?.id)
    - Ручки стены показываются только при одном выбранном объекте
2026-01-31 WebUI: панель конфигураций — кнопки Открыть/Создать/Загрузить, стили #3A6577, Сохранить как с диалогом
2026-01-31 WebUI: доработки конфигурации и модального окна двери
    - Общие параметры: чекбокс «Нет сигнализации», таймаут 0=без автосигнализации
    - Переименования: Tech ID → Порядковый номер, Тип → Состояние, Последовательный номер → Версия конфигурации
    - Модальное окно двери: компактный layout, тёмные метки, красная кнопка Сохранить
    - Поле комментария: 5/6 ширины, макс 100 символов (обрезка до 32 при сохран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
2026-02-02 NC-дверь: разблокировка по Alarm, конфиг и валидация
    - Реализована логика NC по Спецификации: окно разблокировки по импульсу Alarm,
    задержка блокировки после закрытия, приоритет LogicCore (зависимости).
    - config_format: ncUnlockWindowMs, ncLockDelayAfterCloseMs; валидация 100–60000 и 0–30000 мс.
    - doors_task: окно/задержка NC, door_is_nc_type, учёт окна в applyNormal; игнор unlock от LogicCore для закрытой NC без окна.
    - logic_core: NC не добавляются в lockRequired (упр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
2026-02-02 WebUI: кнопка Отмена в маппинге, предупреждение при выходе без сохранения
2026-02-02 doors_task: NC-дверь блокируется сразу после загрузки конфига и при старте
    - При игнорировании UNLOCK для закрытой NC явно ставим locked=1 (гонка с LogicCore)
    - В блоке 5b для NC закрытой без окна разблокировки принудительно locked=1 (старт без OPEN→CLOSE)
    - Удалён прокси (proxy.cjs), убраны упоминания из package.json, REMOTE_TESTING.md, SystemParams
    - Убран отладочный вывод в терминал (config_service, http_api, can_task)
2026-02-03 Маппинг: область карты 8 КБ, без обрезки; NC-дверь при загрузке; тип CARD_READER убран, инструмент в маппинге; прокси удалён
2026-02-03 Documentation: поэтапный план устранения проблем безопасности
    - SECURITY_REMEDIATION_PLAN.md: 8 этапов, файлы для изменений, порядок внедрения
    - WebUI: стили мониторинга (Monitoring.css), страницы Двери/События/Алармы/Статистика в стиле DCM
    - WebUI: кнопка Обновить в строке с фильтрами (Двери), надпись рядом с кнопкой (Алармы), узкие строки таблиц
    - WebUI: страницы Настройки (About, Help, Users, Profile и др.) в стиле DCM
    - Правила .cursor (comm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
2026-02-03 Безопасность: сессии и проверка токена API; редирект на логин после выгрузки конфигурации
    - API: Bearer-токены, require_auth для защищённых эндпоинтов, 401 при невалидной сессии
    - WebUI: Authorization в запросах, обработка 401, GET /api/auth/session
    - После успешной выгрузки конфигурации — редирект на /login?reason=config_applied и сообщение на странице входа
    - Документация: VERIFICATION_SECURITY_ETAP1_2.md
2026-02-03 Безопасность: этапы 3 и 4 — SHA-256 для паролей, криптостойкий токен сброса
    - password_hash.c: SHA-256(password||salt) вместо simple_hash
    - secure_random.c/h: SecureRandom_Fill (HAL RNG при наличии, иначе fallback)
    - Соль через SecureRandom_Fill; токен сброса — 32 байта RNG, hex 64 символа
    - users_service.c: генерация токена сброса из SecureRandom_Fill
    - SECURITY_REMEDIATION_PLAN: пометки о реализации этапов 3 и 4
2026-02-04 Документация: перенос .md в Documentation, обновление README
    - Все .md из корня перенесены в Documentation/ (кроме README)
    - README пересобран: ссылки на Documentation/, этапы безопасности (1–8), REST API с токеном, HTTP_DEBUG по умолчанию выключен, буферы (HTTP_BODY_MAX 8192)
    - Удалены .png и логи.txt из корня
    - Ранее: отключение HTTP/AUTH логов, исправление last_body_errno
    [config_format.h, http_api.c, http_api.h, http_server.c, http_server.h, password_hash.c, users_service.c]
2026-02-04 README: порядок по тезисному плану, цели/структура, автор
    - Упорядочен по этапам 0–14 плана (Последовательный тезисный план разработки ПО.pdf)
    - В начале: название проекта, цели, структура проекта
    - В конце: разработал Ключерев Эдуард, Doors Control Making (DCM)
    - Удалены устаревшие .md: HANDOFF_NEW_CHAT, HANDOFF_DOOR_DERGANYE, РЕШЕНИЕ_КОНФЛИКТА_GIT, РЕШЕНИЕ_ПРОБЛЕМЫ_CTRL_C_V
2026-02-05 WebUI: локализация RU/EN, проверка сессии каждые 10 мин, подписи Login/Password по языку
    - LanguageContext и переводы ru.json/en.json
    - Переключатели языка в Header и на странице входа
    - Подписи полей входа по выбранному языку, убрана красная звёздочка
    - Периодическая проверка сессии в AuthContext (обнаружение истечения 24 ч)
2026-02-20 RTC и журнал: интеграция DS3231, время в событиях, действия пользователей с именем и временем с ПК
    - DS3231: чтение/запись времени, rtc_service (Unix-конвертация), GET/POST /api/time
    - Журнал: события контроллера — время из RTC; события из UI — время с ПК (X-Client-Time)
    - Записи EVT1 (48 байт) с именем пользователя: вход, выход, сохранение конфига
    - WebUI: X-Client-Time в запросах, колонка «Пользователь» в событиях, POST /auth/logout, блок вр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
2026-03-22 HTTP: CORS POST и X-Client-Time для WebUI с localhost
    Увеличен стек httpTask (16 КБ) — POST /api/auth/login без обрыва соединения
    Made-with: Cursor
2026-03-24 Журнал/RTC/WebUI: доработана работа событий и инструменты журнала
    Добавлены события удалённых дверей Slave в журнал, исправлена запись журнала через границы страниц QSPI, реализованы очистка/сохранение/печать журнала в UI и локализация RU/EN. Также добавлена поддержка времени Asia/Jerusalem и корректная пагинация журнала по фактическому числу записей.
    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
    [Industrial Door PLC Debug.cfg]
2026-03-24 WebUI: i18n RU/EN (настройки, мониторинг, конфиг), права — шире колонки Раздел и Super Admin
    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
2026-03-24 HTTP/API: alarming и alarmReasons для удалённых дверей по CAN
    Снимок с SLAVE (STATUS) сохраняется в LogicCore; /api/doors и страница Алармы
    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
2026-03-24 Документация: сводка реализованного функционала в README
    Масштаб 8/80, CAN/Node ID, HTTP/WebUI, QSPI, RTC DS3231, статусы этапов
    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
2026-03-26 FW/WebUI: стабильность сети и расширенная очистка Flash
    Усилена обработка Ethernet/HTTP при флапах, улучшена устойчивость API и WebUI при ошибках сети, доработана очистка Flash по платам (включая отдельный опасный режим очистки служебных данных Users), а также обновлена документация README по новому поведению.
    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
2026-04-11 WebUI+FW: мониторинг дверей как старт, GET /api/buffers, без Главной и Алармов
    - Редирект / и /dashboard на /monitoring/doors; вход и логотип туда же
    - Удалены страницы Dashboard и Alarms; права и справка без раздела алармов
    - Doors: сводка журнала+дверей, обзор по платам, таблица
    - Statistics: таблицы очередей и задач по /api/buffers
    - Прошивка: метрики очередей AppEvents/AppLog/EventJournal, build_buffers_stat
    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
2026-04-11 WebUI+FW: удалена страница Статистика и GET /api/buffers
    - Убраны маршрут, меню, права, справка; в locales остались только строки для карточек на дверях (pages.statistics.*)
    - Удалены Statistics.jsx и getBufferStats; чистка Monitoring.css
    - Прошивка: убран /api/buffers и вспомогательные метрики очередей
    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
2026-04-11 WebUI и прошивка: мониторинг, журнал событий, HTTP и буферы
    - Журнал: фильтрация дверных EVT в Flash, EVT0/EVT1, дамп JSON
    - WebUI: таблица событий, фильтры, Drawing ID, баннеры обновления/экспорта
    - Мониторинг дверей: Обновить при ошибке, таймаут /doors 30 с, useApi refetch ok
    - HTTP: буфер PUT config, правки http_api/http_server, константы WebUI
    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
2026-04-11 Документация: обновить README под текущий WebUI и журнал
    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
