Morfey1974/Industrial-Door-PLC-8-Doors/(notices)

Notices in the files:
Core/Src/main.c:
Copyright (c) 2025 STMicroelectronics.
All rights reserved.
This software is licensed under terms that can be found in the LICENSE file
Core/Inc/main.h:
Copyright (c) 2022 STMicroelectronics.
